twilkers1976/Omnisensor-dsp-board/README.md

# omnisensorv2
kicad 10.03 schematic and pcb project
#omni_cpu_board
