twilkers1976/Omnisensor-dsp-board/bom.csv

Qty | Reference | Value | Part Number | Manufacturer | Rating | Footprint | Datasheet | DNP
72 | C1,C2,C3,C4,C5,C6,C13,C14,C15,C16,C17,C18,C19,C20,C21,C22,C23,C24,C25,C26,C27,C28,C29,C30,C31,C32,C33,C34,C37,C40,C61,C63,C65,C66,C67,C68,C69,C70,C87,C88,C89,C91,C122,C123,C124,C141,C143,C144,C145,C146,C147,C148,C149,C150,C151,C152,C153,C154,C155,C160,C237,C238,C241,C242,C248,C250,C253,C259,C263,C268,C269,C270 | 0.1uf | 04025C104KAT2A | Kyocera AVX | 50V | Capacitor_SMD:C_0402_1005Metric | ~
11 | C7,C8,C9,C10,C11,C12,C113,C114,C115,C135,C158 | 10uf | EMK212BJ106KG-T | Taiyo Yuden | 16V | Capacitor_SMD:C_0805_2012Metric | https://mm.digikey.com/Volume0/opasdata/d220001/medias/docus/8412/587_mlcc01hqAUTOe.pdf
43 | C35,C36,C38,C39,C41,C42,C43,C44,C45,C46,C47,C48,C49,C50,C51,C52,C55,C56,C57,C58,C59,C60,C76,C77,C79,C80,C81,C82,C83,C84,C85,C86,C90,C92,C116,C239,C240,C244,C245,C249,C252,C254,C257 | 0.01uf | 04025C103KAT2A | Kyocera AVX | 50V | Capacitor_SMD:C_0402_1005Metric | ~
2 | C53,C140 | 1000pf | CHV1808N3K0102MXT | Samsung Electro-Mechanics | 3KV | Capacitor_SMD:C_1808_4520Metric | https://mm.digikey.com/Volume0/opasdata/d220001/medias/docus/658/CL10B473KO8NNNC_Spec.pdf
1 | C54 | 0.047uf | CL10B473KO8NNNC | Samsung Electro-Mechanics | 16V | Capacitor_SMD:C_0603_1608Metric | https://mm.digikey.com/Volume0/opasdata/d220001/medias/docus/658/CL10B473KO8NNNC_Spec.pdf
3 | C62,C71,C74 | 10uf | GRM188R61C106MAALD | Murata | 16V | Capacitor_SMD:C_0603_1608Metric | ~
6 | C64,C119,C121,C136,C137,C142 | 1.0uf | EMK105BJ105KV-F | Taiyo Yuden | 16V | Capacitor_SMD:C_0402_1005Metric | https://mm.digikey.com/Volume0/opasdata/d220001/medias/docus/272/mlcc02_e-1307760.pdf
1 | C72 | 22uf | C1608X5R0J226M080AC | Murata | 6.3V | Capacitor_SMD:C_0603_1608Metric | ~
1 | C73 | 4.7uf | JMK105BBJ475MV-F | Taiyo Yuden | 6.3V | Capacitor_SMD:C_0402_1005Metric | ~
1 | C75 | 220uf | GMC31X5R227M6R3NT | Cal-chip | 6.3V | Capacitor_SMD:C_1206_3216Metric | ~
1 | C78 | 100pf | KGM05AR71H101KH | Kyocera AVX | 50V | Capacitor_SMD:C_0402_1005Metric | ~
1 | C93 | 100pf | CHV0603N250101FCT | Cal Chip | 250V | Capacitor_SMD:C_0603_1608Metric | https://calchip.com/wp-content/uploads/2026/01/CHV-Series.pdf
1 | C94 | 0.047uf | C0805C473F4GACTU | Kemet | 16V | Capacitor_SMD:C_0805_2012Metric | https://mm.digikey.com/Volume0/opasdata/d220001/medias/docus/658/CL10B473KO8NNNC_Spec.pdf
1 | C95 | 0.01uf | KGM15AR71C103KT | Kyocera AVX | 16V | Capacitor_SMD:C_0603_1608Metric | https://mm.digikey.com/Volume0/opasdata/d220001/medias/docus/658/CL10B473KO8NNNC_Spec.pdf
1 | C96 | 10uf | PCV2A100MCL1GS | Nichicon | 100V | omnisensor:PNSC-FT-V-83x83-2_V | https://www.nichicon.co.jp/english/series_items/catalog_pdf/e-pcv.pdf
1 | C97 | 2.2uf | GRM32ER72A225KA35L | Murata | 100V | Capacitor_SMD:C_1210_3225Metric | https://datasheets.kyocera-avx.com/KGM_X7R.pdf
2 | C98,C107 | 10uf | C1206C106M4RACAUTO | KEMET | 16V | Capacitor_SMD:C_1206_3216Metric | https://datasheets.kyocera-avx.com/KGM_X7R.pdf,https://mm.digikey.com/Volume0/opasdata/d220001/medias/docus/8890/CL31B106MOHNNNE.pdf
1 | C99 | 0.1uf | KGM15BR71H104KT | Kyocera AVX | 50V | Capacitor_SMD:C_0603_1608Metric | https://calchip.com/wp-content/uploads/2026/01/CHV-Series.pdf
5 | C100,C105,R82,R96,R100 | DNP-OPT |  | Vishay Dale | 1/4 W,2KV | Capacitor_SMD:C_0402_1005Metric,Capacitor_SMD:C_1812_4532Metric,Resistor_SMD:R_0603_1608Metric,Resistor_SMD:R_0805_2012Metric,Resistor_SMD:R_1206_3216Metric | https://www.vishay.com/docs/20035/dcrcwe3.pdf | DNP
1 | C101 | 3.3nf | C0603C332J4GACTU | Kemet | 16V | Capacitor_SMD:C_0603_1608Metric | https://calchip.com/wp-content/uploads/2026/01/CHV-Series.pdf
1 | C102 | 47pf | CHV1206N1K0470FCT | Cal Chip | 1KV | Capacitor_SMD:C_1206_3216Metric | https://calchip.com/wp-content/uploads/2026/04/GMC-Series-1.pdf
1 | C103 | 220pf | CHV0603N250221GCT | Cal Chip | 250V | Capacitor_SMD:C_0603_1608Metric | https://calchip.com/wp-content/uploads/2026/01/CHV-Series.pdf
5 | C104,C235,C236,C251,C256 | 1uf | 06035C105KAT2A | Kyocera AVX | 50V | Capacitor_SMD:C_0603_1608Metric
1 | C106 | 4.7nf | 885012210005 | Wurth Elektronik | 25V | Capacitor_SMD:C_1812_4532Metric | https://www.we-online.com/components/products/datasheet/885012210005.pdf
1 | C108 | 470pf | GRM31A7U2J471JW31D | Murata | 600V | Capacitor_SMD:C_1206_3216Metric | https://calchip.com/wp-content/uploads/2026/04/GMC-Series-1.pdf
1 | C109 | 2.2nf | GRM188R72A222KA01D | Murata | 25V | Capacitor_SMD:C_0603_1608Metric | https://www.we-online.com/components/products/datasheet/885012210005.pdf
2 | C110,C112 | DNP-OPT | C1206C106M4RACAUTO | KEMET | 16V | Capacitor_SMD:C_1206_3216Metric | https://datasheets.kyocera-avx.com/KGM_X7R.pdf | DNP
1 | C111 | 22uf | 16SVP22M | Panasonic | 16V | omnisensor:CAP_16SVP22M | https://industrial.panasonic.com/ww/products/pt/os-con/models/16SVP22M
2 | C117,C118 | 4700pf | GCM155R71H472KA37D | Murata | 50V | Capacitor_SMD:C_0402_1005Metric | ~
1 | C120 | 3000pf | GMC04X7R302K50NT | Murata | 50V | Capacitor_SMD:C_0402_1005Metric | ~
11 | C125,C126,C127,C128,C129,C130,C131,C132,C133,C156,C157 | 47uf | JMK212BJ476MG-T | Taiyo Yuden | 6.3V | Capacitor_SMD:C_0805_2012Metric | ~
5 | C134,C260,C261,C262,C264 | 4.7uf | CL10A475MA8NQNC | Kyocera | 25V | Capacitor_SMD:C_0603_1608Metric | ~
1 | C138 | 4.7uf | C1210C475K3RACTU | Kemet | 25V | Capacitor_SMD:C_1210_3225Metric | https://mm.digikey.com/Volume0/opasdata/d220001/medias/docus/8412/587_mlcc01hqAUTOe.pdf
1 | C139 | 120uf | A700X127M010ATE010 | KEMET | 10V | omnisensor:CAP_X-7343-43_KEM | https://yageogroup.com/content/datasheet/asset/file/KEM_T2091_A700-A720
1 | C159 | 12nf | GCM155R71H122KA37D | Murata | 50V | Capacitor_SMD:C_0402_1005Metric | ~
3 | C233,C234,C255 | 4.7uf | CL21A475KBQNNNE | Murata | 50V | Capacitor_SMD:C_0805_2012Metric
1 | C294 | 1uf | CL21B105KOFVPNE | Samsung | 16V | Capacitor_SMD:C_0805_2012Metric | https://mm.digikey.com/Volume0/opasdata/d220001/medias/docus/658/CL10B473KO8NNNC_Spec.pdf
1 | D1 | DDZ9709S-7 | DDZ9709S-7 | Diodes Incorporated | 24V | omnisensor:DDZ9709S-7
3 | D2,D5,D7 | PTVS58VS1UR,115 | PTVS58VS1UR,115 | Nexperia |  | omnisensor:TVS_PTVS58VS1UR | https://assets.nexperia.com/documents/data-sheet/PTVSXS1UR_SER.pdf
1 | D3 | 1SS389,L3F | 1SS389,L3F | Comchip |  | Diode_SMD:D_SOD-523 | https://www.digikey.com/en/products/detail/comchip-technology/1SS389-G/6138895
1 | D4 | B2100-13-F | B2100-13-F | Diodes Inc |  | omnisensor:DIOM5336X250N | https://www.diodes.com/part/view/B2100
1 | D6 | BAV19WS | BAV19WS | Diotec |  | Diode_SMD:D_SOD-323F | https://diotec.com/request/datasheet/bav19ws.pdf
1 | D8 | BAT46WJ_115 | BAT46WJ,115 | Nexperia |  | omnisensor:SOD323_V | https://assets.nexperia.com/documents/data-sheet/BAT46WJ.pdf
1 | D9 | DNP-OPT | BAT46WJ_115 | Nexperia |  | omnisensor:SOD323_V | https://assets.nexperia.com/documents/data-sheet/BAT46WJ.pdf | DNP
1 | D10 | SI4204DY-T1-GE3 | SI4204DY-T1-GE3 | Vishay Siliconix |  | omnisensor:SOIC8_MS-012_VIS | https://www.vishay.com/docs/65154/si4204dy.pdf
1 | D11 | CDBA340-G | CDBA340-G | ComChip |  | omnisensor:CDBA-G | https://mm.digikey.com/Volume0/opasdata/d220001/medias/docus/916/CDBA320-G_%7E_CDBA3100-G.pdf
1 | D12 | MBR0540T1G | MBR0540T1G | onsemi |  | omnisensor:SOD-123 | https://www.onsemi.com/pdf/datasheet/mbr0540t1-d.pdf
4 | D13,D16,D21,D25 | Red | B1911USD-20D000114U1930 | Harvatek |  | omnisensor:LED_B1931NG_HVK | B1931NG--20D001114U1930
5 | D14,D17,D18,D19,D22 | Green | B1931NG--20D001114U1930 | Harvatek |  | omnisensor:LED_B1931NG_HVK | B1931NG--20D001114U1930
2 | D15,D20 | Yellow | KY EELP41.22 Q2T1-36-A8J8-020-R18 | OSRAM |  | omnisensor:LED_B1931NG_HVK | B1931NG--20D001114U1930
1 | D23 | RGB LED | UHD111A-FKA-C3K23E1L3VG5ZB3Z3 | Cree LED |  | omnisensor:SMD4_UHD111A-FKA_CRW | UHD111A-FKA-C3K23E1L3VG5ZB3Z3
1 | D24 | Blue | B19Y1NB--20C000113U1930 | Harvatek |  | omnisensor:LED_B1931NG_HVK | B1931NG--20D001114U1930
1 | E1 | AUX+ | MILLMAX 2501-2 |  |  | TestPoint:TestPoint_THTPad_D1.0mm_Drill0.5mm
1 | E2 | AUX- | MILLMAX 2501-2 |  |  | TestPoint:TestPoint_THTPad_D1.0mm_Drill0.5mm
1 | E4 | GND_SEC | MILLMAX 2501-2 |  |  | TestPoint:TestPoint_THTPad_D1.0mm_Drill0.5mm
1 | E5 | GND | MILLMAX 2501-2 |  |  | TestPoint:TestPoint_THTPad_D1.0mm_Drill0.5mm
5 | FB1,FB2,FB3,FB8,FB9 | MPZ2012S101AT000 | MPZ2012S101AT000 | TDK | 4A, 100 ohm,4A, 100ohm | Inductor_SMD:L_0805_2012Metric | https://product.tdk.com/system/files/dam/doc/product/emc/emc/beads/catalog/beads_commercial_power_mpz2012_en.pdf
4 | FB4,FB5,FB6,FB7 | 600 | 742863160 | Würth Elektronik |  | Inductor_SMD:L_0603_1608Metric_Pad1.05x0.95mm_HandSolder | https://www.digikey.com/en/products/detail/w%C3%BCrth-elektronik/742863160/2268591
1 | J1 | JXK0-0190NL | JXK0-0190NL | Pulse |  | omnisensor:JK0-0177NL_PUL | https://yageogroup.com/content/datasheet/asset/file/DATASHEET_J432
1 | J2 | BMODE | 2PH1-03-UA | Adam Tech |  | Connector_PinHeader_2.00mm:PinHeader_1x03_P2.00mm_Vertical | https://www.digikey.com/en/products/detail/adam-tech/2PH1-03-UA/9830409?s=N4IgTCBcDa4AoAkCMBaADAZhQVQIIgF0BfIA
1 | J3 | JTAG | 3220-10-0300-00 | CNC Tech |  | omnisensor:CNC_3220-10-0300-00 | ~
2 | J4,J20 | USB4105-GF-A | USB4105-GF-A | GCT |  | omnisensor:GCT_USB4105-GF-A | https://gct.co/files/specs/usb4105-spec.pdf
1 | J5 | 2PH1-02-UA | 2PH1-02-UA | Adam Tech |  | Connector_PinHeader_2.00mm:PinHeader_1x02_P2.00mm_Vertical | https://app.adam-tech.com/products/download/data_sheet/200457/2ph1-xx-ua-data-sheet.pdf
1 | J6 | DNP-PH1RB-09-UA | PH1RB-09-UA | Adam Tech |  | Connector_PinHeader_2.54mm:PinHeader_1x09_P2.54mm_Vertical | https://www.adafruit.com/product/4682 | DNP
1 | J7 | TSW-102-07-F-S | TSW-102-07-F-S | Samtec | 3A | Connector_PinHeader_2.54mm:PinHeader_1x02_P2.54mm_Vertical
1 | J8 | 2PH2R-10-UA | 2PH2R-10-UA | Adam Tech |  | Connector_PinHeader_2.00mm:PinHeader_2x05_P2.00mm_Vertical | https://app.adam-tech.com/products/download/data_sheet/199986/2ph2r-xx-ua-data-sheet.pdf
1 | J9 | SM04B-SRSS-TB | SM04B-SRSS-TB | JST |  | omnisensor:JST_SM04B-SRSS-TB(LF)(SN) | https://www.jst-mfg.com/product/pdf/eng/eSH.pdf
1 | J10 | EJ508A | EJ508A | MPD |  | omnisensor:MPD_EJ508A | https://www.memoryprotectiondevices.com/datasheets/EJ508A/EJ508A-datasheet.pdf
1 | J11 | DNP-PH1RB-05-UA | PH1RB-05-UA | Adam Tech |  | Connector_PinHeader_2.54mm:PinHeader_1x05_P2.54mm_Vertical | https://www.adafruit.com/product/6250 | DNP
2 | J12,J17 | TBP03R1-350-02BE | TBP03R1-350-02BE | Same Sky |  | omnisensor:CUI_TBP03R1-350-02BE | https://www.sameskydevices.com/product/resource/tbp03r1-350.pdf
1 | J14 | 2PH1R-05-UA | 2PH1R-05-UA | Adam Tech |  | Connector_PinHeader_2.00mm:PinHeader_1x05_P2.00mm_Vertical | https://www.adafruit.com/product/6250
1 | J16 | 0791091011 | 0791091011 | Molex |  | Connector_PinSocket_2.00mm:PinSocket_2x12_P2.00mm_Vertical_SMD | https://www.molex.com/content/dam/molex/molex-dot-com/products/automated/en-us/salesdrawingpdf/791/79109/791091011_sd.pdf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
1 | K1 | 1462042-3 | 1462042-3 | TE Connectivity |  | omnisensor:1462042-3 | https://www.te.com/commerce/DocumentDelivery/DDEController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
1 | L1 | 744272332 | 744272332 | Würth Elektronik |  | omnisensor:WE-SL5_BIFILAR | https://www.we-online.com/components/products/datasheet/744272332.pdf
1 | L2 | 10uh | DO1608C-103MLC | Coilcraft | 1.5A | omnisensor:IND_DO1608C_COC | https://www.coilcraft.com/getmedia/4cc14c66-6f6e-44d5-bdfa-285965aec659/do1608c.pdf
1 | L3 | 100uh | DO1608C-104MLC | Coilcraft | 500mA | omnisensor:IND_DO1608C_COC | https://www.coilcraft.com/getmedia/4cc14c66-6f6e-44d5-bdfa-285965aec659/do1608c.pdf
1 | L4 | 330nh | DO1813H-331MLD | Coilcraft | 7A | omnisensor:DO1813H | https://www.coilcraft.com/getmedia/eceb5548-303f-4cbf-872a-303f3b222949/do1813h.pdf
1 | L5 | 3.3uH | 74438335033HT | Würth Elektronik | 2.7A | omnisensor:WE-MAPI_3015 | https://www.we-online.com/components/products/datasheet/74438335033HT.pdf
1 | L6 | 1uH | 74438335010HT | Würth Elektronik | 4.5A | omnisensor:WE-MAPI_3015 | https://www.we-online.com/components/products/datasheet/74438335010HT.pdf
1 | L7 | 2.2uH | 74438335022HT | Würth Elektronik | 3.2A | omnisensor:WE-MAPI_3015 | https://www.we-online.com/components/products/datasheet/74438335022HT.pdf
1 | L8 | 33uH | 74438335330 | Würth Elektronik | 500mA | omnisensor:WE-MAPI_3015 | https://www.we-online.com/components/products/datasheet/74438335330.pdf
9 | Q1,Q2,Q3,Q4,Q5,Q6,Q7,Q8,Q9 | PSMN075-100MSE | PSMN075-100MSE | Nexperia |  | omnisensor:TRANS_PSMN075-100MSE | https://assets.nexperia.com/documents/data-sheet/PSMN075-100MSE.pdf
1 | Q10 | FJV992FMTF | FJV992FMTF | Onsemi |  | omnisensor:SOT91P240X120-3N | https://www.onsemi.com/pdf/datasheet/fjv992-d.pdf
1 | Q11 | XP10TN135N | XP10TN135N | YAGEO SEMI |  | omnisensor:SOT95P251X112-3N | https://www.mouser.com/datasheet/3/508/1/XP10TN135N.pdf
1 | Q12 | BSZ520N15NS3G | BSZ520N15NS3GATMA1 | Infineon |  | omnisensor:SON65P330X330X110-9N | https://www.infineon.com/assets/row/public/documents/24/49/infineon-bsz520n15ns3-ds-en.pdf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
1 | Q13 | MMBT3906 | MMBT3906 | Diotec Semiconductor |  | Package_TO_SOT_SMD:SOT-23 | https://www.onsemi.com/pdf/datasheet/pzt3906-d.pdf
1 | Q14 | FDMC86160 | FDMC86160 | Onsemi |  | omnisensor:TRANS_FDMC86102 | https://www.onsemi.com/pdf/datasheet/fdmc86160-d.pdf
1 | Q15 | MMBT3904 | MMBT3904 | Diotec Semiconductor |  | Package_TO_SOT_SMD:SOT-23 | https://www.onsemi.com/pdf/datasheet/pzt3904-d.pdf
1 | Q16 | PUMH13 | PUMH13 | Nexperia |  | omnisensor:SOP65P210X110-6N | https://assets.nexperia.com/documents/data-sheet/PUMH13.pdf
4 | R1,R2,R3,R4 | 75 | RN73H1JTTD75R0F100 | KOA |  | Resistor_SMD:R_0603_1608Metric | ~
7 | R5,R45,R59,R81,R85,R101,R103 | 0 | RMCF0402ZT0R00 | Stackpole |  | Resistor_SMD:R_0402_1005Metric | https://www.vishay.com/docs/20035/dcrcwe3.pdf,~
10 | R6,R7,R8,R9,R10,R11,R12,R13,R14,R16 | 3.3K | RMCF0402FT3K3 | Stackpole |  | Resistor_SMD:R_0402_1005Metric | ~
25 | R15,R17,R18,R19,R20,R21,R22,R31,R33,R35,R39,R40,R41,R62,R121,R122,R123,R131,R132,R226,R227,R228,R229,R230,R231 | 33 | RMCF0402FT33R0 | Stackpole |  | Resistor_SMD:R_0402_1005Metric | ~
7 | R23,R24,R25,R66,R67,R68,R257 | 1.0K | RMCF0402FT1K00 | Stackpole | 1/16 W | Resistor_SMD:R_0402_1005Metric | ~
45 | R26,R27,R28,R29,R34,R36,R37,R38,R48,R49,R50,R51,R52,R83,R86,R108,R111,R113,R117,R120,R124,R125,R126,R127,R128,R129,R130,R137,R138,R140,R232,R235,R236,R238,R240,R289,R290,R291,R292,R293,R294,R295,R296,R297,R298 | 10K | RMCF0402FT10K0 | Stackpole |  | Resistor_SMD:R_0402_1005Metric | ~
3 | R30,R32,R133 | DNP-33 | RMCF0402FT33R0 | Stackpole |  | Resistor_SMD:R_0402_1005Metric | ~ | DNP
1 | R42 | 3.01k | RMCF0402FT3K01 | Stackpole |  | Resistor_SMD:R_0402_1005Metric
4 | R43,R44,R46,R47 | 2K | RMCF0402FT2K00 | Stackpole |  | Resistor_SMD:R_0402_1005Metric | ~
2 | R53,R63 | DNP-10K | RMCF0402FT10K | Stackpole |  | Resistor_SMD:R_0402_1005Metric | ~ | DNP
7 | R54,R55,R56,R57,R58,R135,R136 | 100 | RMCF0402FT100R | Stackpole |  | Resistor_SMD:R_0402_1005Metric | ~
1 | R60 | DNP-0 | RMCF0603FT0R | Stackpole |  | Resistor_SMD:R_0603_1608Metric | ~ | DNP
1 | R61 | 2K | RMCF0402FT2K0 | Stackpole |  | Resistor_SMD:R_0402_1005Metric | ~
1 | R64 | 34 | RMCF0402FT34R0 | Stackpole |  | Resistor_SMD:R_0402_1005Metric | ~
1 | R65 | 240 | RMCF0402FT240R | Stackpole |  | Resistor_SMD:R_0402_1005Metric | ~
1 | R69 | 200 | RMCF0402FT200R | Stackpole |  | Resistor_SMD:R_0402_1005Metric | ~
1 | R70 | 174K | RN73H1JTTD1743F100 | KOA |  | Resistor_SMD:R_0603_1608Metric | https://www.koaspeer.com/pdfs/RN73H.pdf
1 | R71 | 53.2K | RN73H1JTTD5232F100 | KOA |  | Resistor_SMD:R_0603_1608Metric | https://www.koaspeer.com/pdfs/RN73H.pdf
1 | R72 | 8.2 | CRCW08058R20FKEA | Vishay Dale | 1/4 Watt | Resistor_SMD:R_0805_2012Metric | https://www.vishay.com/docs/20035/dcrcwe3.pdf
1 | R73 | 3.3K | RN73H1JTTD3301F100 | KOA | 1/10 Watt | Resistor_SMD:R_0603_1608Metric | https://www.vishay.com/docs/20035/dcrcwe3.pdf
2 | R74,R119 | 2K | RN73H1JTTD2001F100 | KOA | 1/10 W | Resistor_SMD:R_0603_1608Metric | https://www.vishay.com/docs/20035/dcrcwe3.pdf
1 | R75 | 6.49K | RN73H1JTTD6491F100 | KOA | 1/10 W | Resistor_SMD:R_0603_1608Metric | https://www.koaspeer.com/pdfs/RN73H.pdf
1 | R76 | DNP-OPT | RN73H1JTTD1001F100 | KOA | 1/10 W | Resistor_SMD:R_0603_1608Metric | https://www.vishay.com/docs/20035/dcrcwe3.pdf
1 | R77 | 35.7 | CRCW080535R7FKEA | Vishay Dale | 1/4 W | Resistor_SMD:R_0805_2012Metric | https://www.vishay.com/docs/20035/dcrcwe3.pdf
1 | R78 | 5.23K | RN73H1JTTD5231F100 | KOA | 1/10 W | Resistor_SMD:R_0603_1608Metric | https://www.koaspeer.com/pdfs/RN73H.pdf
1 | R79 | 20 | CRCW080520R0FKEA | Vishay Dale | 1/4 Watt | Resistor_SMD:R_0805_2012Metric | https://www.vishay.com/docs/20035/dcrcwe3.pdf
1 | R80 | 107K | RN73H1JTTD1073F100 | KOA | 1/4 W | Resistor_SMD:R_0603_1608Metric | https://www.seielect.com/catalog/SEI-RNCP.pdf
1 | R84 | 26.1K | RN73H1JTTD2612F100 | KOA |  | Resistor_SMD:R_0603_1608Metric | https://www.koaspeer.com/pdfs/RN73H.pdf
1 | R87 | 150 | RK73H2BTTD1500F | KOA | 1/4 W | Resistor_SMD:R_1206_3216Metric | https://www.seielect.com/catalog/SEI-RNCP.pdf
1 | R88 | 40m | PE0603FRF070R04L | Yageo | 1/10 W | Resistor_SMD:R_0603_1608Metric | https://www.vishay.com/docs/20035/dcrcwe3.pdf
1 | R89 | 100 | RN73H1JTTD1000F100 | KOA | 1/10 W | Resistor_SMD:R_0603_1608Metric | https://www.vishay.com/docs/20035/dcrcwe3.pdf
2 | R90,R91 | 27 | CRCW120627R0FKEAC | Vishay Dale | 1/4 W | Resistor_SMD:R_1206_3216Metric | https://www.seielect.com/catalog/SEI-RNCP.pdf
1 | R92 | 47K | RN73H1JTTD4702F100 | KOA | 1/10 W | Resistor_SMD:R_0603_1608Metric | ~
1 | R93 | 4.7K | RN73H1JTTD4701F100 | KOA | 1/10 W | Resistor_SMD:R_0603_1608Metric | ~
1 | R94 | 15 | RN73H1JTTD15R0F100 | KOA | 1/10 W | Resistor_SMD:R_0603_1608Metric | https://www.vishay.com/docs/20035/dcrcwe3.pdf
1 | R95 | 10K | RN73H1JTTD1002F100 | KOA | 1/10W | Resistor_SMD:R_0603_1608Metric
1 | R97 | 3.3K | RMCF0402FT3K30 | KOA | 1/10 W | Resistor_SMD:R_0402_1005Metric | https://www.vishay.com/docs/20035/dcrcwe3.pdf
2 | R98,R107 | 32.4K | RMCF0402FT32K4 | Stackpole |  | Resistor_SMD:R_0402_1005Metric | ~
1 | R99 | 4.3K | RMCF0402FT4K30 | Stackpole |  | Resistor_SMD:R_0402_1005Metric | ~
5 | R102,R104,R114,R246,R247 | 5.1K | RMCF0402FT5K10 | Stackpole |  | Resistor_SMD:R_0402_1005Metric | ~
2 | R105,R106 | 22K | RMCF0402FT22K0 | Stackpole |  | Resistor_SMD:R_0402_1005Metric | ~
1 | R109 | 3.74K | RMCF0402FT3K74 | Stackpole |  | Resistor_SMD:R_0402_1005Metric | ~
1 | R110 | 31.6K | RMCF0402FT31K6 | Stackpole |  | Resistor_SMD:R_0402_1005Metric | ~
1 | R112 | 8.66K | RMCF0402FT8K66 | Stackpole |  | Resistor_SMD:R_0402_1005Metric | ~
2 | R115,R250 | 1M | RMCF0402FT1M00 | Stackpole |  | Resistor_SMD:R_0402_1005Metric | ~
2 | R116,R252 | PTC | 0603L050YR | Littlefuse |  | Resistor_SMD:R_0603_1608Metric | ~
2 | R118,R303 | 0 | RMCF0805ZT0R00 | Stackpole |  | Resistor_SMD:R_0805_2012Metric | ~
2 | R134,R142 | 0 | RMCF1210ZT0R00 | Stackpole |  | Resistor_SMD:R_1210_3225Metric | ~
1 | R139 | 52.3K | RMCF0402FT52K3 | Stackpole |  | Resistor_SMD:R_0402_1005Metric | ~
1 | R141 | 35.8K | RMCF0402FT35K7 | Stackpole |  | Resistor_SMD:R_0402_1005Metric | ~
2 | R224,R225 | 1.5k | RMCF0402FT1K50 | Stackpole |  | Resistor_SMD:R_0402_1005Metric
3 | R237,R239,R241 | DNP-10K | RMCF0402FT10K0 | Stackpole |  | Resistor_SMD:R_0402_1005Metric |  | DNP
2 | R242,R243 | 680 | RMCF0402FT680R | Stackpole |  | Resistor_SMD:R_0402_1005Metric
1 | R244 | 124.0k | RMCF0402FT124K | Stackpole |  | Resistor_SMD:R_0402_1005Metric
1 | R245 | 100k | RMCF0402FT100K | Stackpole |  | Resistor_SMD:R_0402_1005Metric
1 | R254 | 22.1K | RMCF0402FT22K1 | Stackpole |  | Resistor_SMD:R_0402_1005Metric | ~
1 | R255 | 47.5K | RMCF0402FT47K5 | Stackpole |  | Resistor_SMD:R_0402_1005Metric | ~
6 | RN1,RN2,RN3,RN4,RN5,RN6 | 100 ohm | EXB-28V101JX | Panasonic |  | omnisensor:RESCAXS50P200X100X45-8N | ~
3 | RV1,RV2,RV3 | SDV1608E140C300NPT | SDV1608E140C300NPT | Shenzhen Sunlord |  | Resistor_SMD:R_0603_1608Metric | https://media.digikey.com/pdf/Data%20Sheets/Shenzhen%20Sunlord/SDV_Part_Numbering.pdf
3 | S1,S2,S3 | R-667843 | R-667843 | Mitsumi |  | omnisensor:R-667843_MIT | https://mm.digikey.com/Volume0/opasdata/d220001/medias/docus/2604/SOV-168HNT_7843_1.9N_ENG_%2319.pdf
1 | T1 | 750310742 | 750310742 | Würth Elektronik |  | omnisensor:WE-POE__EP13_PADL1.55W1.27 | https://www.we-online.com/components/products/datasheet/750310742.pdf
1 | T2 | PE-68386NL | PE-68386NL | Pulse Electronics Corporation |  | omnisensor:PE-68386NL_PUL | PE-68386NL
2 | TH1,TH2 | Thermistor_PTC | V5.5MLA0603NH | Littlefuse |  | Resistor_SMD:R_0603_1608Metric_Pad0.98x0.95mm_HandSolder | ~
4 | TP1,TP2,TP3,TP5 | TestPoint |  |  |  | TestPoint:TestPoint_Pad_D1.0mm
1 | TP4 | TP_12V |  |  |  | TestPoint:TestPoint_Pad_D1.0mm
1 | U1 | LT4321IUF_PBF | LT4321IUF#PBF | Analog Devices |  | omnisensor:LT4321IUF_PBF
1 | U2 | ADSP-SC573KBCZ-3 | ADSP-SC573KBCZ-3 | Analog Devices |  | omnisensor:BC-400-2_ADI | ADSP-SC573KBCZ-3
1 | U3 | SI5351B-B-GM | SI5351B-B-GM | Silicon Labs |  | omnisensor:QFN50P400X400X90-21N | https://www.skyworksinc.com/-/media/Skyworks/SL/documents/public/data-sheets/Si5351-B.pdf
1 | U4 | ADM6315 | ADM6315-29D2ARTZR7 | Analog Devices |  | omnisensor:RA_4_ADI | https://www.analog.com/media/en/technical-documentation/data-sheets/ADM6315.pdf
1 | U5 | MIC5166YML-TR | MIC5166YML-TR | Microchip |  | omnisensor:MLF-10_ML_MCH | https://ww1.microchip.com/downloads/aemDocuments/documents/OTH/ProductDocuments/DataSheets/MIC5166-3A-High-Speed-Low-VIN-DDR-Terminator-DS20006085B.pdf
1 | U6 | IS43TR16128DL-125KBL | IS43TR16128DL-125KBL | ISSI |  | omnisensor:BGA80P96C6X16_800X1400X110
1 | U7 | LT4276BIUFDTRPBF | LT4276BIUFD#TRPBF | Analog Devices |  | omnisensor:QFN-28_UFD | https://www.analog.com/media/en/technical-documentation/data-sheets/4276fa.pdf
2 | U8,U34 | ESDA5V3SC6 | ESDA5V3SC6 | ST Microelectronics |  | omnisensor:SOT23-6L | https://www.digikey.com/en/products/detail/stmicroelectronics/ESDA5V3SC6/1037980
1 | U9 | MOC207M | MOC207M | FAIRCHILD SEMICONDUCTOR |  | omnisensor:SOIC8_751DZ_ONS_OSI | https://www.onsemi.com/pdf/datasheet/moc217m-d.pdf
1 | U10 | ADP5054ACPZ-R7 | ADP5054ACPZ-R7 | Analog Devices |  | omnisensor:CP_48_13_ADI | https://www.analog.com/media/en/technical-documentation/data-sheets/ADP5054.pdf
2 | U11,U36 | SP3003-02JTG | SP3003-02JTG | Littelfuse Inc. |  | omnisensor:SOT65P220X110-5N | https://www.littelfuse.com/assetdocs/littelfuse-tvs-diode-array-sp3003-datasheet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
1 | U12 | MIC2025-2YMM-TR | MIC2025-2YMM-TR | Microchip |  | omnisensor:MSOP-8_MM_MCH | https://ww1.microchip.com/downloads/aemDocuments/documents/OTH/ProductDocuments/DataSheets/MIC2025-2075-Single-Channel-Power-Distribution-Switch-DS20006030A.pdf
1 | U13 | SN74LVC2G241DCUR | SN74LVC2G241DCUR | Nexperia |  | omnisensor:DCU8 | https://www.ti.com/lit/gpn/sn74lvc2g241
1 | U15 | MAX31875R0TZS_T | MAX31875R0TZS+T | Maxim Integrated |  | omnisensor:BGA4N40P2X2_83X83X37N | https://www.analog.com/media/en/technical-documentation/data-sheets/max31875.pdf
1 | U16 | MX52LM04A11XSI | MX52LM04A11XSI | Macronix |  | omnisensor:BGA153N50P14X14_1300X1150X100N | https://www.mxic.com.tw/Lists/Datasheet/Attachments/9244/MX52LM04A11_Consumer,%203V,%204GB,%20v1.3.pdf
1 | U17 | W25Q128JVPIM | W25Q128JVPIM | Winbond |  | Package_SON:WSON-8-1EP_6x5mm_P1.27mm_EP3.4x4mm | https://www.winbond.com/resource-files/w25q128jv_dtr%20revc%2003272018%20plus.pdf
1 | U32 | ADIN1300CCPZ | ADIN1300CCPZ | Analog Devices |  | omnisensor:QFN50P600X600X80-41N | https://www.analog.com/media/en/technical-documentation/data-sheets/ADIN1300.pdf
1 | U33 | ADP123AUJZ-R7 | ADP123AUJZ-R7 | Analog Devices |  | omnisensor:UJ-5_ADI | https://www.analog.com/media/en/technical-documentation/data-sheets/ADP122_123.pdf
1 | U38 | CP2102N-A02-GQFN24R | CP2102N-A02-GQFN24R | Silicon Labs |  | omnisensor:QFN24_SIL-M | https://www.silabs.com/documents/public/data-sheets/cp2102n-datasheet.pdf
1 | Y1 | 25 Mhz | ABM8-25.000MHZ-10-B1U-T | Abracon |  | omnisensor:CRYSTAL_4SMD_3.2MM_2.5MM | ~
2 | Y2,Y3 | 25 Mhz | ECS-2520S33-250-FN-TR | ECS |  | omnisensor:OSC_4SMD_2.5MM_2.0MM | https://www.mouser.com/datasheet/3/294/1/ECS_2520S.pdf
