twilkers1976/Omnisensor-dsp-board/3d/MIC5166YML-TR.STEP

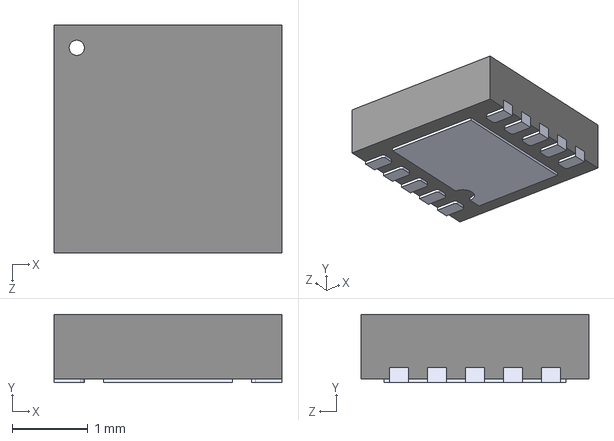
[picture p1: CAD file, 2026-10-08]
3d/MIC5166YML-TR.STEP
3.00 x 0.9 x 3.00 mm
