twilkers1976/Omnisensor-dsp-board/3d/SMB_DIO.step

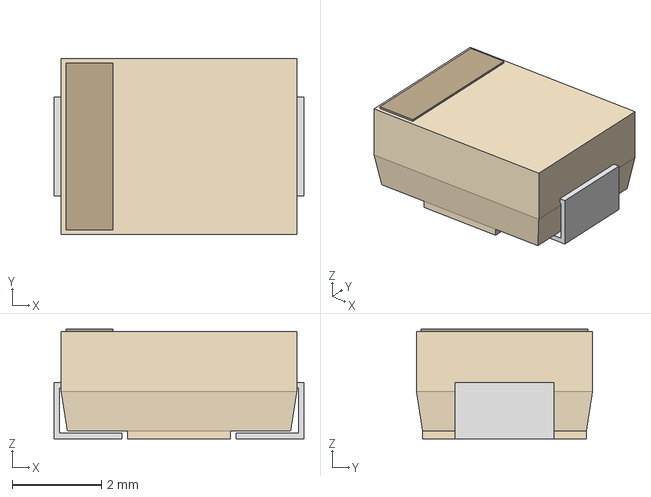
[picture p2: CAD file, 2026-10-08]
3d/SMB_DIO.step
5.59 x 3.94 x 2.45 mm
