twilkers1976/Omnisensor-dsp-board/3d/BC-400-2_ADI.step

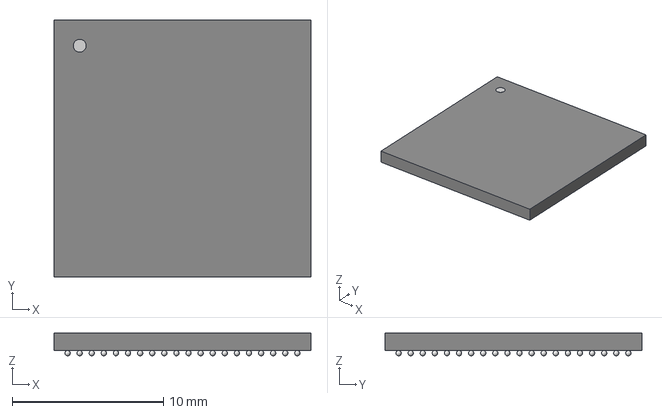
[picture p3: CAD file, 2026-10-08]
3d/BC-400-2_ADI.step
17.0 x 17.0 x 1.50 mm
