twilkers1976/Omnisensor-dsp-board/3d/2PH2R-10-UA.STEP

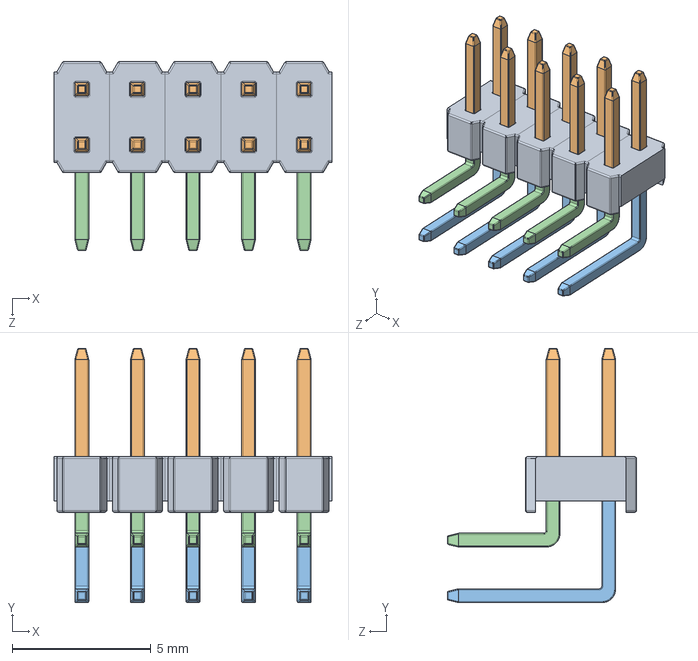
[picture p4: CAD file, 2026-10-08]
3d/2PH2R-10-UA.STEP
10.0 x 9.15 x 6.80 mm
