twilkers1976/Omnisensor-dsp-board/3d/EMMC08GML3601B00--3DModel-STEP-510211.STEP

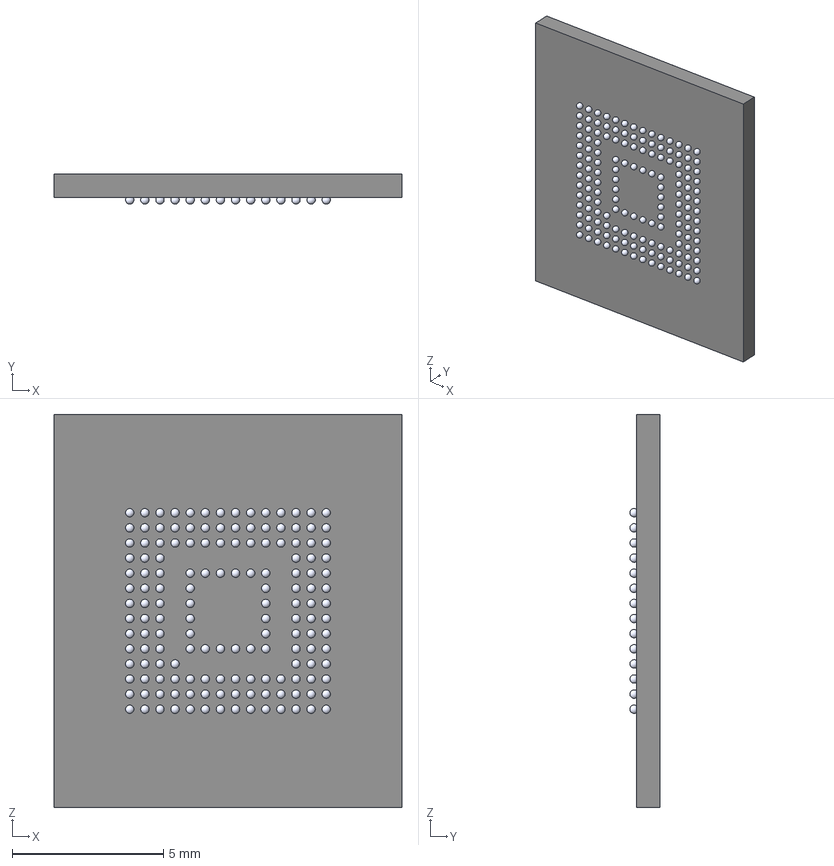
[picture p5: CAD file, 2026-10-08]
3d/EMMC08GML3601B00--3DModel-STEP-510211.STEP
11.5 x 1.00 x 13.0 mm
Body_Solid1
Body002_Solid1
BALL_0001
BALL_0002
BALL_0003
BALL_0004
BALL_0005
BALL_0006
BALL_0007
BALL_0008
BALL_0009
BALL_0010
BALL_0011
BALL_0012
BALL_0013
BALL_0014
BALL_0015
BALL_0016
BALL_0017
BALL_0018
BALL_0019
BALL_0020
BALL_0021
BALL_0022
BALL_0023
BALL_0024
BALL_0025
BALL_0026
BALL_0027
BALL_0028
BALL_0029
BALL_0030
BALL_0031
BALL_0032
BALL_0033
BALL_0034
BALL_0035
BALL_0036
BALL_0037
BALL_0038
BALL_0039
BALL_0040
BALL_0041
BALL_0042
BALL_0043
BALL_0044
BALL_0045
BALL_0046
BALL_0047
BALL_0048
BALL_0049
BALL_0050
BALL_0051
BALL_0052
BALL_0053
BALL_0054
BALL_0055
BALL_0056
BALL_0057
BALL_0058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
