twilkers1976/Omnisensor-dsp-board/3d/ADIN1300CCPZ.step

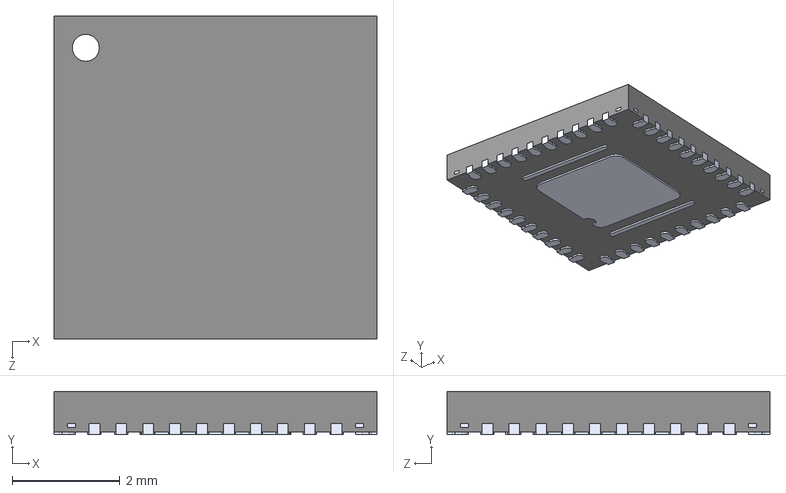
[picture p6: CAD file, 2026-10-08]
3d/ADIN1300CCPZ.step
6.00 x 0.8 x 6.00 mm
