twilkers1976/Omnisensor-dsp-board/3d/SOT23-6_MO-178AB_LTF.step

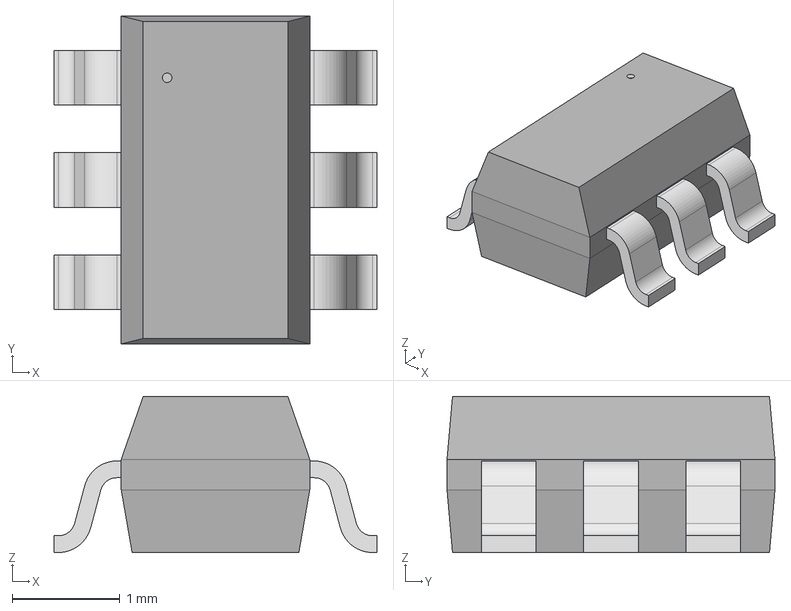
[picture p7: CAD file, 2026-10-08]
3d/SOT23-6_MO-178AB_LTF.step
3.00 x 3.05 x 1.45 mm
