twilkers1976/Omnisensor-dsp-board/3d/QFN24_SIL.step

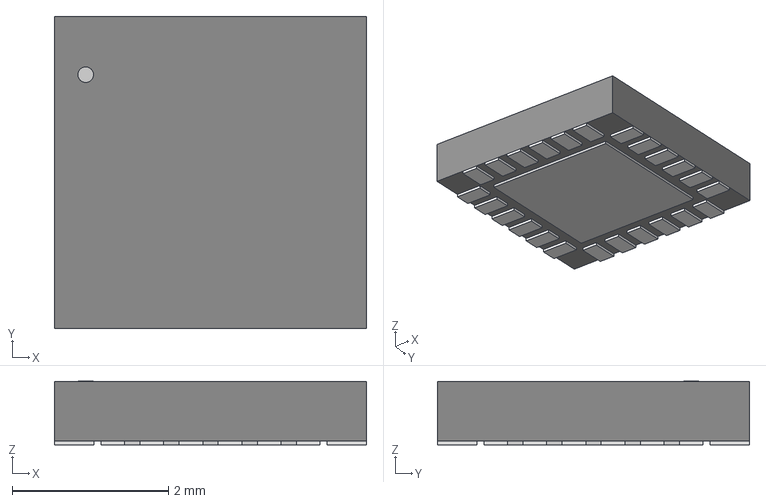
[picture p8: CAD file, 2026-10-08]
3d/QFN24_SIL.step
3.99 x 3.99 x 0.815 mm
