twilkers1976/Omnisensor-dsp-board/3d/MSOP-8_MM_MCH.step

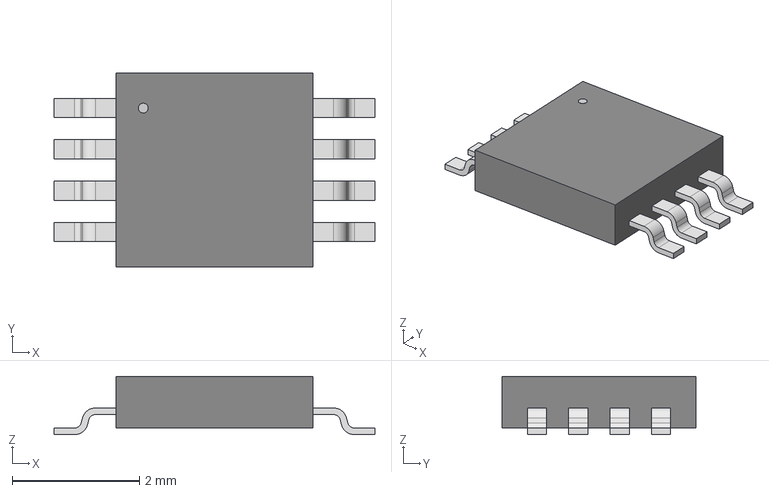
[picture p9: CAD file, 2026-10-08]
3d/MSOP-8_MM_MCH.step
5.05 x 3.05 x 0.917 mm
