twilkers1976/Omnisensor-dsp-board/3d/DO1813H.STEP

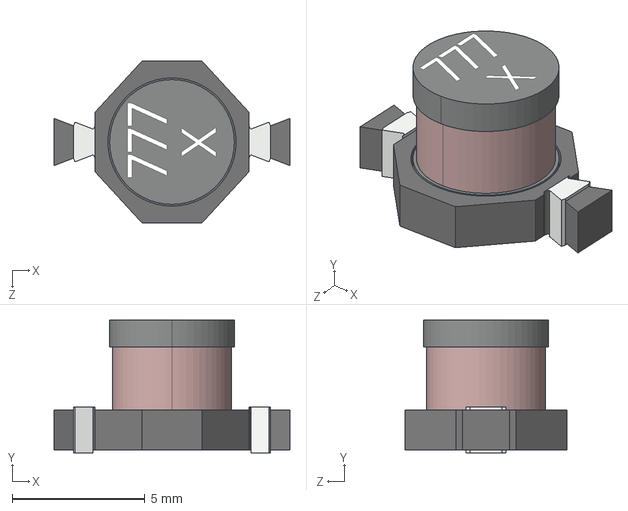
[picture p10: CAD file, 2026-10-08]
3d/DO1813H.STEP
8.89 x 5.00 x 6.10 mm
