twilkers1976/Omnisensor-dsp-board/3d/MOC207M.STEP

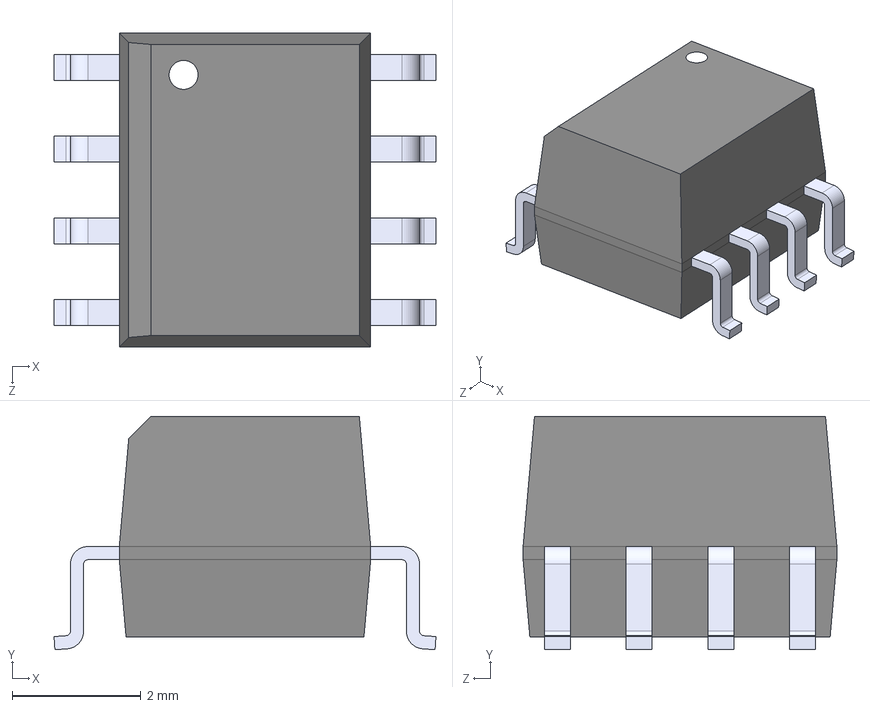
[picture p11: CAD file, 2026-10-08]
3d/MOC207M.STEP
5.94 x 3.63 x 4.88 mm
