twilkers1976/Omnisensor-dsp-board/3d/SC-90_SOD323F_NEX.step

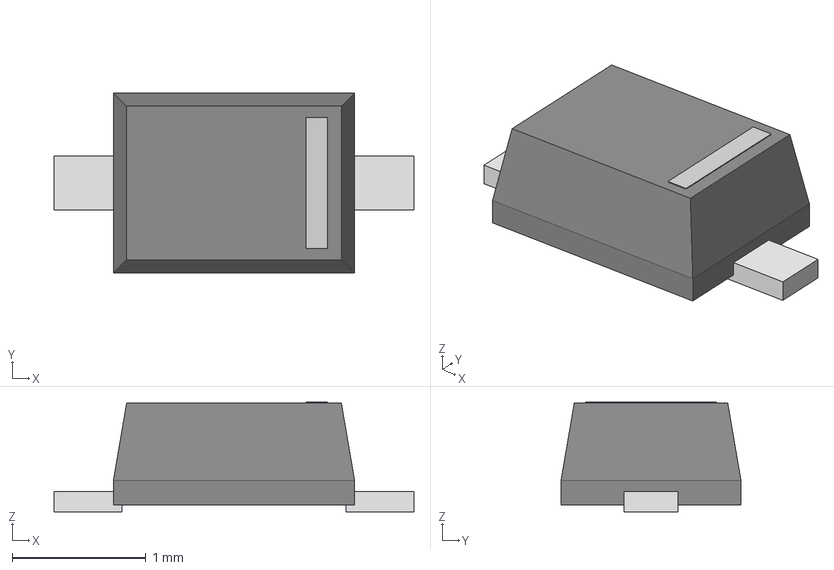
[picture p12: CAD file, 2026-10-08]
3d/SC-90_SOD323F_NEX.step
2.69 x 1.35 x 0.819 mm
