twilkers1976/Omnisensor-dsp-board/3d/SOT-223_3P7X6P7_ONS.step

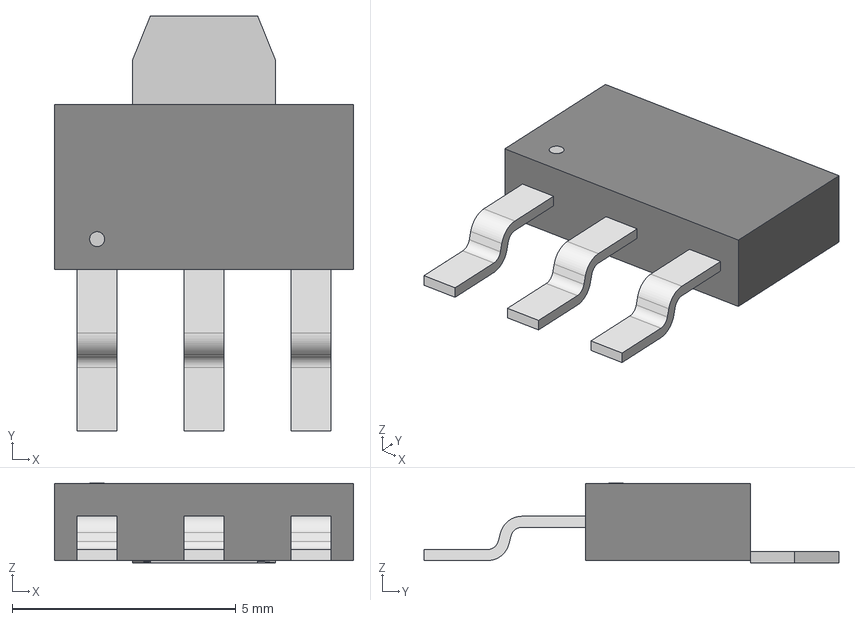
[picture p13: CAD file, 2026-10-08]
3d/SOT-223_3P7X6P7_ONS.step
6.68 x 9.27 x 1.78 mm
