twilkers1976/Omnisensor-dsp-board/3d/PE-68386NL.step

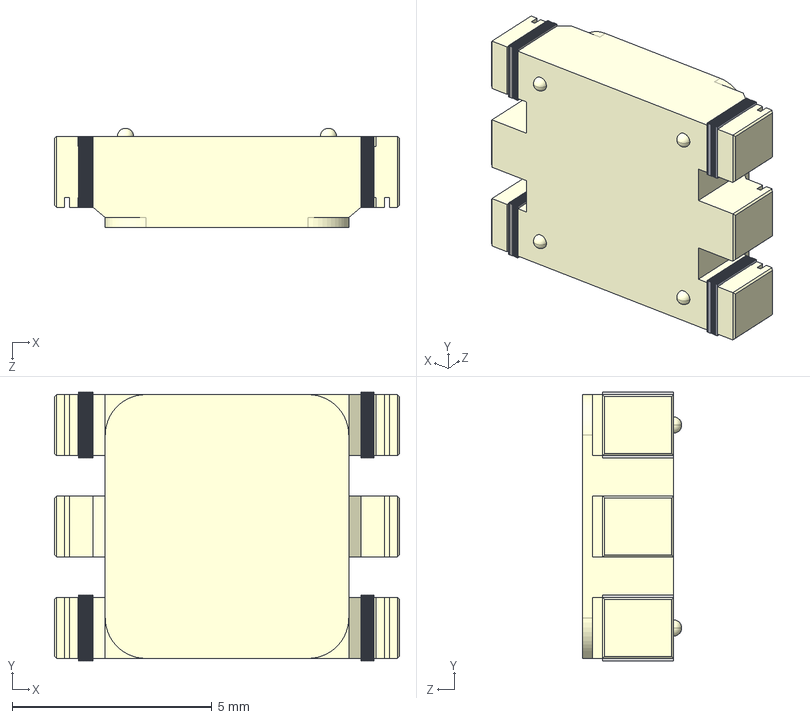
[picture p14: CAD file, 2026-10-08]
3d/PE-68386NL.step
8.64 x 6.73 x 2.49 mm
