twilkers1976/Omnisensor-dsp-board/3d/UJ-5_ADI.step

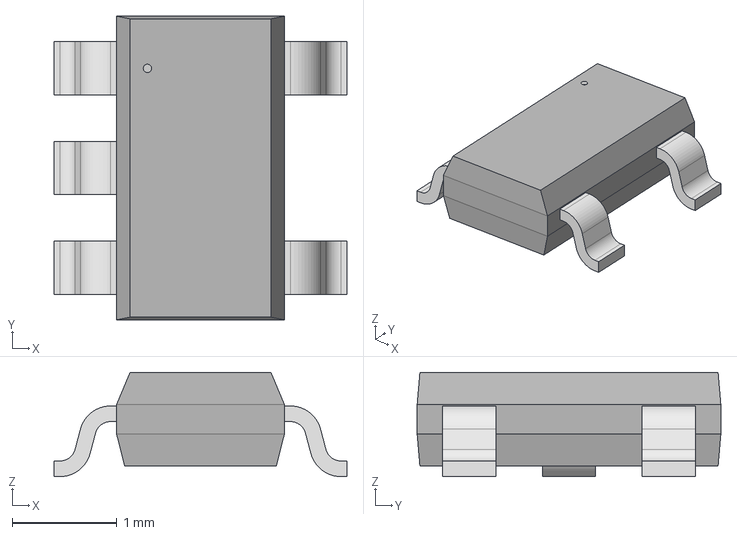
[picture p15: CAD file, 2026-10-08]
3d/UJ-5_ADI.step
2.79 x 2.90 x 0.993 mm
