twilkers1976/Omnisensor-dsp-board/3d/PE-68386NL_PUL.step

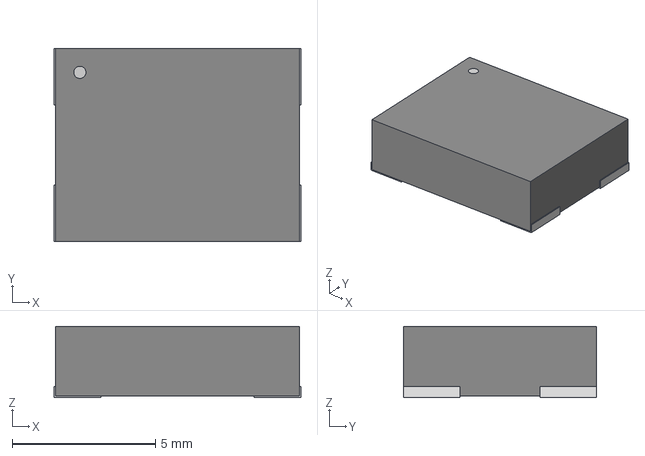
[picture p16: CAD file, 2026-10-08]
3d/PE-68386NL_PUL.step
8.64 x 6.73 x 2.49 mm
