twilkers1976/Omnisensor-dsp-board/3d/SP3003-02JTG.step

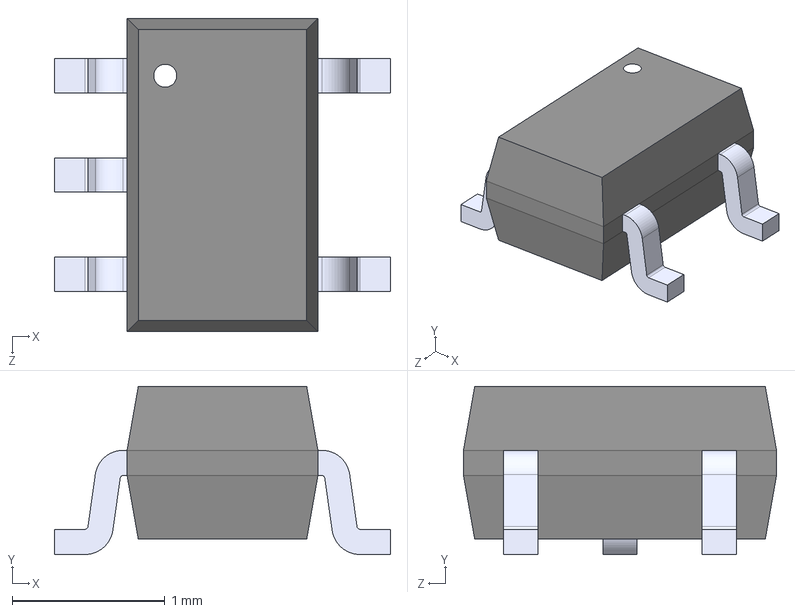
[picture p17: CAD file, 2026-10-08]
3d/SP3003-02JTG.step
2.20 x 1.10 x 2.05 mm
