twilkers1976/Omnisensor-dsp-board/3d/SOIC8_751DZ_ONS_OSI.step

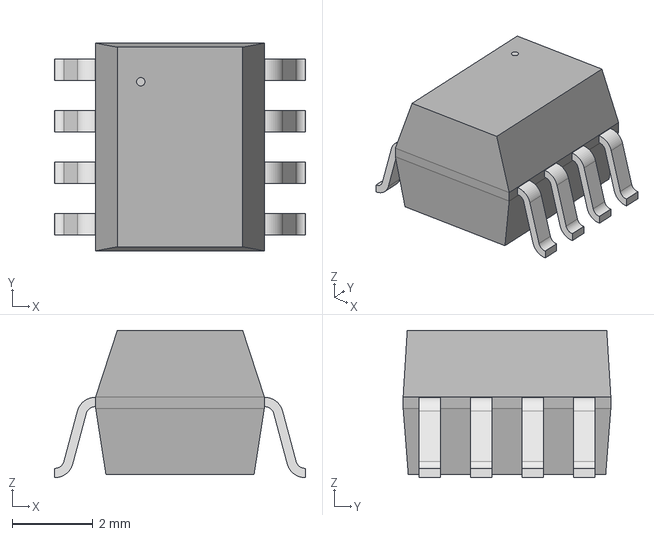
[picture p18: CAD file, 2026-10-08]
3d/SOIC8_751DZ_ONS_OSI.step
6.20 x 5.13 x 3.63 mm
