twilkers1976/Omnisensor-dsp-board/3d/TAJB_AVX.step

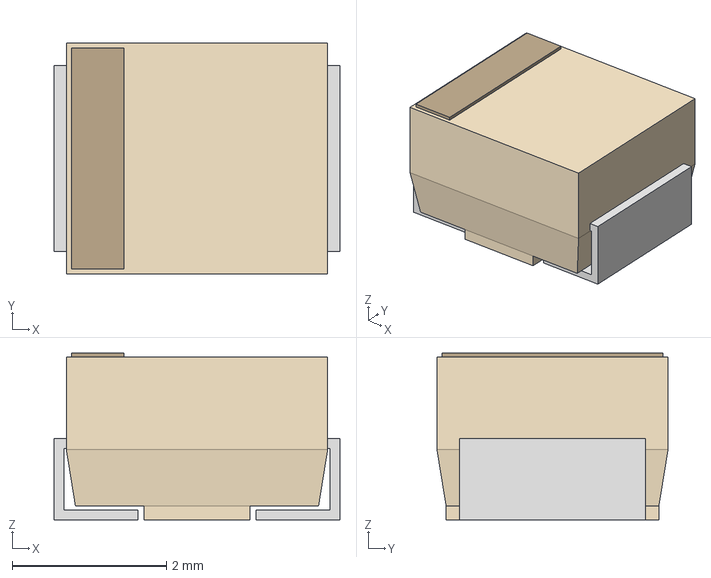
[picture p19: CAD file, 2026-10-08]
3d/TAJB_AVX.step
3.71 x 3.00 x 2.16 mm
