twilkers1976/Omnisensor-dsp-board/3d/LED_B1931NG_HVK.step

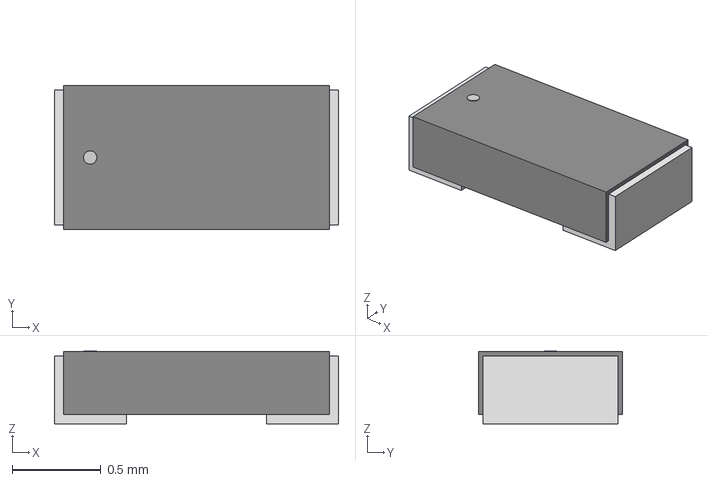
[picture p20: CAD file, 2026-10-08]
3d/LED_B1931NG_HVK.step
1.60 x 0.812 x 0.409 mm
