twilkers1976/Omnisensor-dsp-board/3d/FDMC86102.step

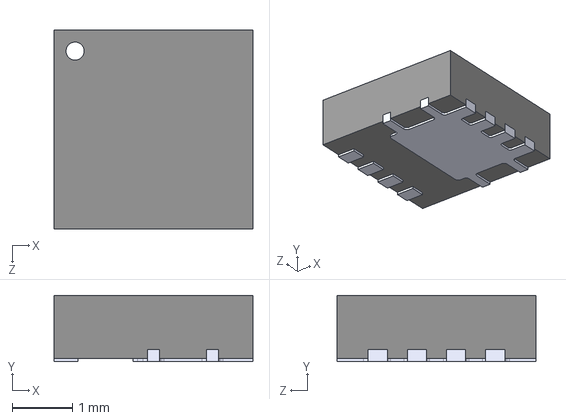
[picture p21: CAD file, 2026-10-08]
3d/FDMC86102.step
3.30 x 1.10 x 3.30 mm
