twilkers1976/Omnisensor-dsp-board/3d/SOT-23-3_1P4X3P040_ONS.step

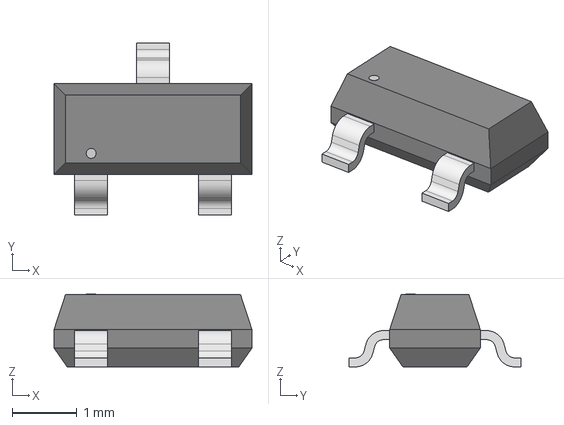
[picture p22: CAD file, 2026-10-08]
3d/SOT-23-3_1P4X3P040_ONS.step
3.05 x 2.64 x 1.12 mm
