twilkers1976/Omnisensor-dsp-board/3d/CAP_PC_8X12_NCH.step

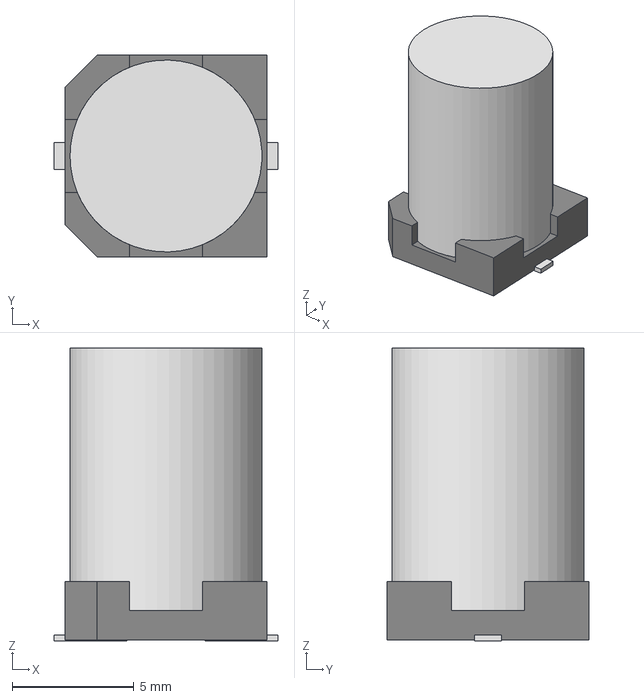
[picture p23: CAD file, 2026-10-08]
3d/CAP_PC_8X12_NCH.step
9.19 x 8.31 x 12.0 mm
