twilkers1976/Omnisensor-dsp-board/3d/DO1608C.STEP

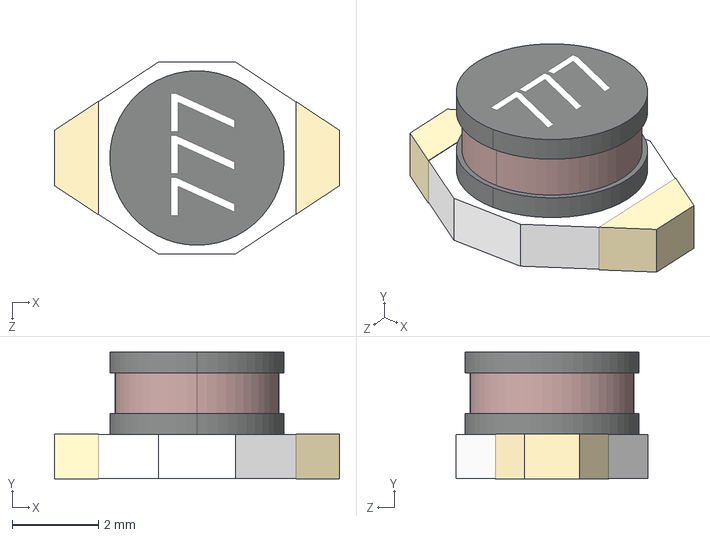
[picture p24: CAD file, 2026-10-08]
3d/DO1608C.STEP
6.60 x 2.93 x 4.45 mm
