twilkers1976/Omnisensor-dsp-board/3d/CDBA-G.step

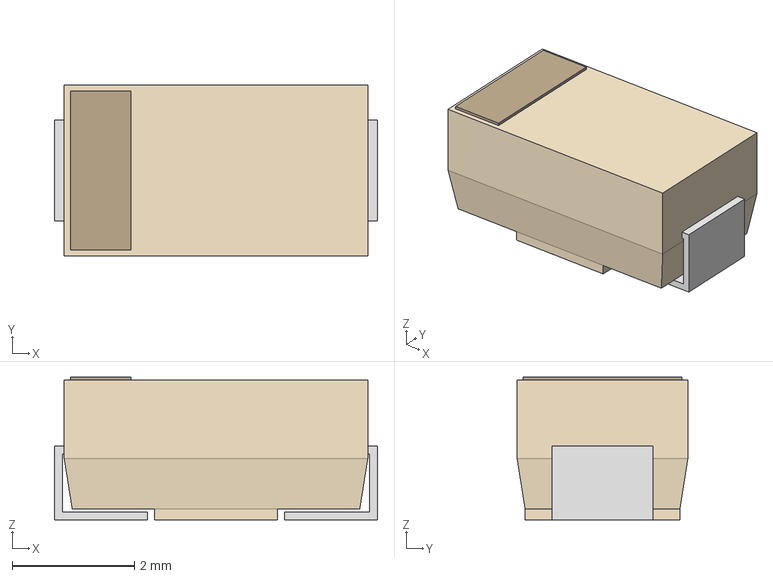
[picture p25: CAD file, 2026-10-08]
3d/CDBA-G.step
5.28 x 2.79 x 2.34 mm
