twilkers1976/Omnisensor-dsp-board/3d/SMD4_UHD111A-FKA_CRW.step

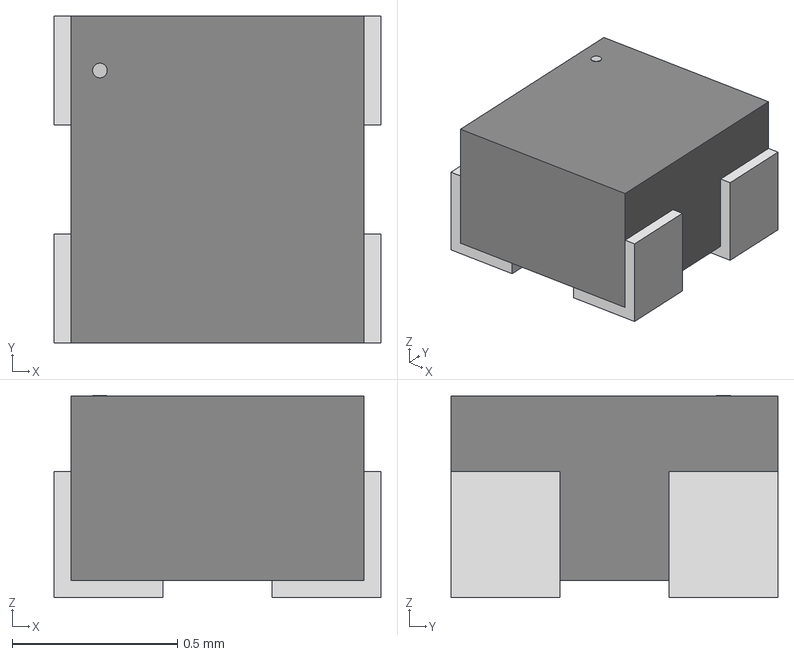
[picture p26: CAD file, 2026-10-08]
3d/SMD4_UHD111A-FKA_CRW.step
0.99 x 0.99 x 0.612 mm
