twilkers1976/Omnisensor-dsp-board/3d/PSMN075-100MSE.step

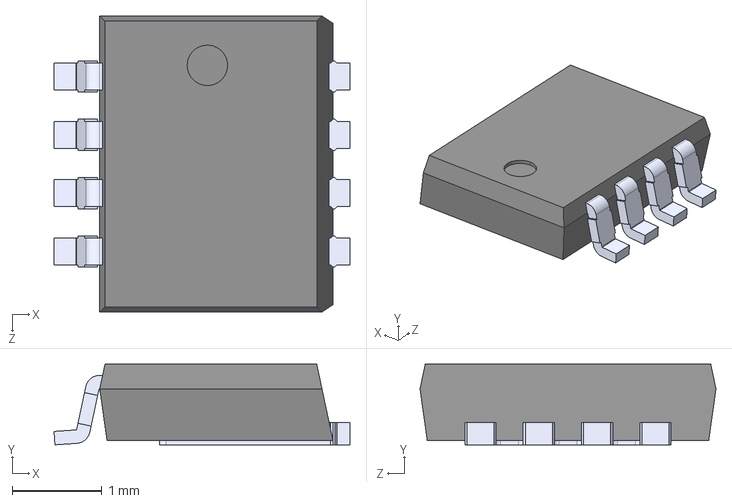
[picture p27: CAD file, 2026-10-08]
3d/PSMN075-100MSE.step
3.30 x 0.9 x 3.30 mm
