twilkers1976/Omnisensor-dsp-board/3d/ECS-2520S_ECS.step

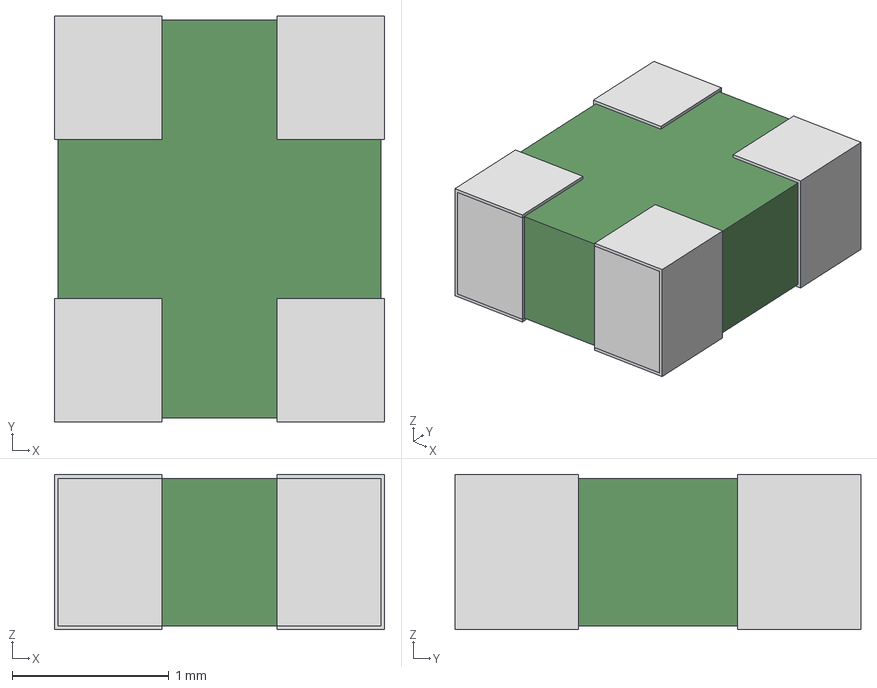
[picture p28: CAD file, 2026-10-08]
3d/ECS-2520S_ECS.step
2.11 x 2.59 x 0.991 mm
