twilkers1976/Omnisensor-dsp-board/3d/JK0-0177NL_3D.STEP

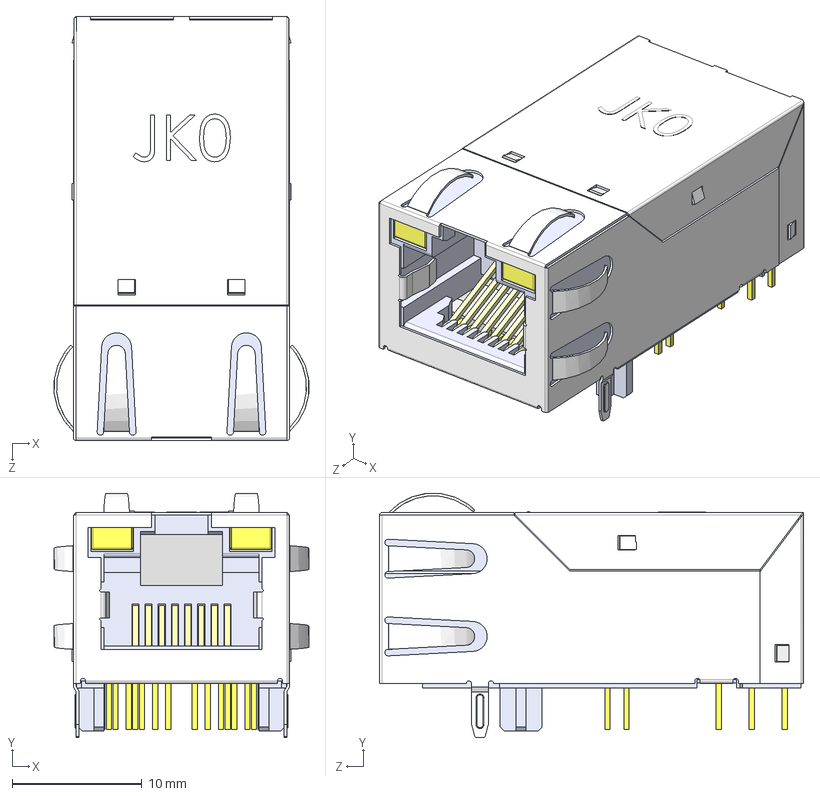
[picture p29: CAD file, 2026-10-08]
3d/JK0-0177NL_3D.STEP
19.6 x 18.8 x 32.7 mm
