twilkers1976/Omnisensor-dsp-board/3d/CAP_X-7343-43_KEM.step

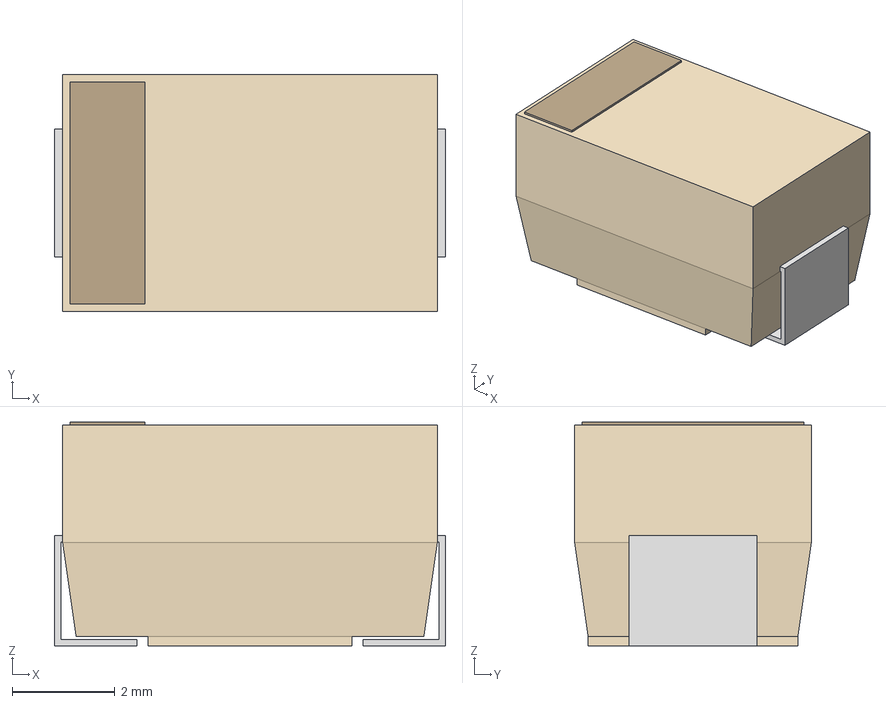
[picture p30: CAD file, 2026-10-08]
3d/CAP_X-7343-43_KEM.step
7.59 x 4.60 x 4.34 mm
