twilkers1976/Omnisensor-dsp-board/3d/VSEB0530H%203D%20Model.stp

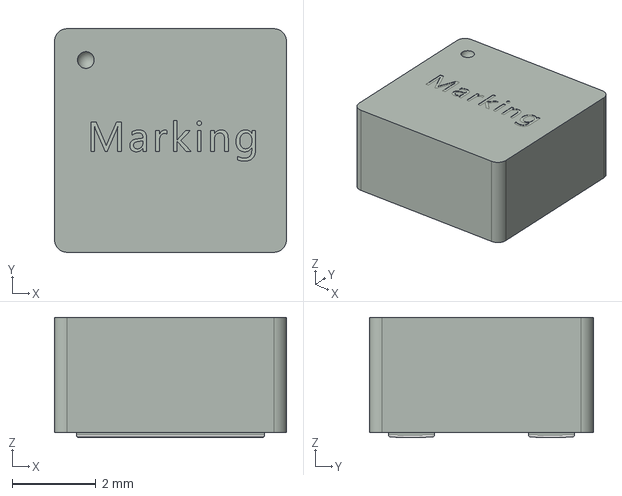
[picture p31: CAD file, 2026-10-08]
3d/VSEB0530H%203D%20Model.stp
5.55 x 5.35 x 2.88 mm
