twilkers1976/Omnisensor-dsp-board/3d/AG9912-MTB.step

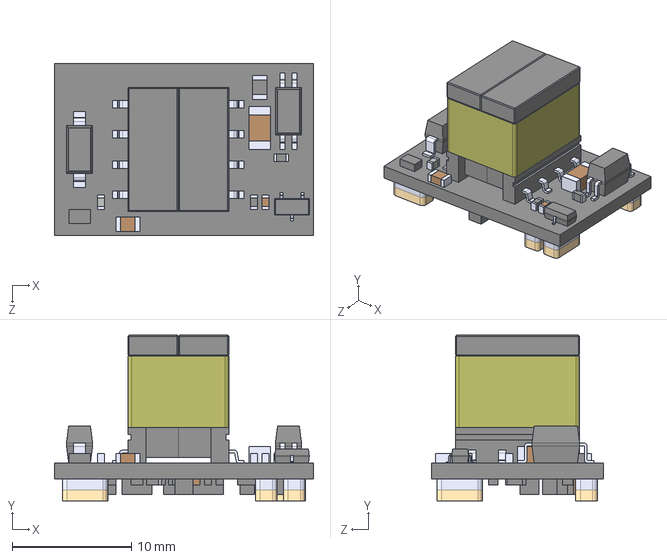
[picture p32: CAD file, 2026-10-08]
3d/AG9912-MTB.step
21.7 x 13.9 x 14.4 mm
