twilkers1976/Omnisensor-dsp-board/3d/R-667843.stp

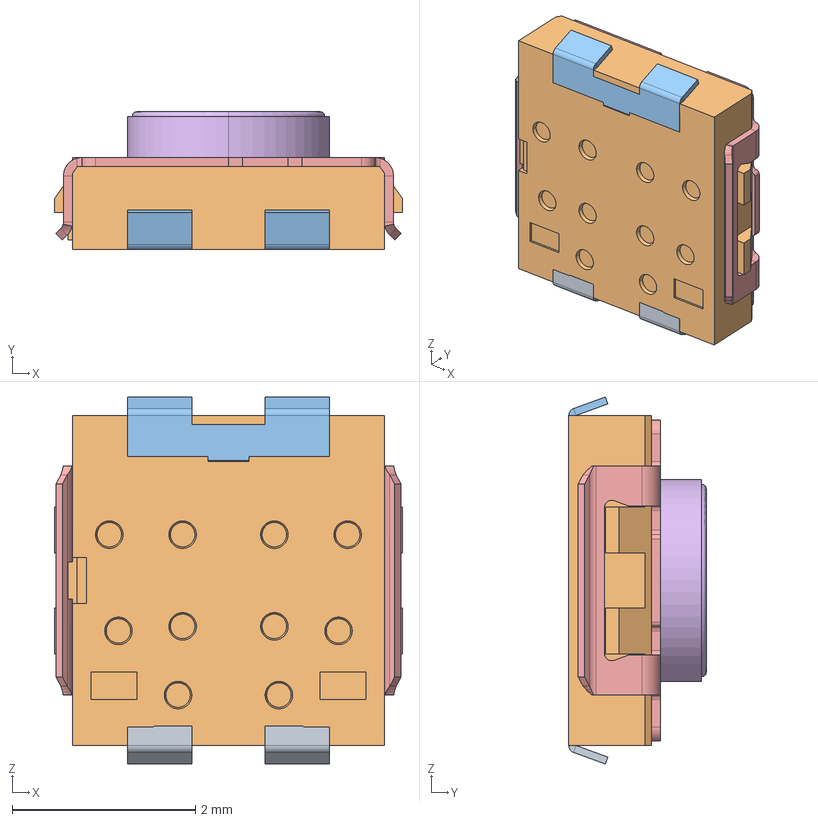
[picture p33: CAD file, 2026-10-08]
3d/R-667843.stp
3.80 x 1.50 x 4.00 mm
SOV_BASE_1_4
MANIFOLD_SOLID_BREP_9356
MANIFOLD_SOLID_BREP_9785
MANIFOLD_SOLID_BREP_10214
SOF_SPRING_1_1
SOV_COVER_1_2
BOTTOM-2_4
