twilkers1976/Omnisensor-dsp-board/3d/RA_4_ADI.step

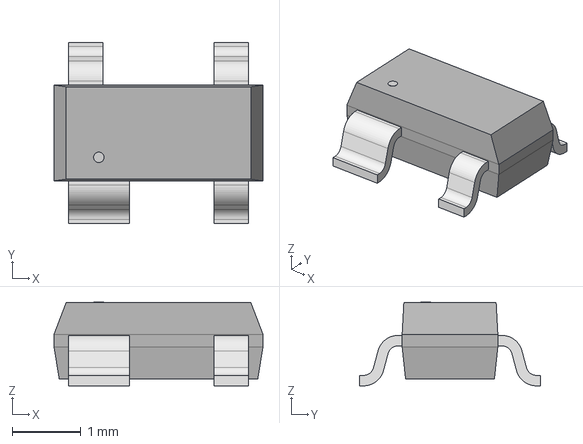
[picture p34: CAD file, 2026-10-08]
3d/RA_4_ADI.step
3.05 x 2.64 x 1.22 mm
