twilkers1976/Omnisensor-dsp-board/3d/SOIC8_MS-012_VIS.step

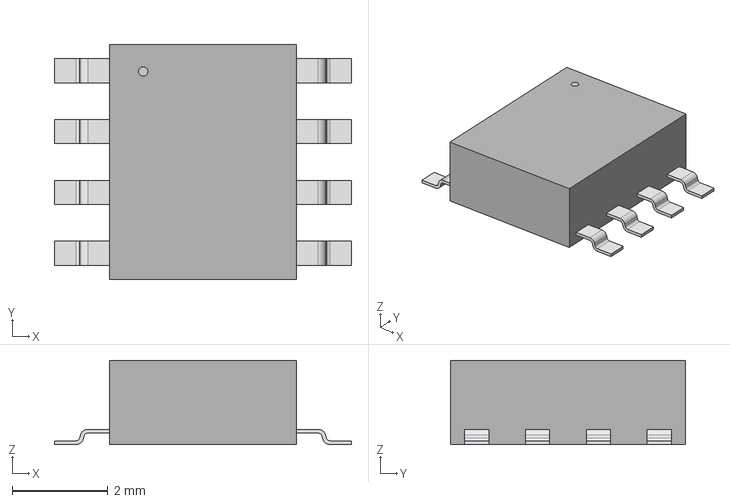
[picture p35: CAD file, 2026-10-08]
3d/SOIC8_MS-012_VIS.step
6.20 x 4.90 x 1.75 mm
