twilkers1976/Omnisensor-dsp-board/(list of files, cad)

Other CAD files:
3d/WE-LHMI_4020.step
3d/BSZ520N15NS3G.step
3d/0787883014.stp
3d/1462042-3.STEP
3d/1462042-6.step
3d/1881448.step
