twilkers1976/Omnisensor-dsp-board/cpu_board.pdf

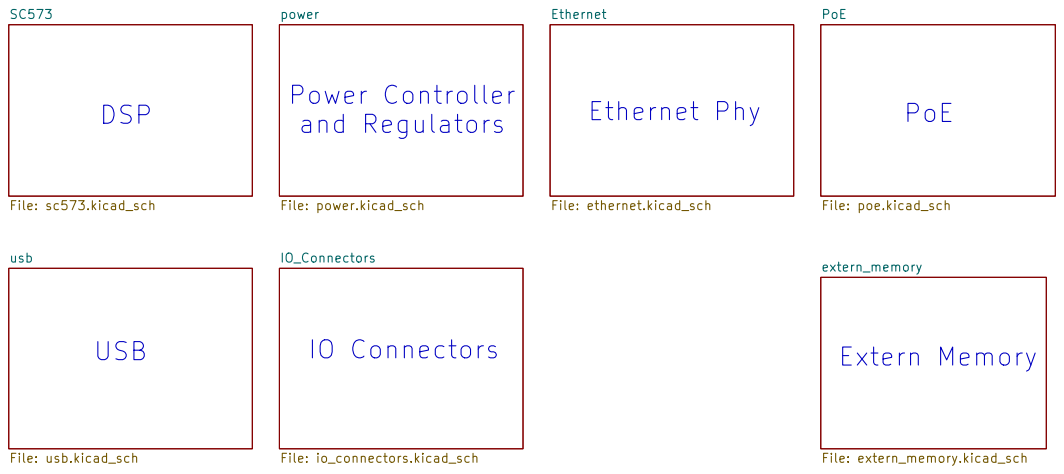
[picture p36: page 1]

Ethernet Phy Power Controller

Extern Memory IO Connectors

Size: A4 | Rev:
KiCad E.D.A. 10.0.6 | Id: 1/15

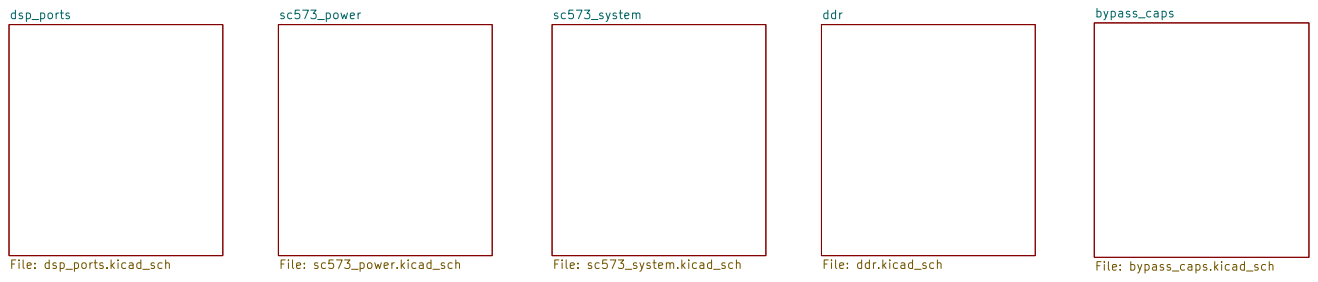
[picture p37: page 2]

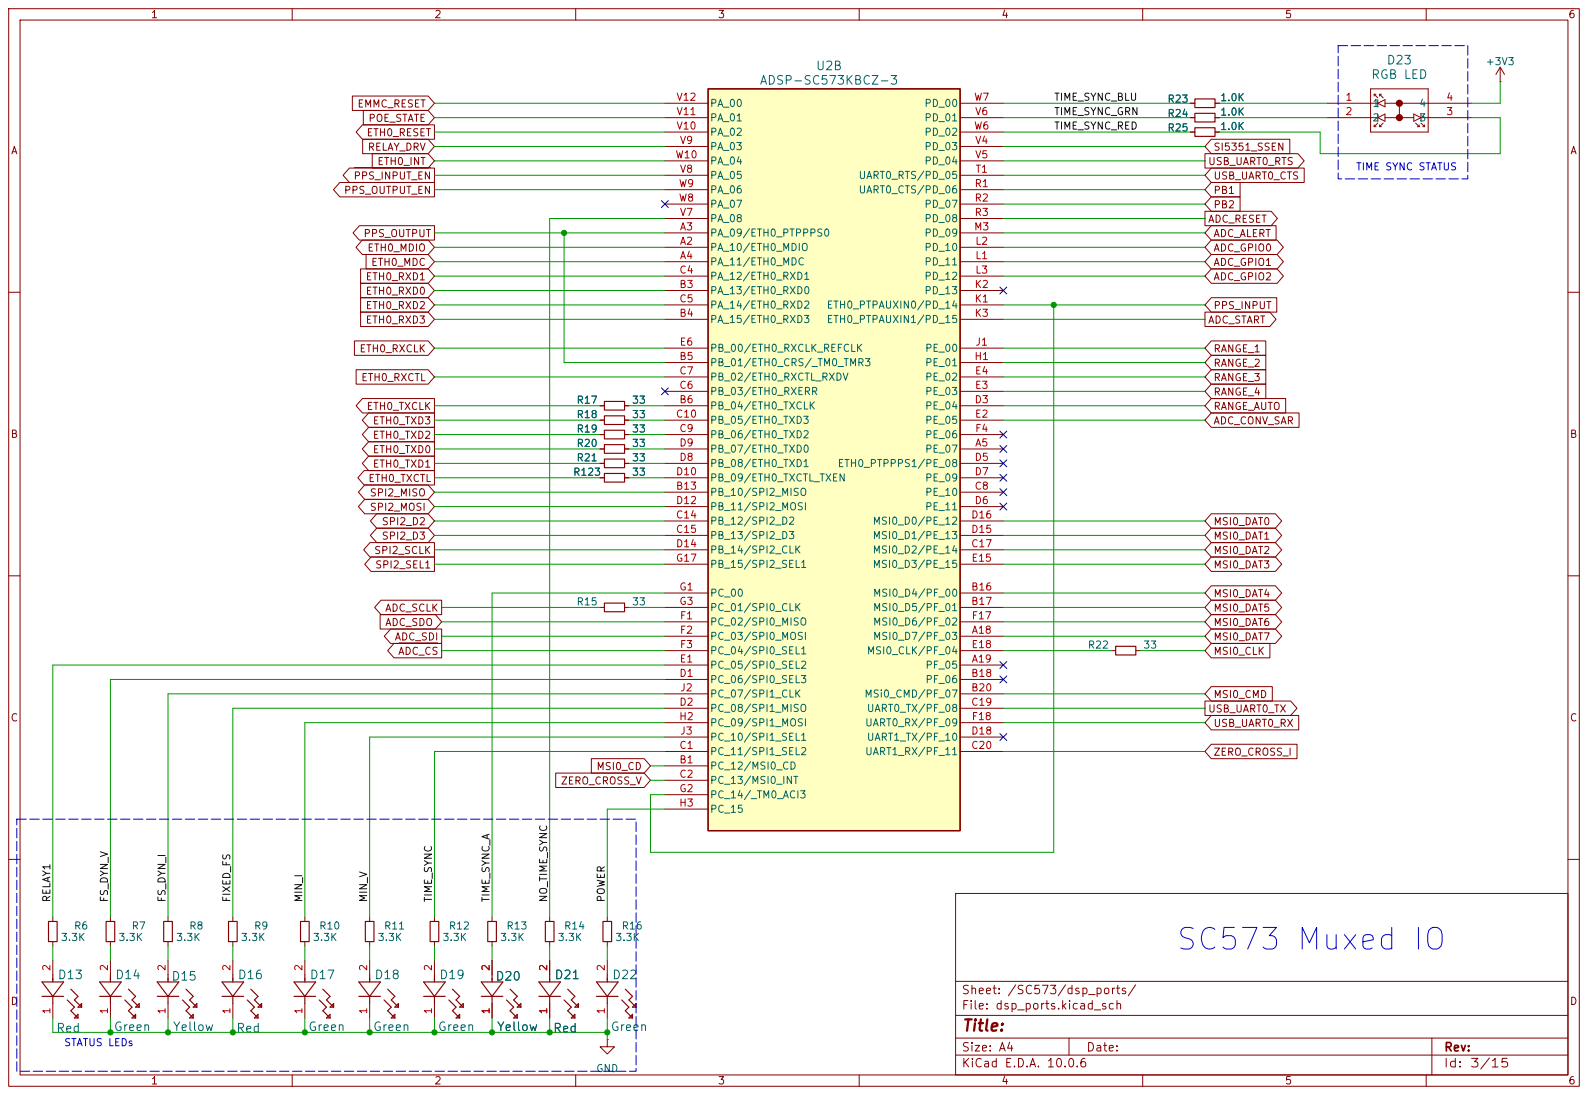
[picture p38: page 3]

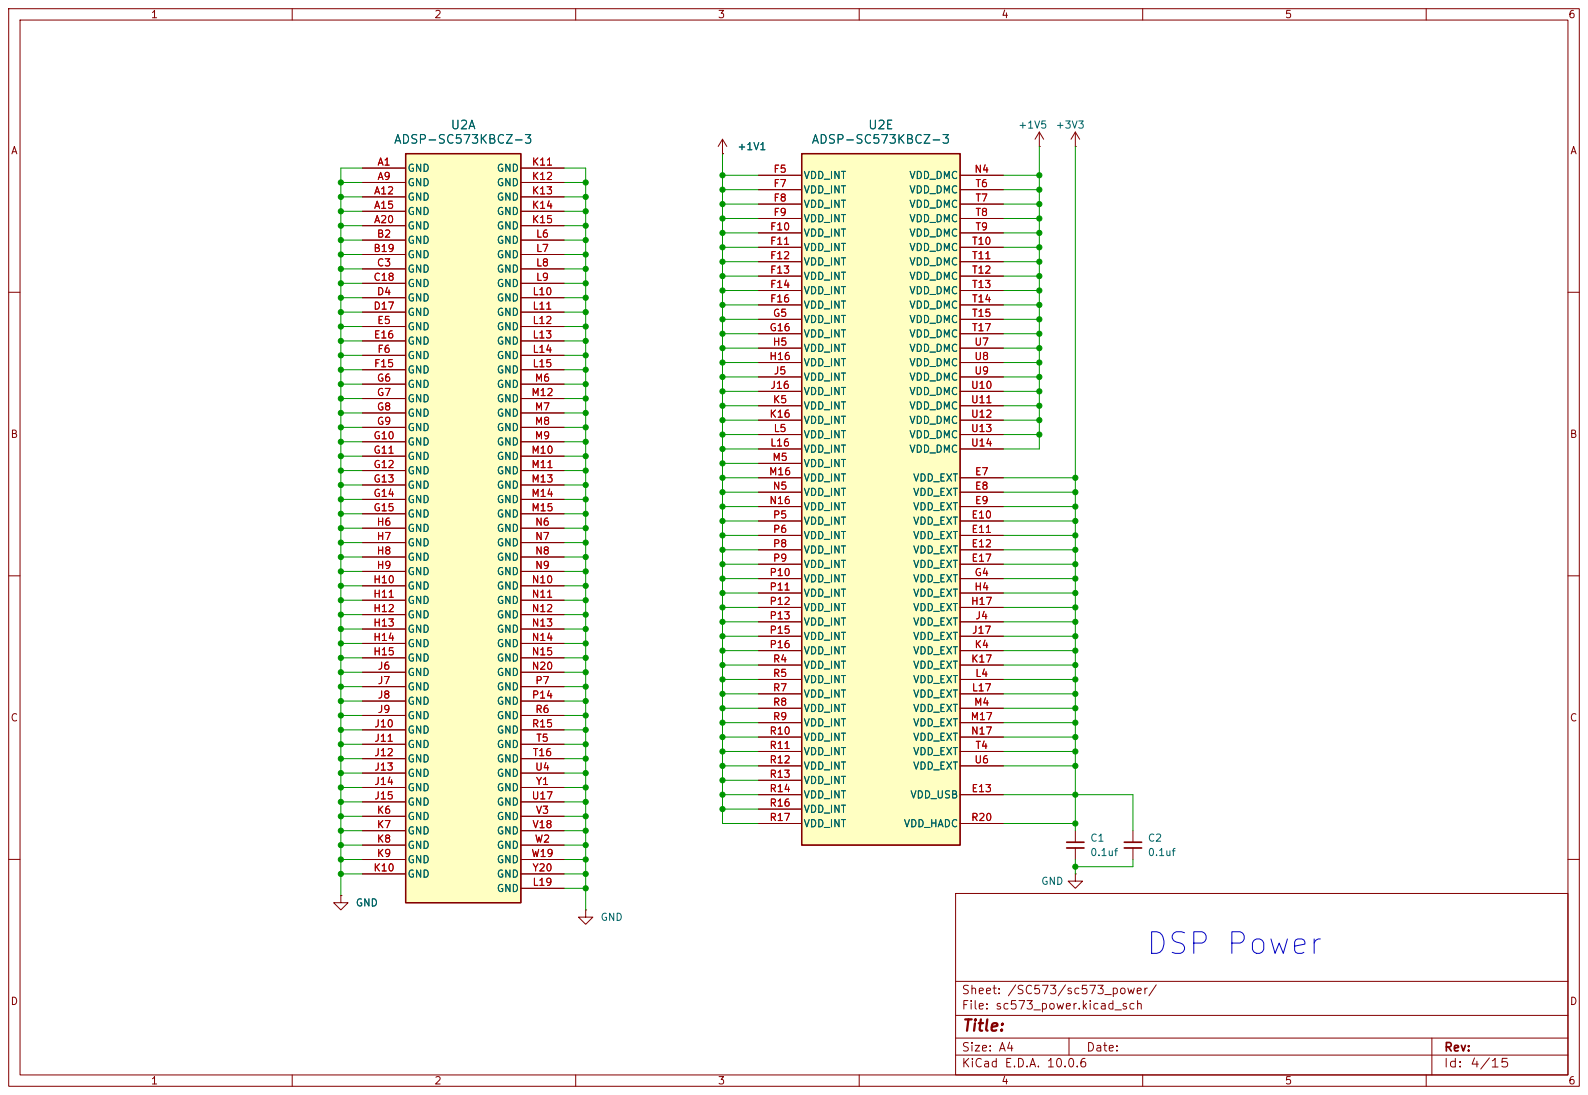
[picture p39: page 4]

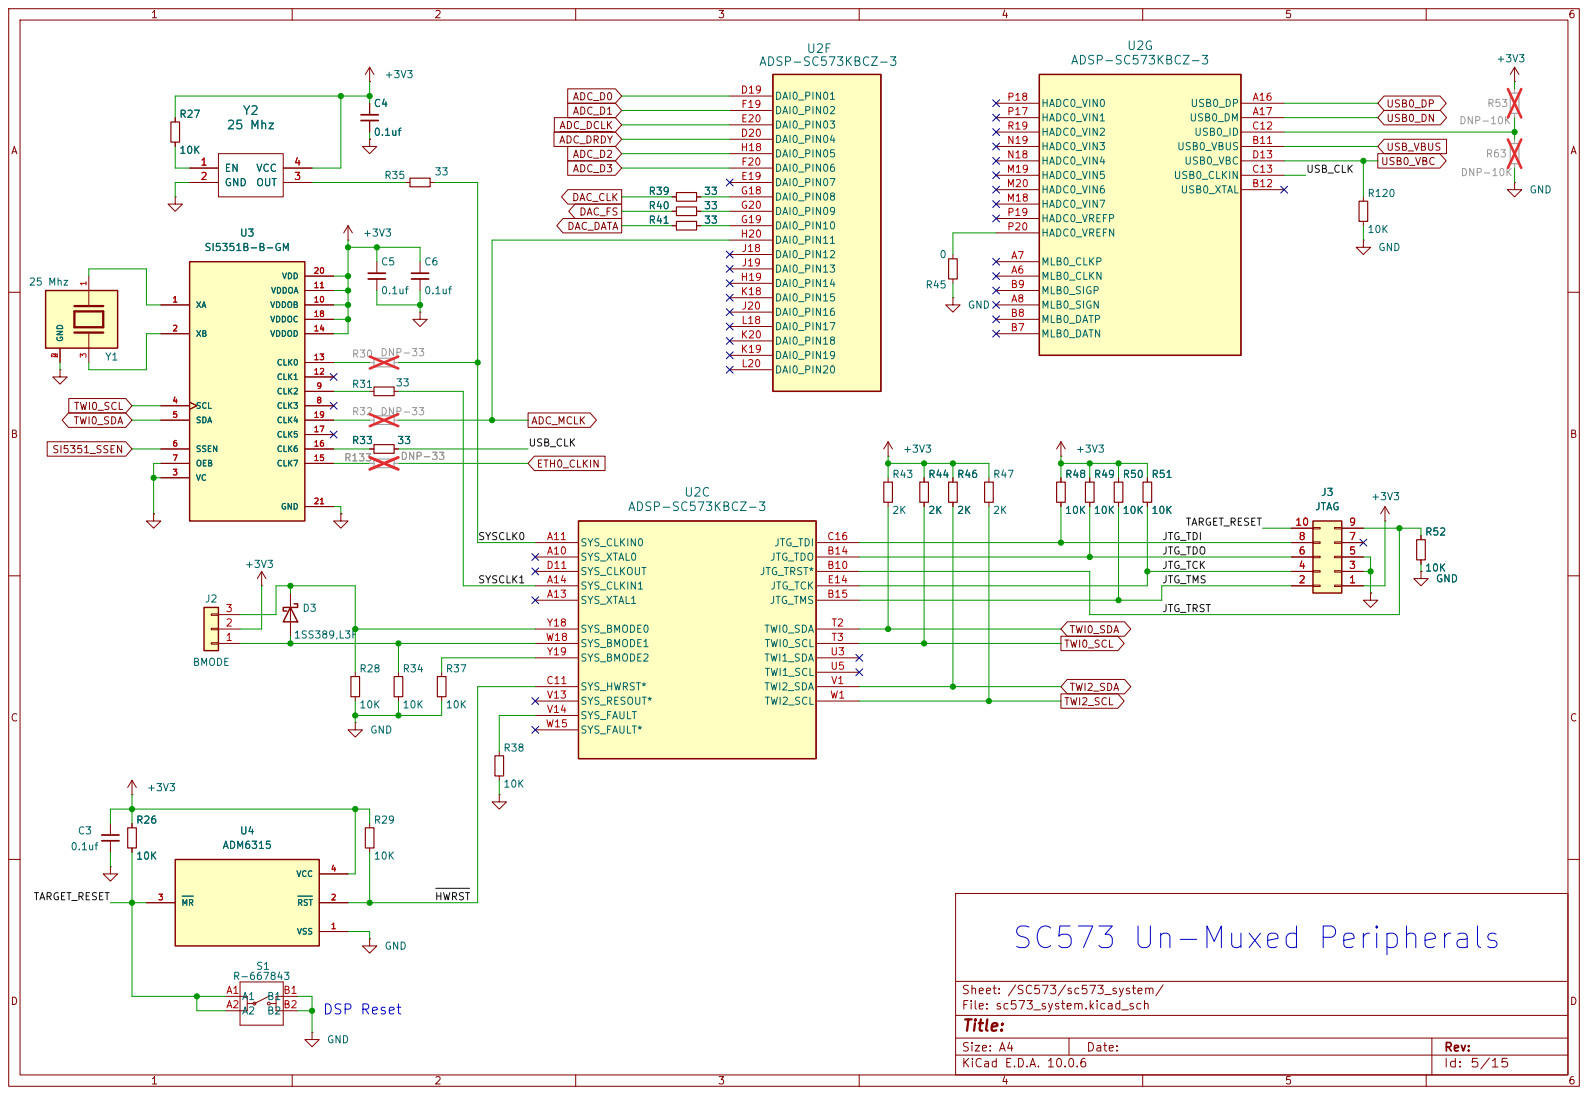
[picture p40: page 5]

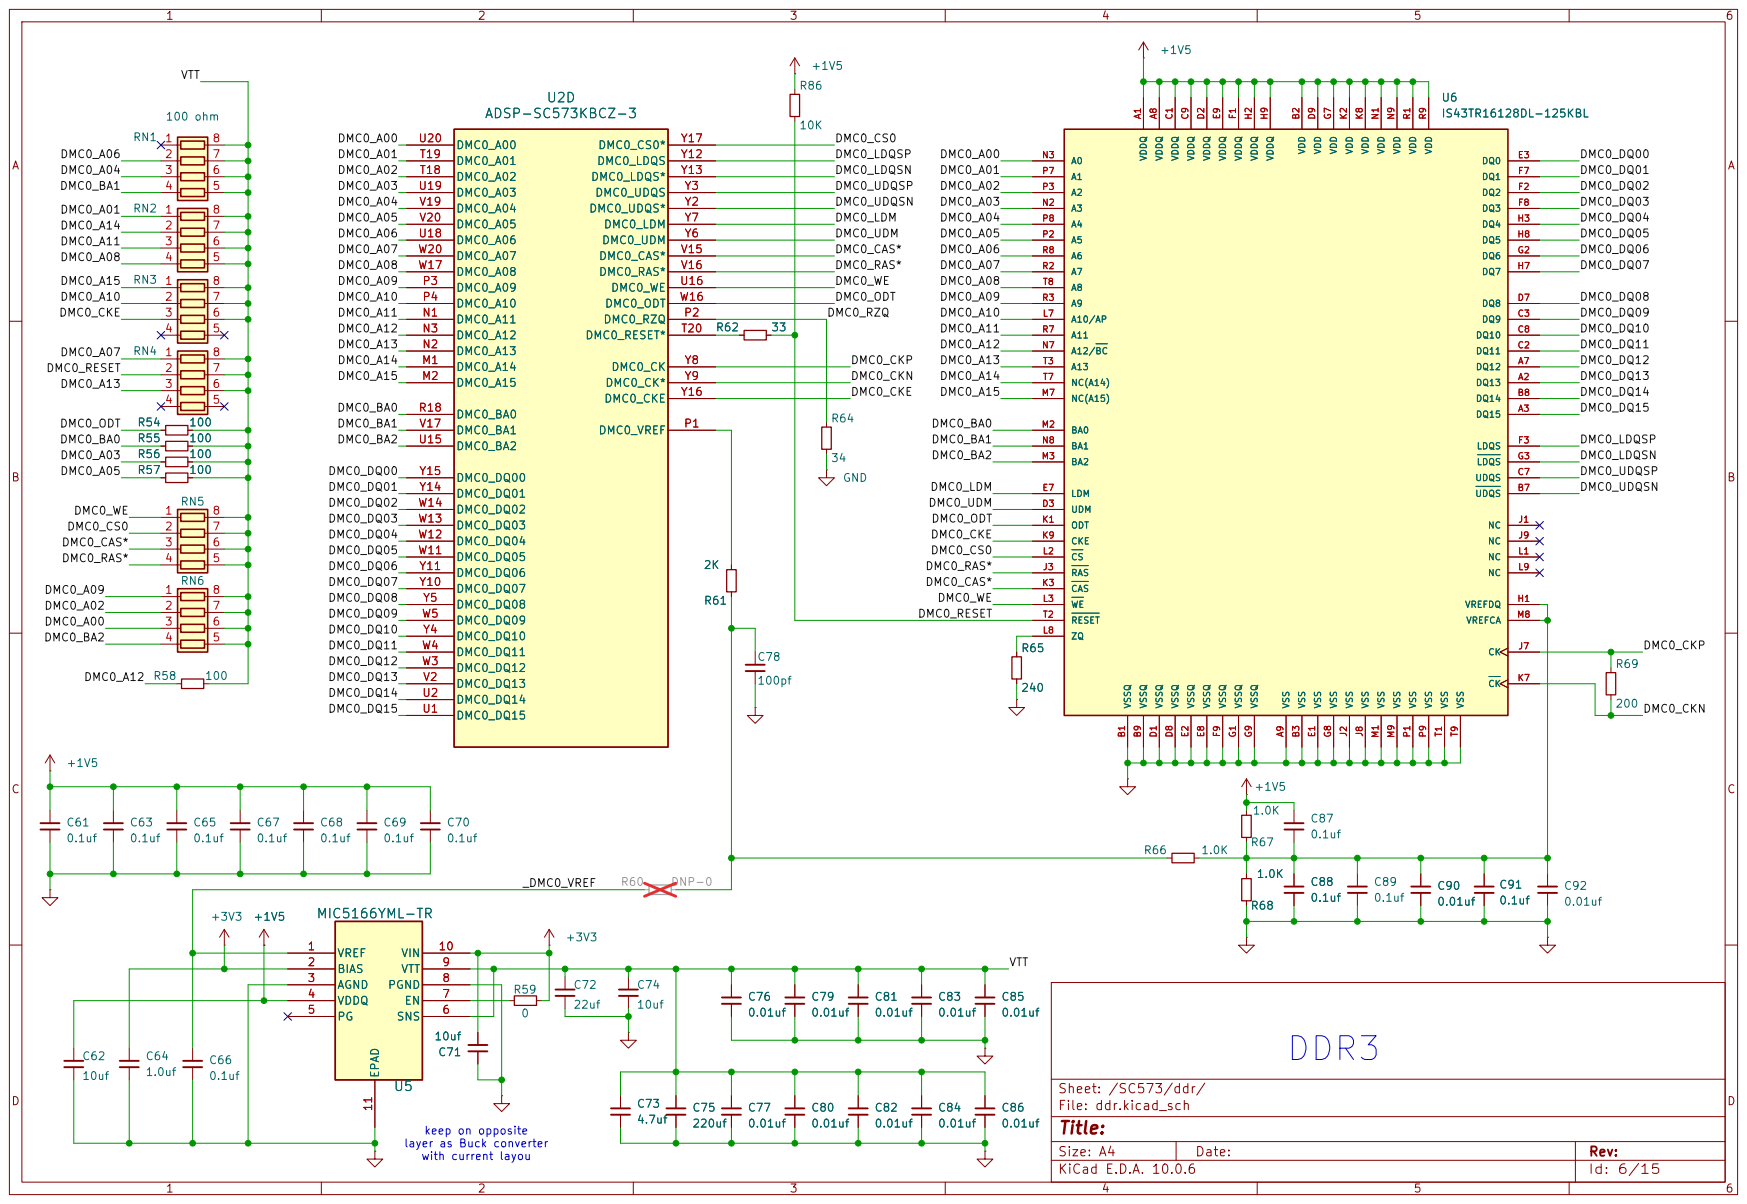
[picture p41: page 6]

keep on opposite
layer as Buck converter with current layou

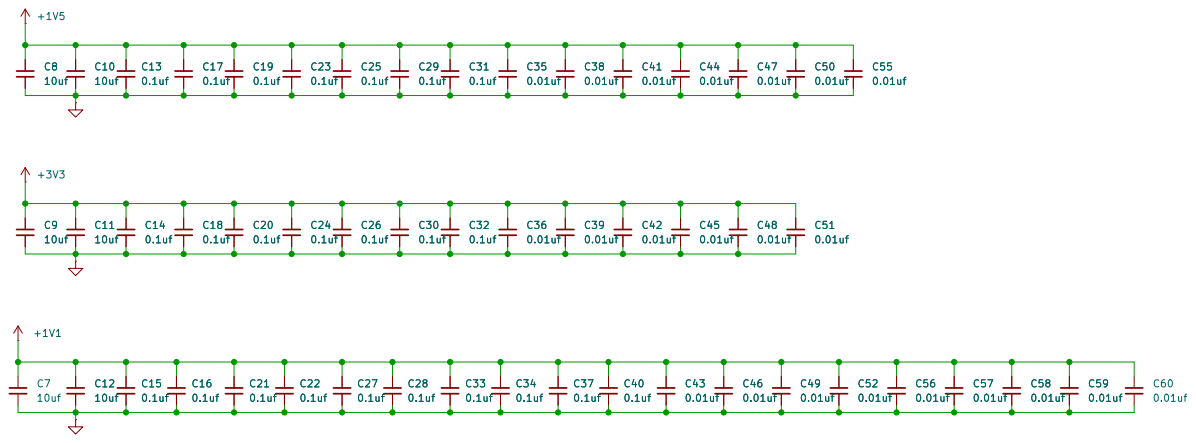
[picture p42: page 7]

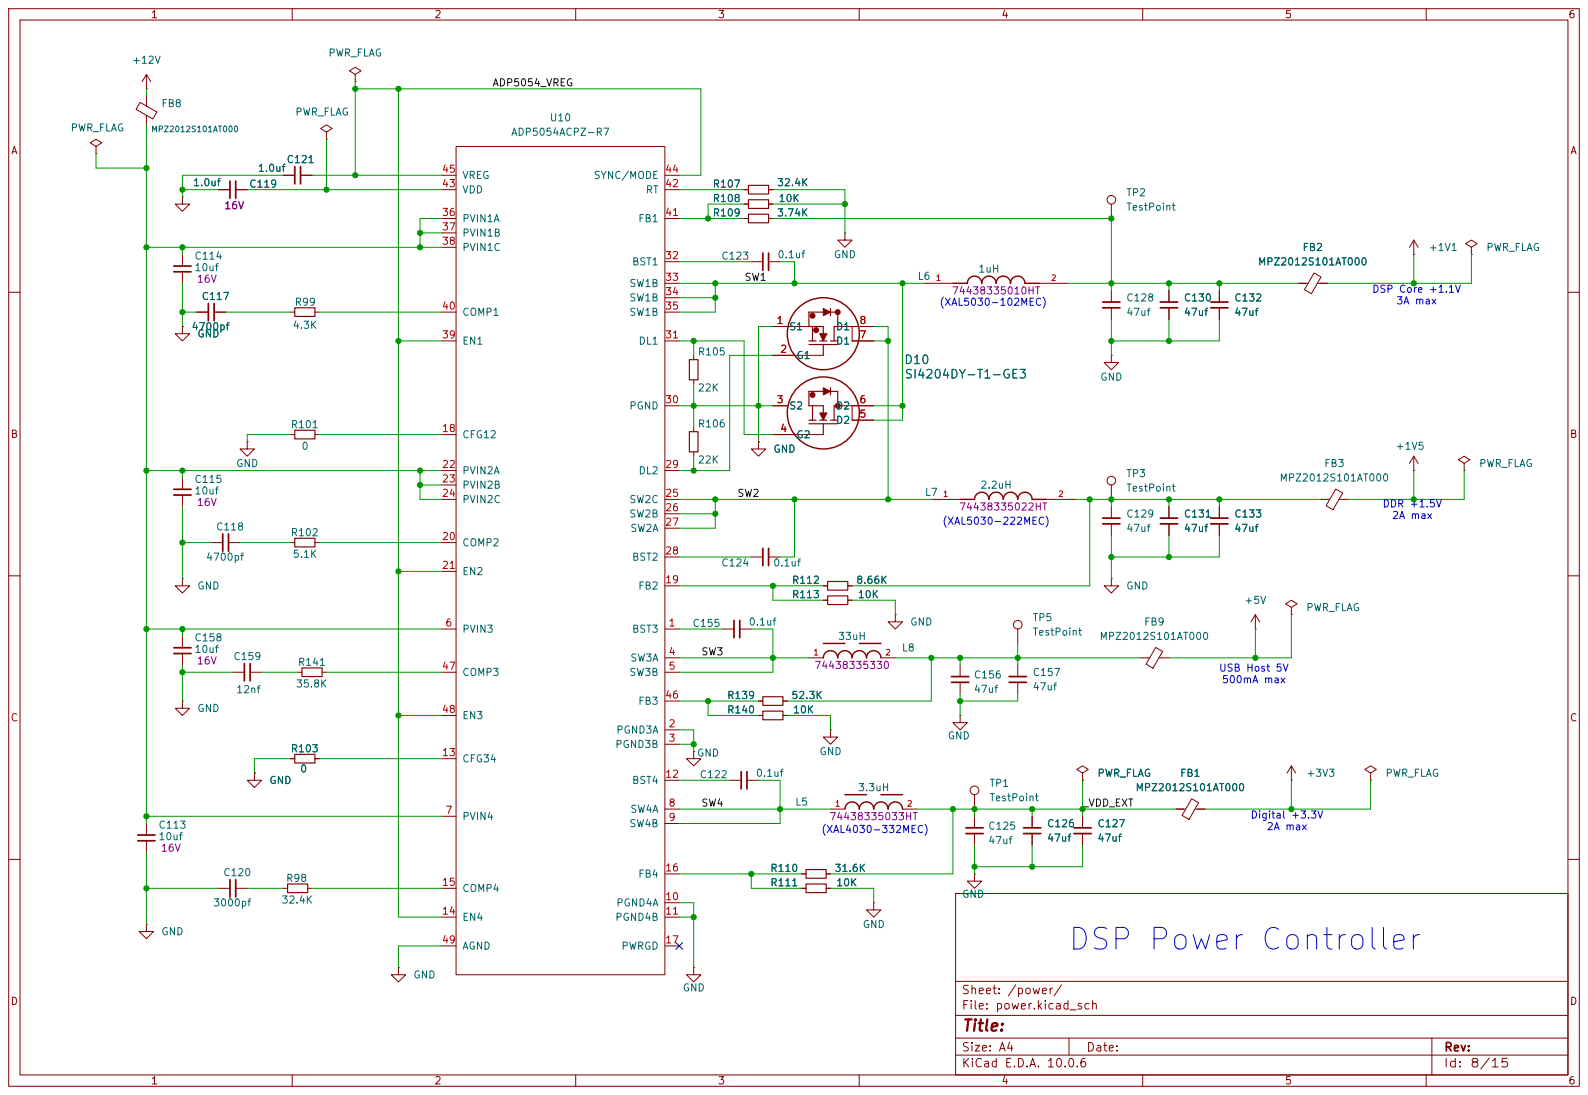
[picture p43: page 8]

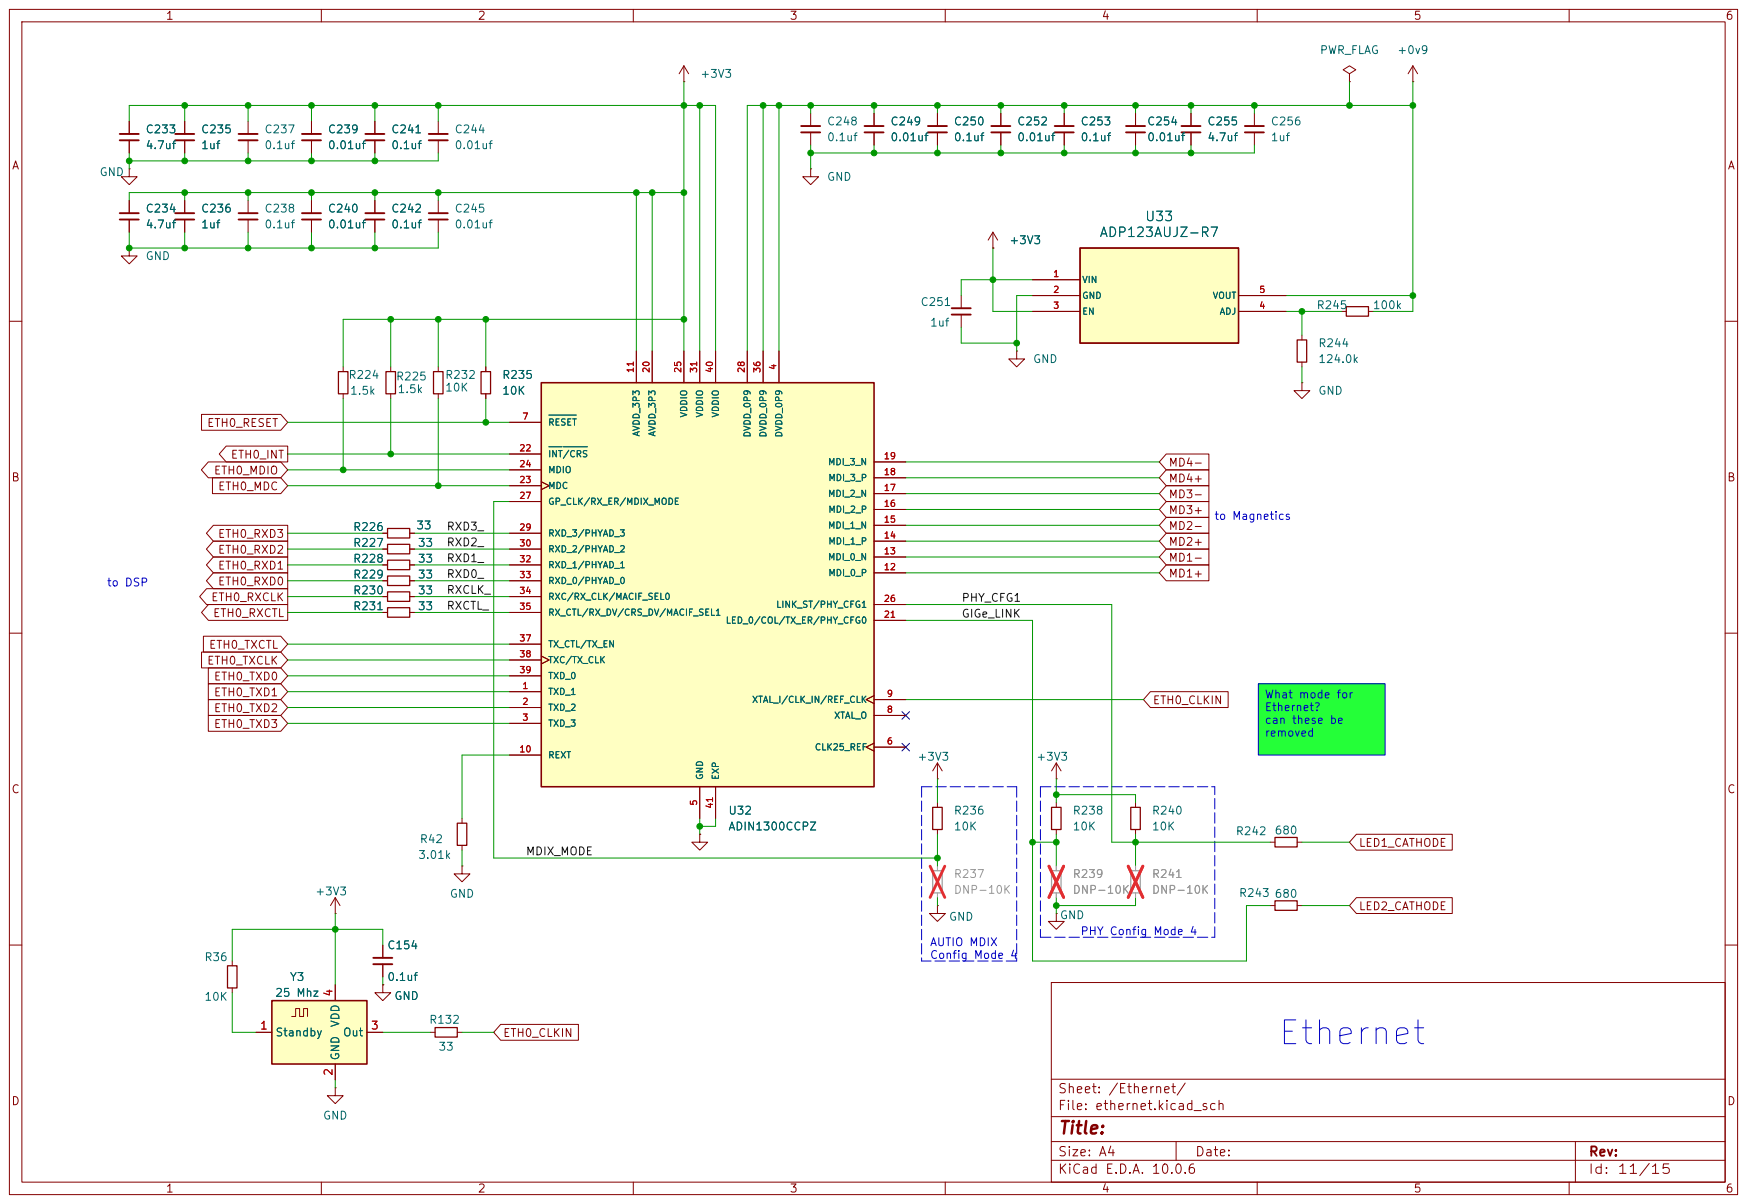
[picture p44: page 9]

ADP123AUJZ-R7
to Magnetics PHY Config Mode 4 R241 DNP-10K

AUTIO MDIX Config Mode 4

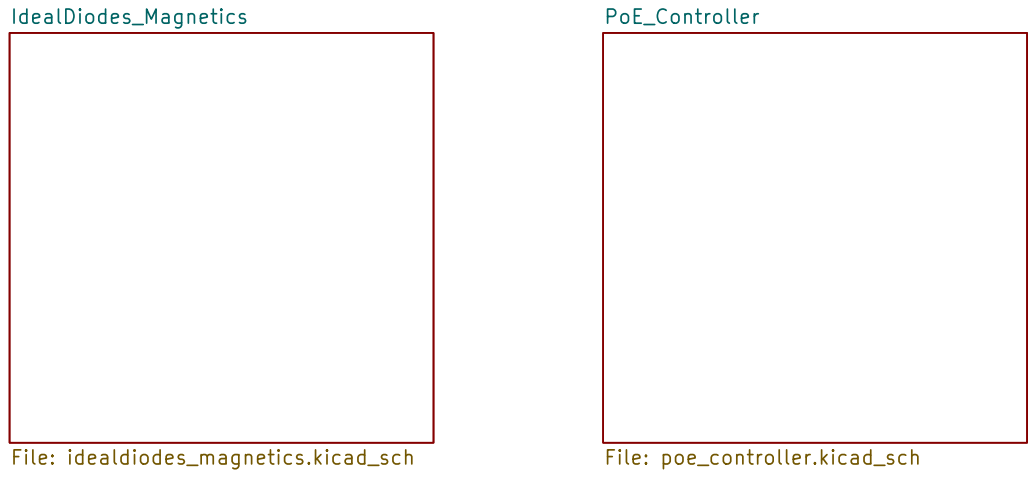
[picture p45: page 10]

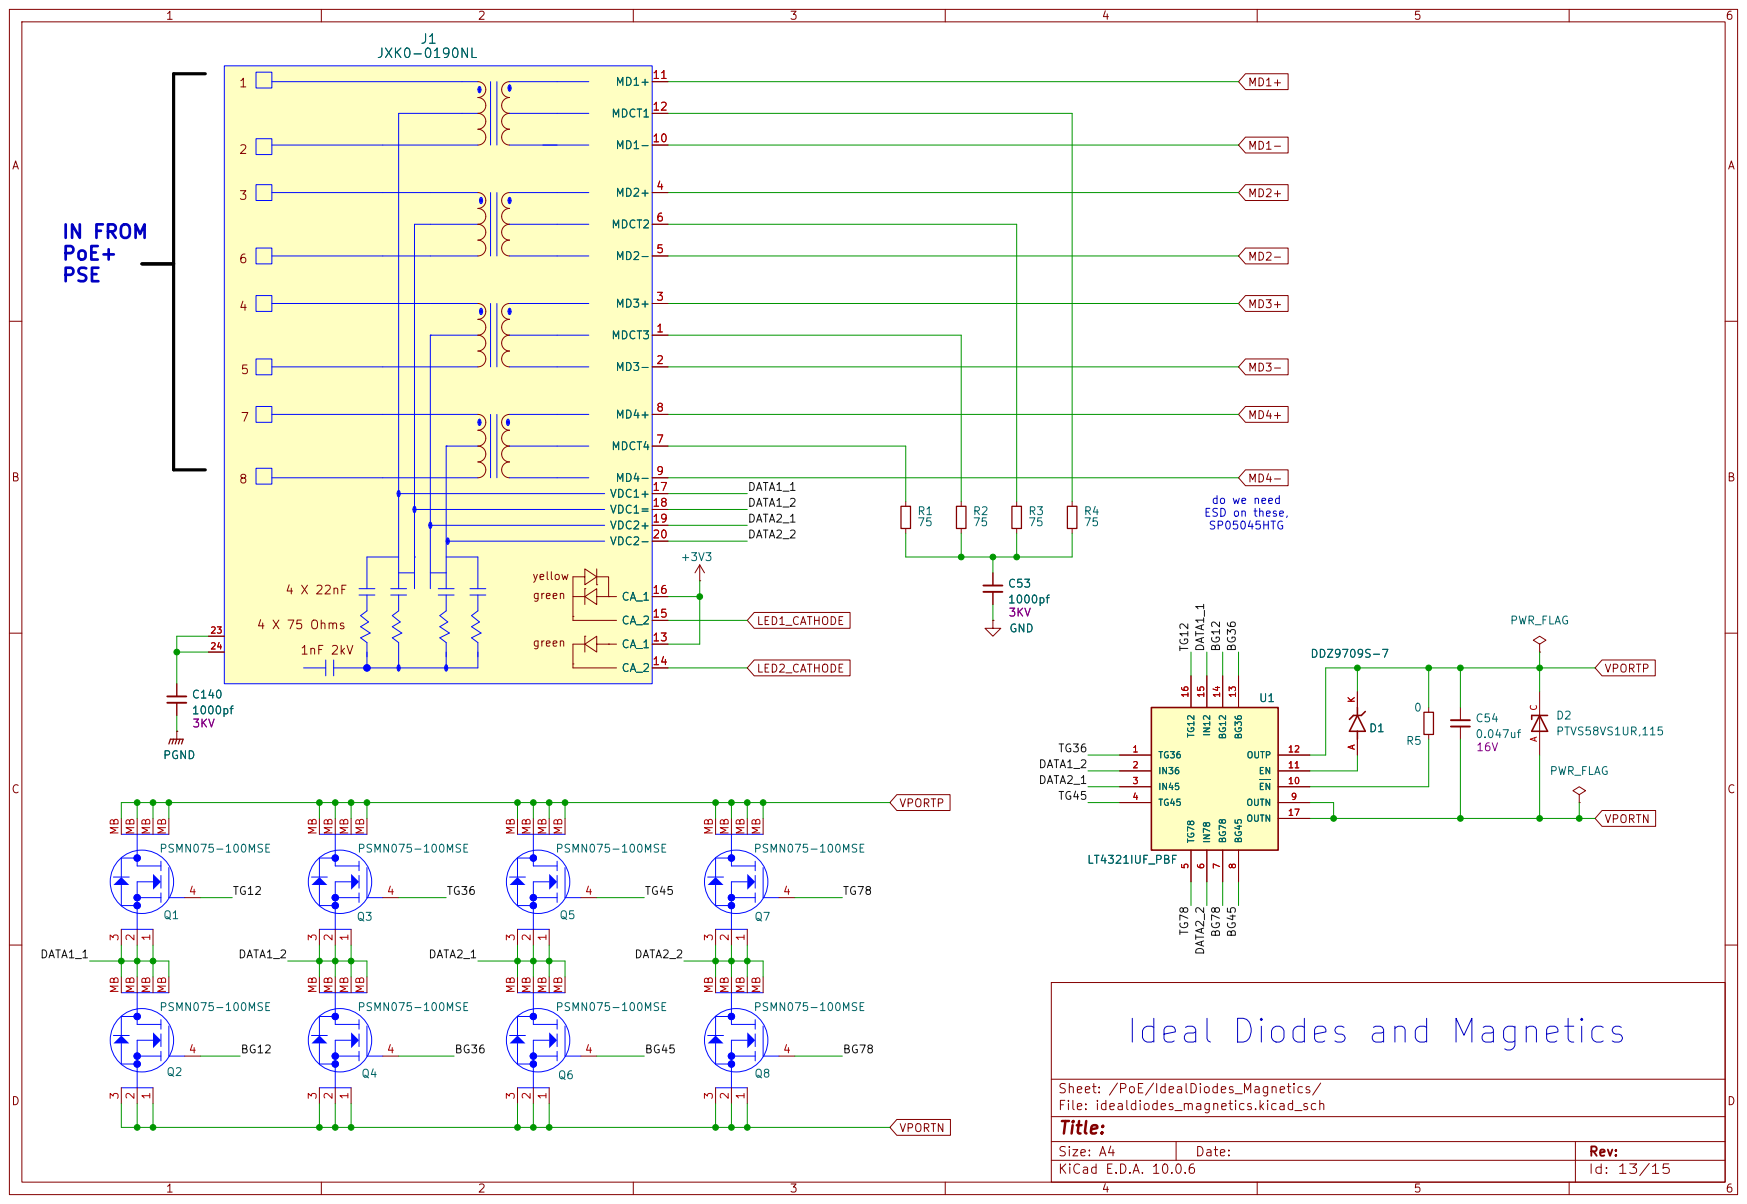
[picture p46: page 11]

Ideal Diodes and Magnetics

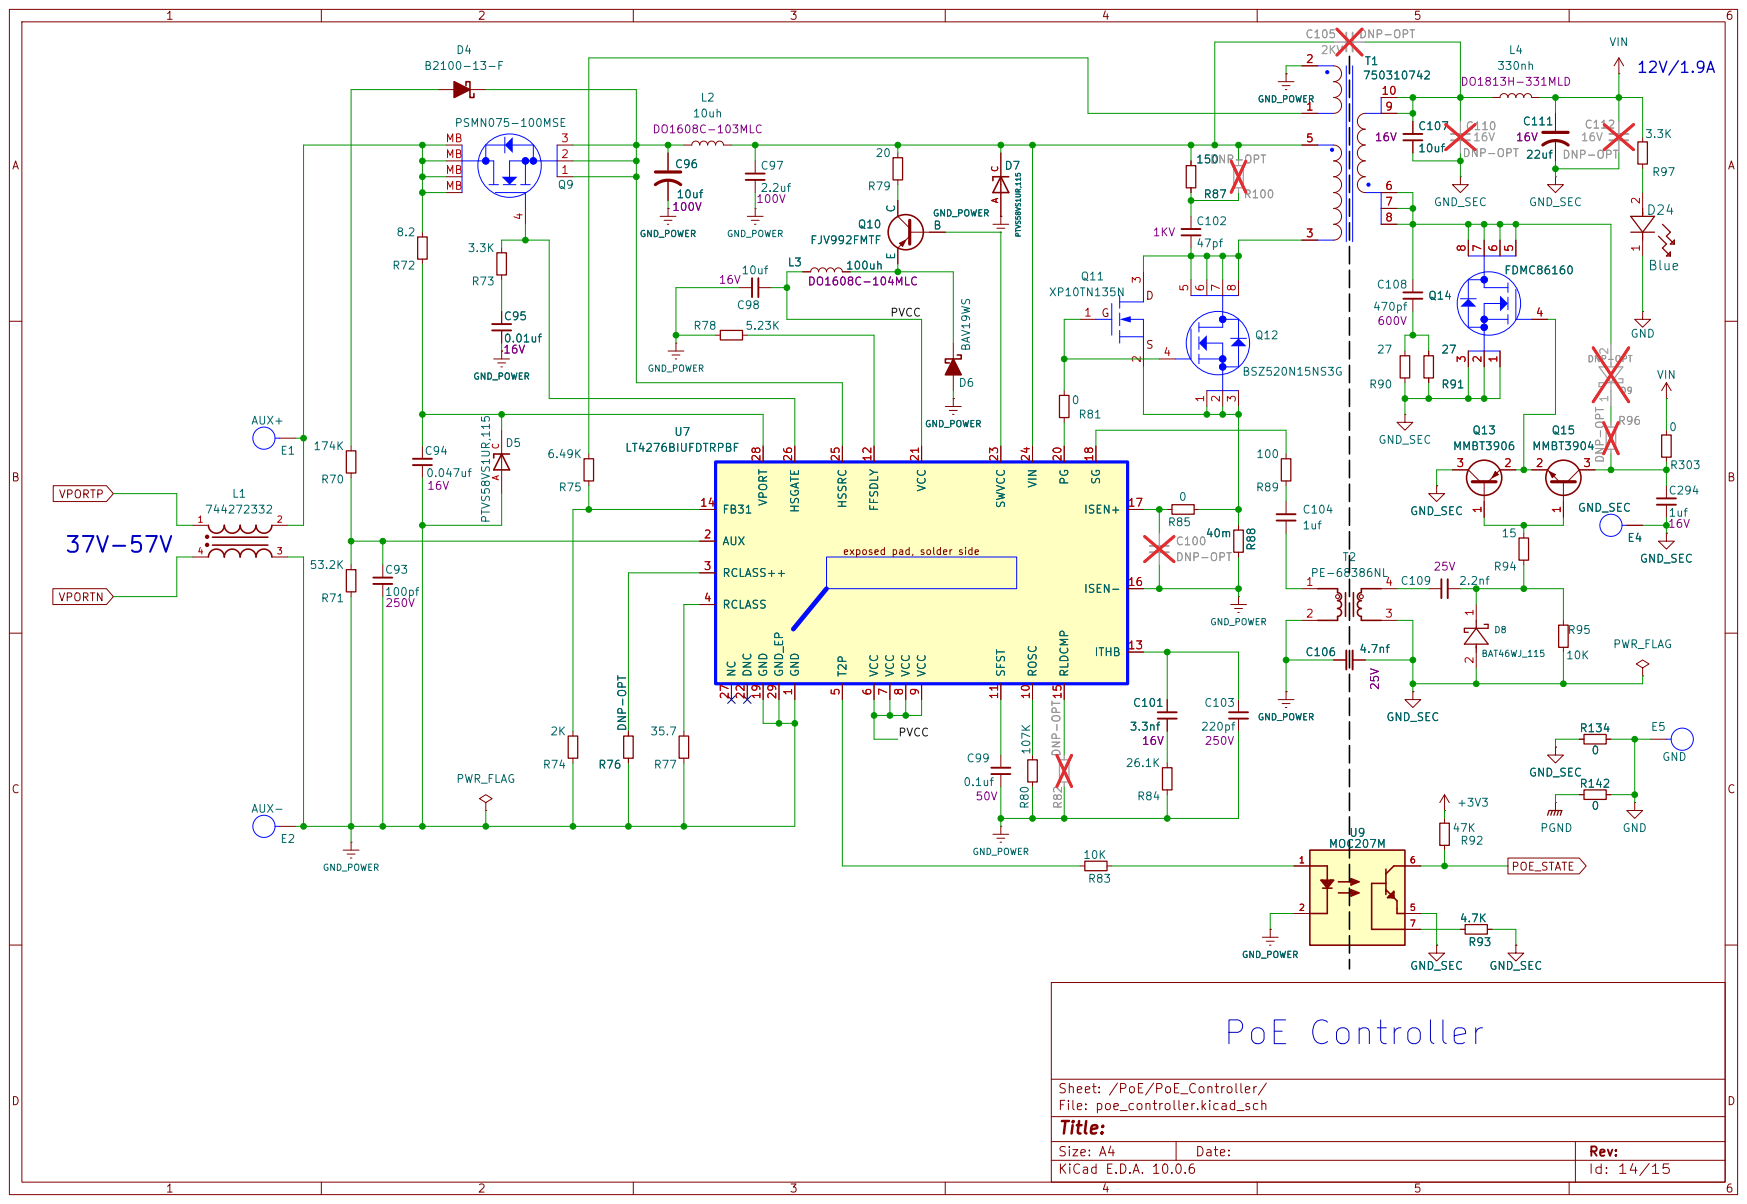
[picture p47: page 12]

exposed pad, solder side GND

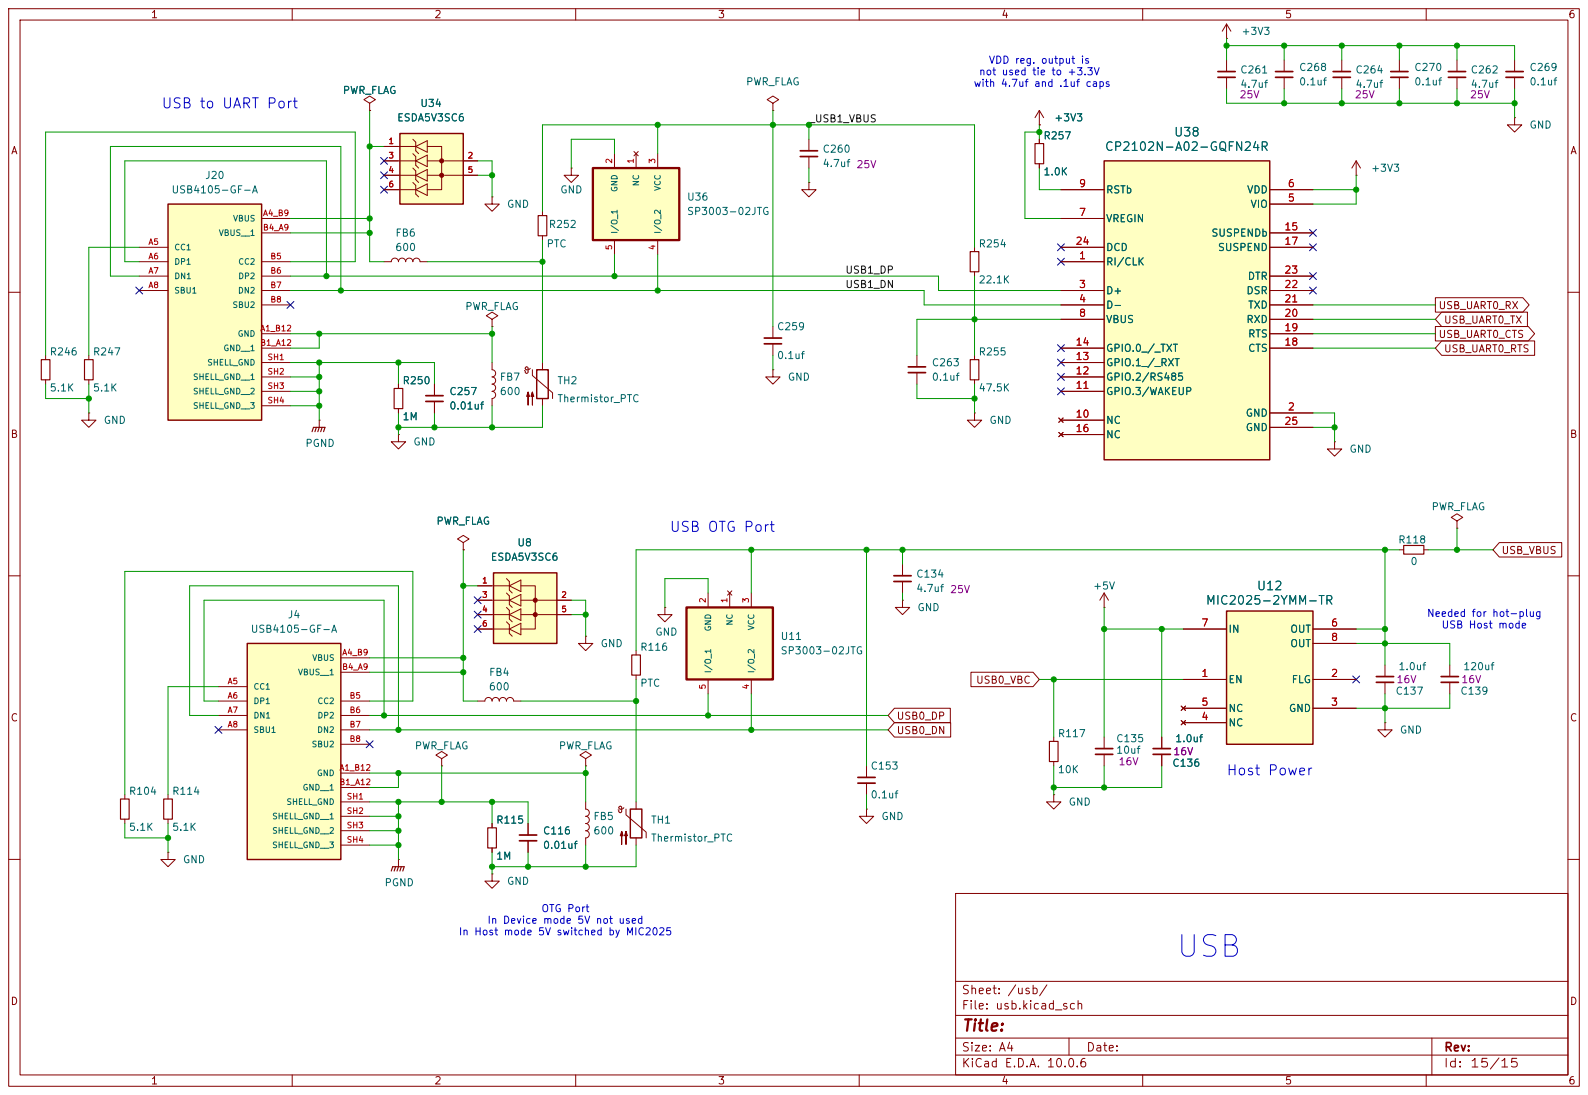
[picture p48: page 13]

In Device mode 5V not used
In Host mode 5V switched by MIC2025

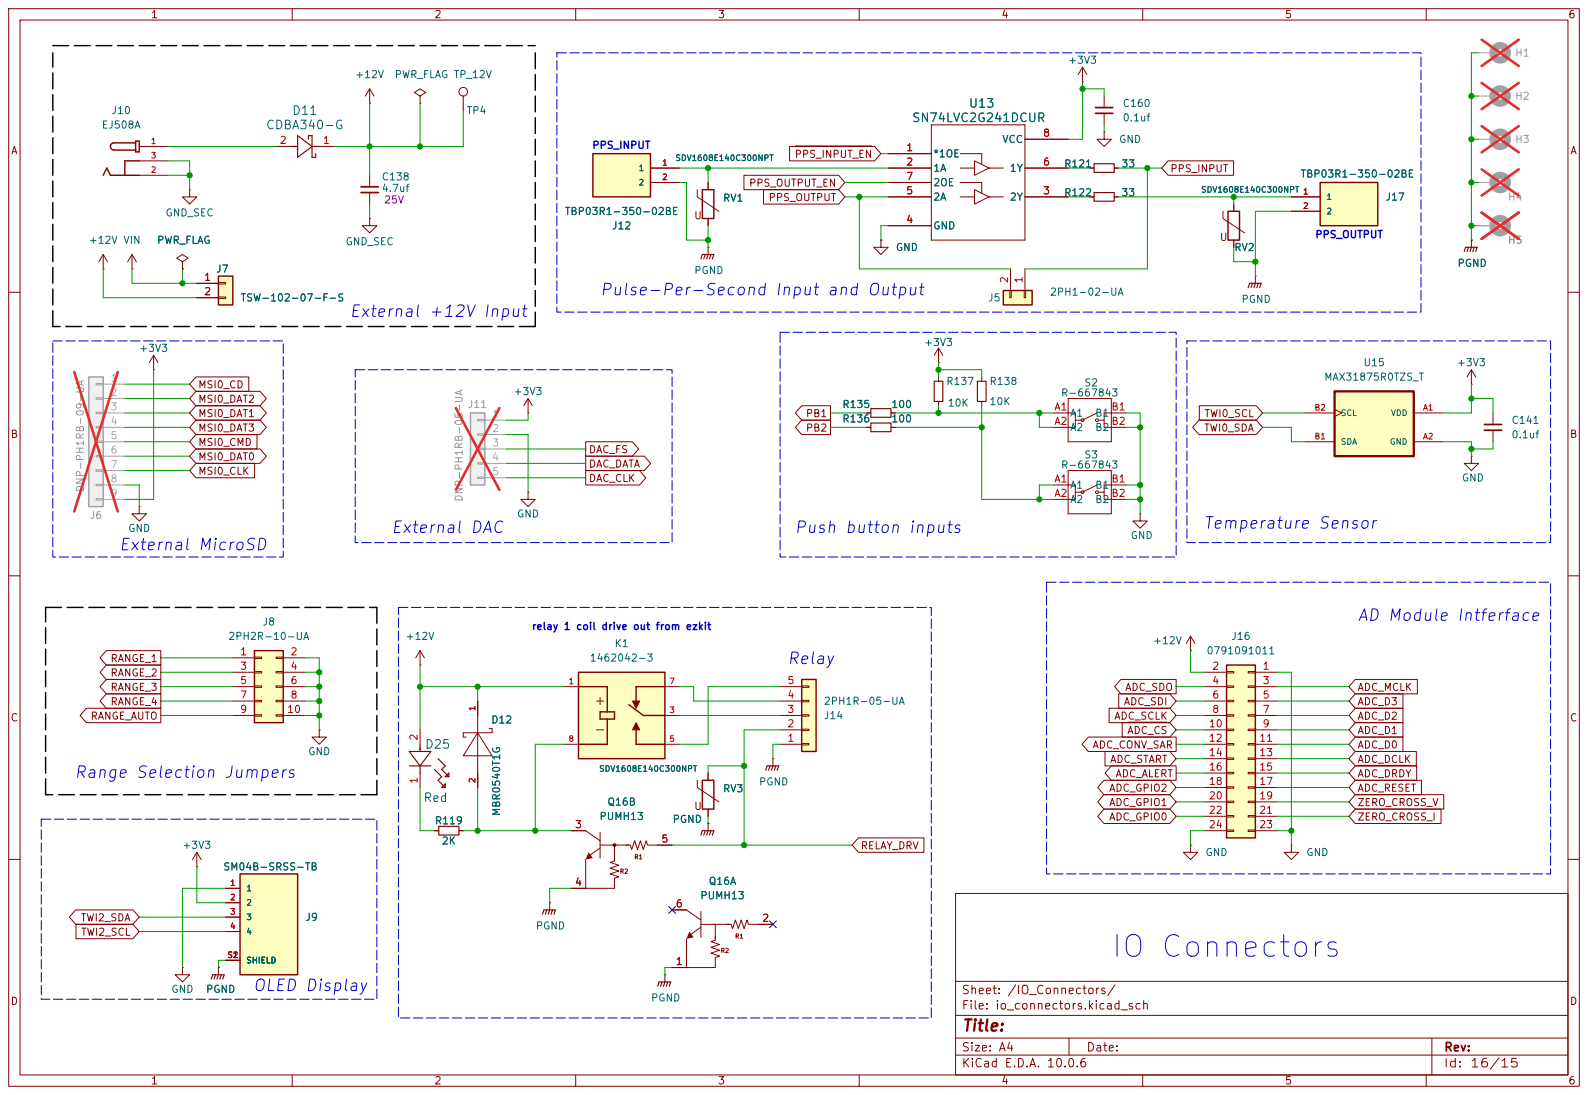
[picture p49: page 14]

Pulse-Per-Second Input and Output

relay 1 coil drive out from ezkit External +12V Input

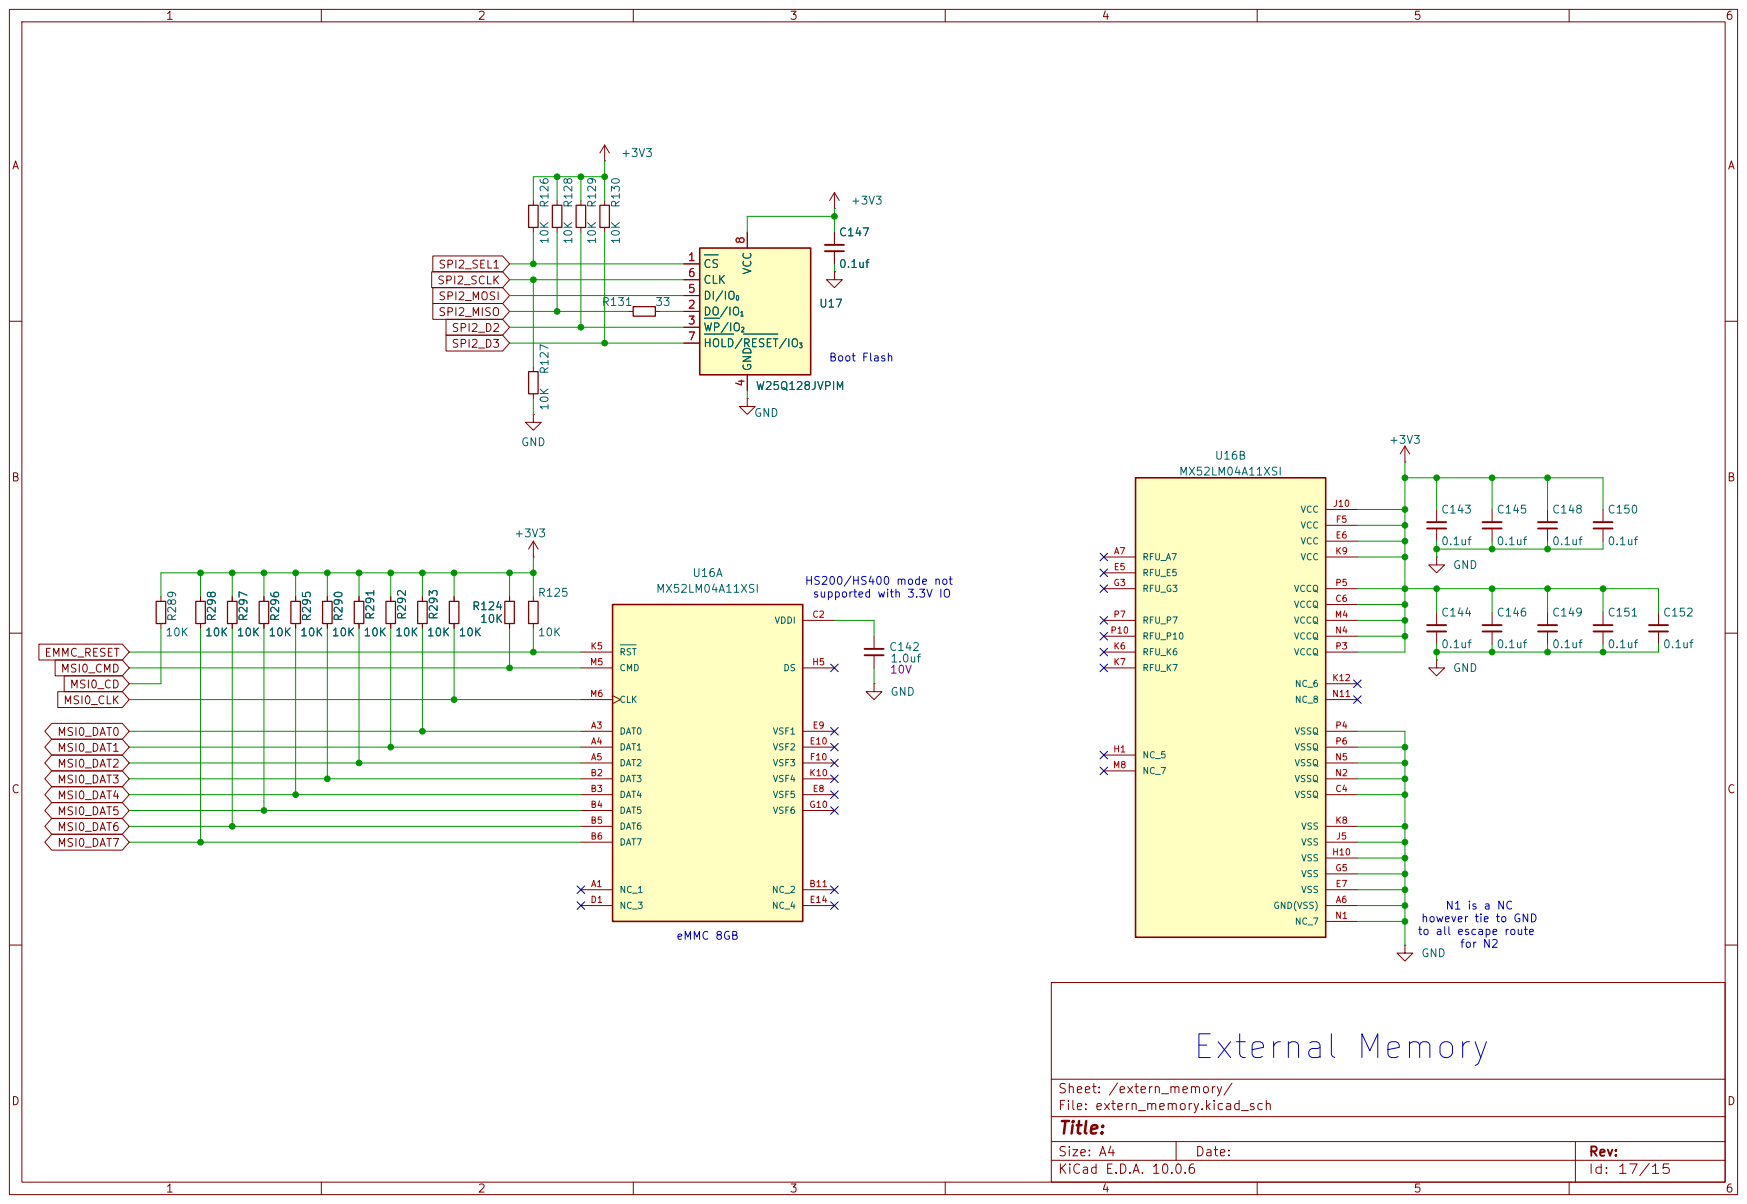
[picture p50: page 15]

4 DI/IO0 5 CLK 6 HOLD/RESET/IO3 7 VCC

however tie to GND
to all escape route
