twilkers1976/Omnisensor-dsp-board/gerbers/cpu_board.pdf

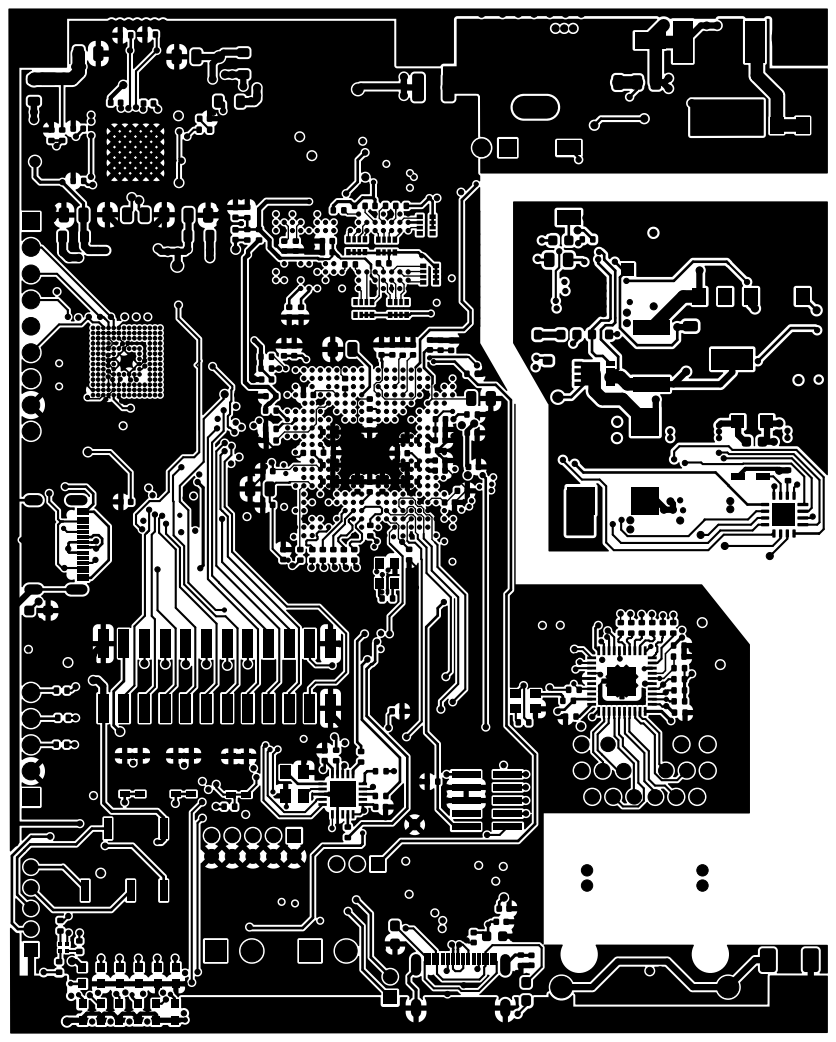
[picture p51: page 1]

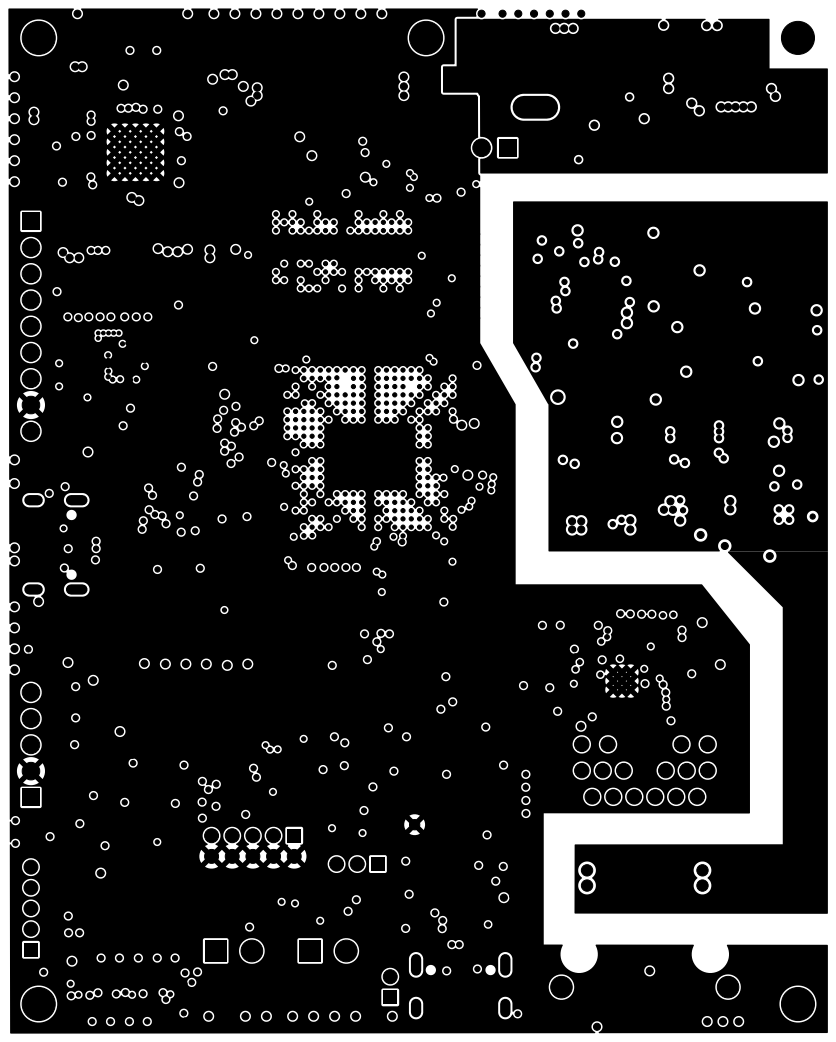
[picture p52: page 2]

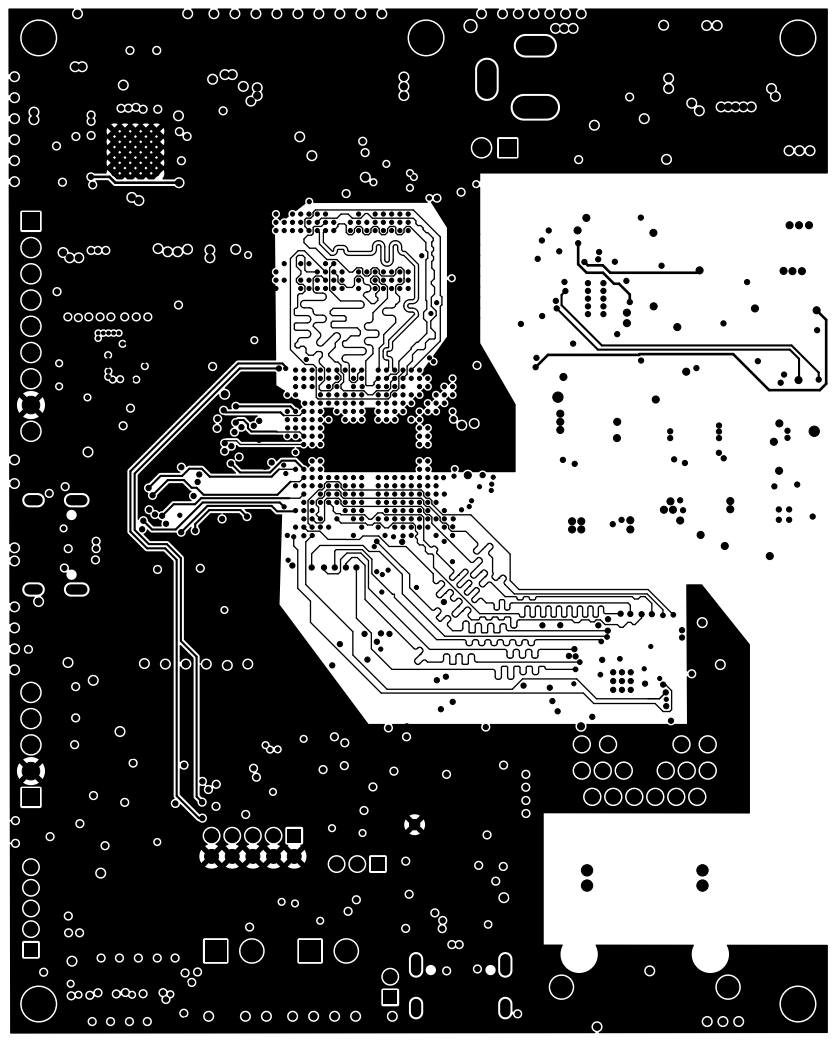
[picture p53: page 3]

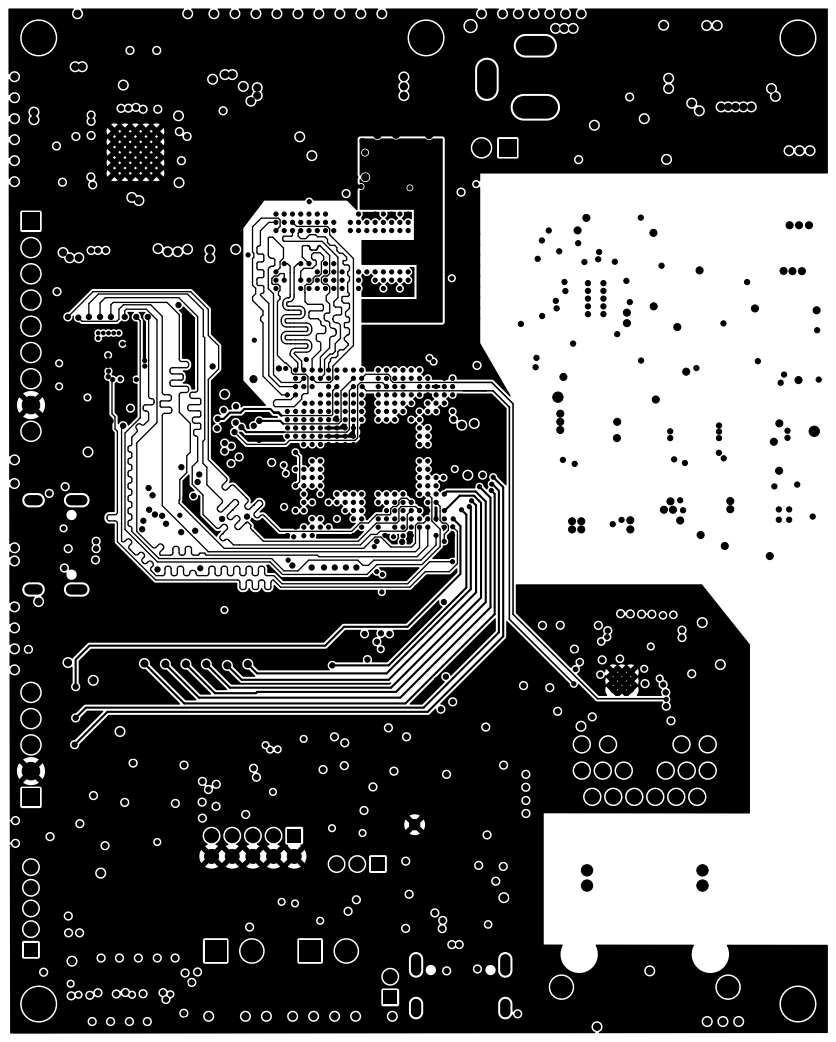
[picture p54: page 4]

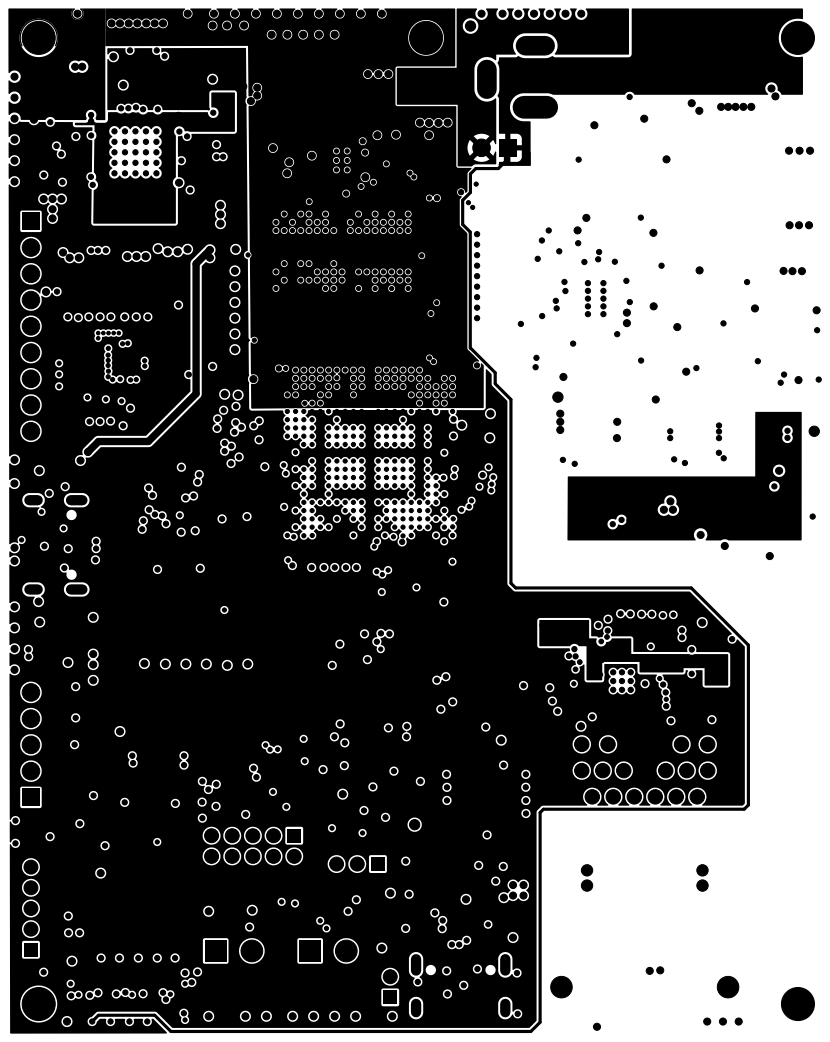
[picture p55: page 5]

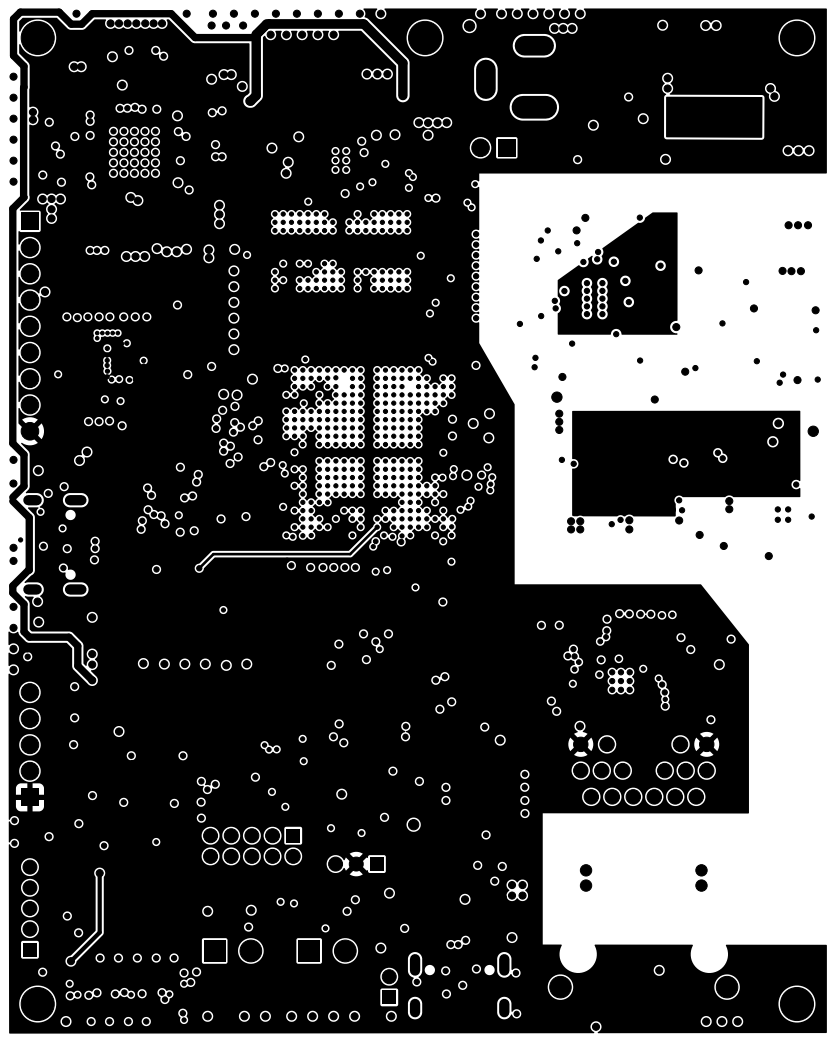
[picture p56: page 6]

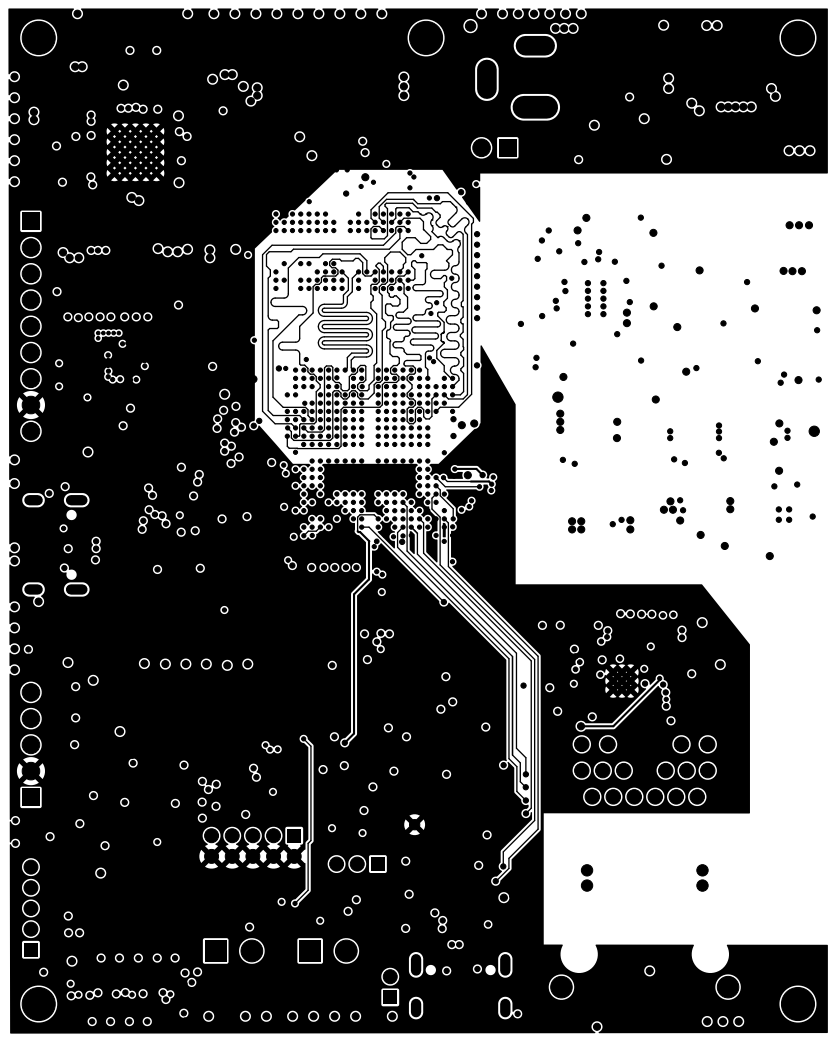
[picture p57: page 7]

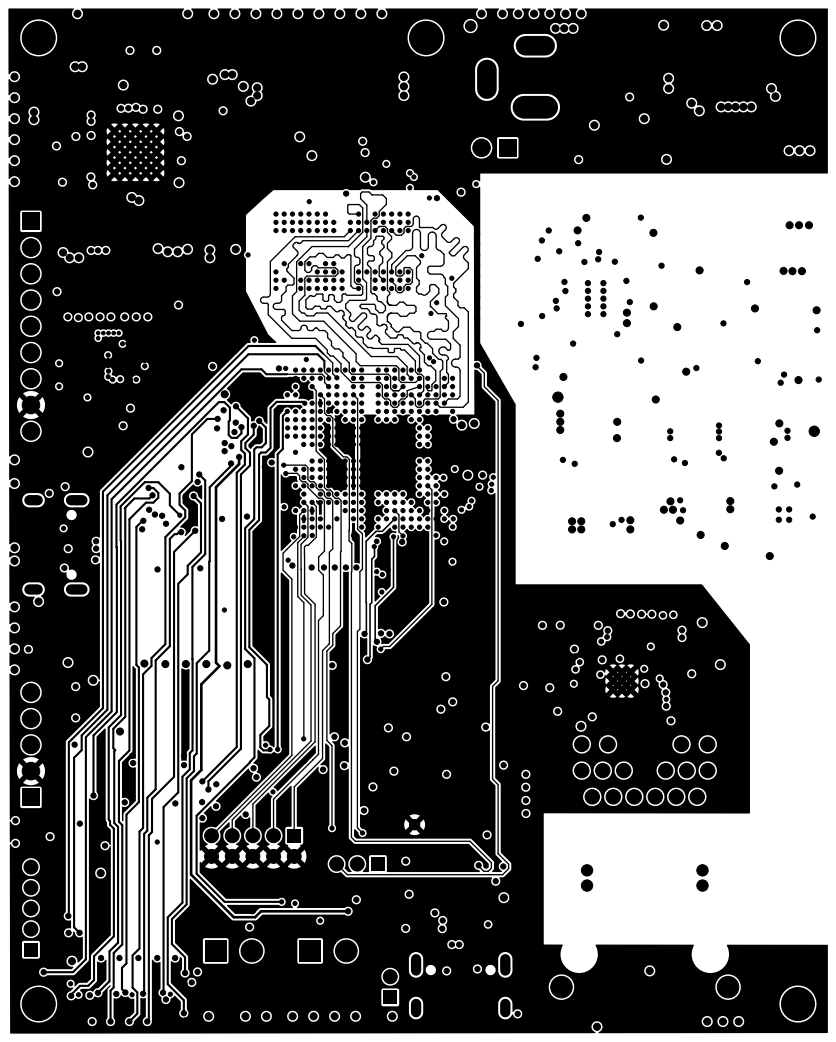
[picture p58: page 8]

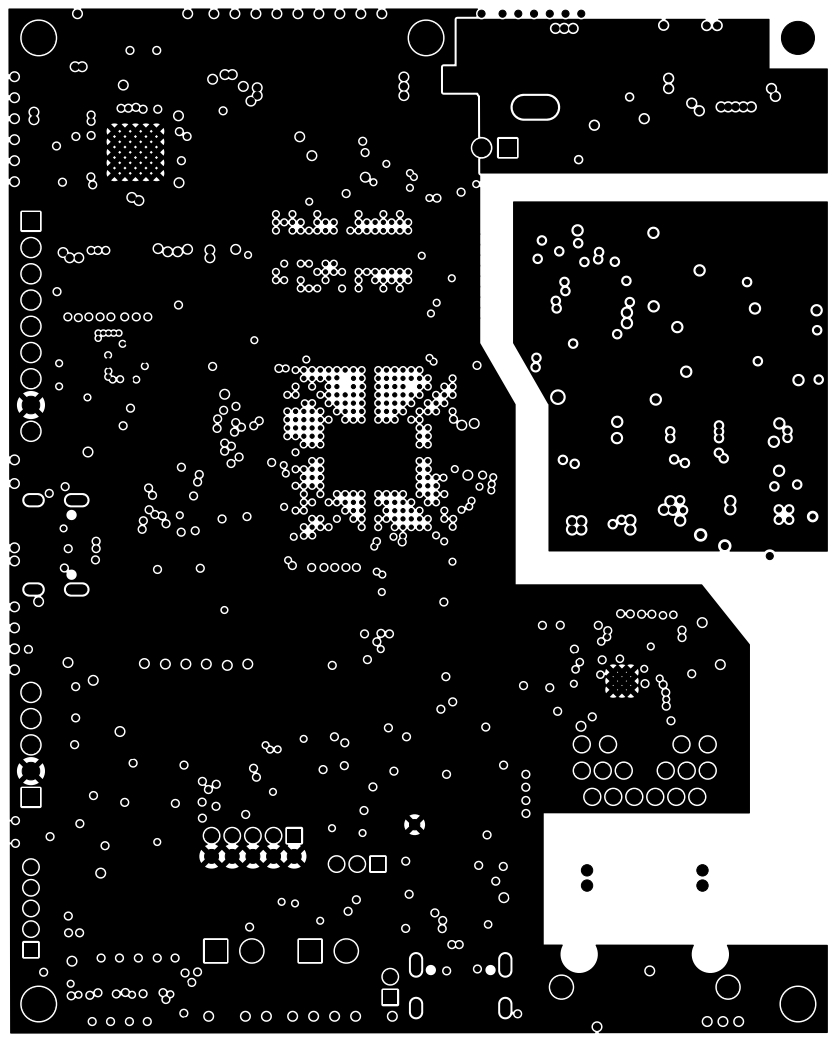
[picture p59: page 9]

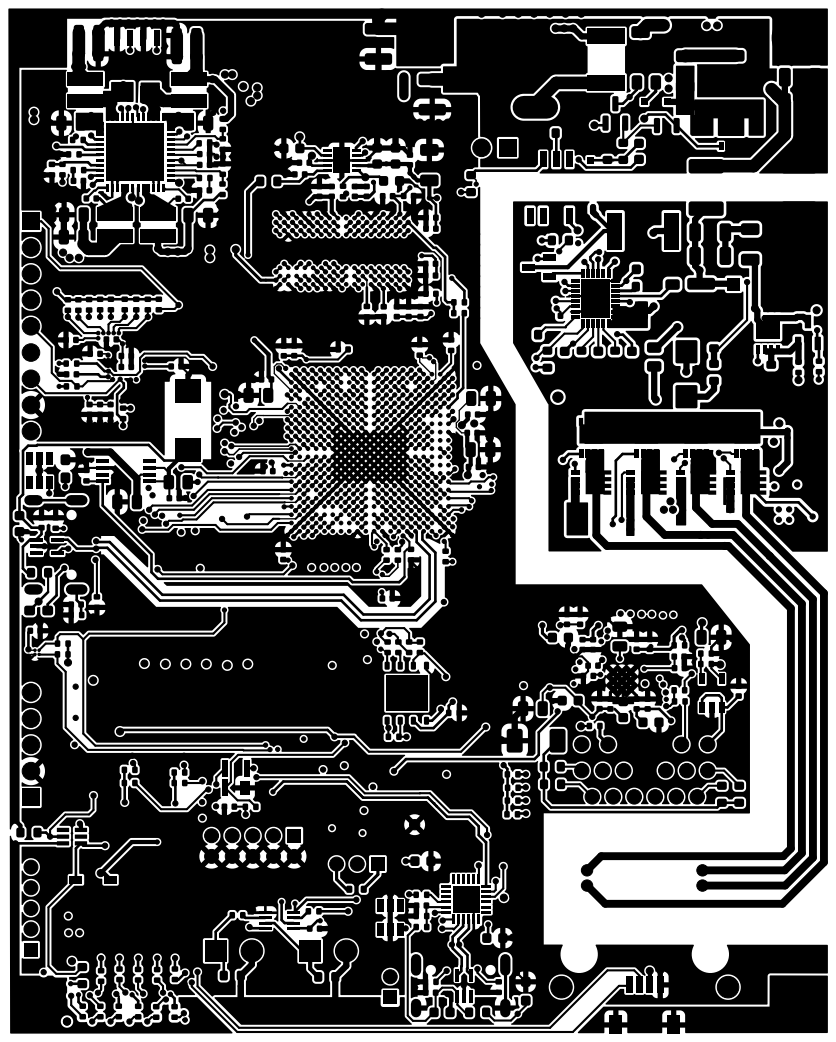
[picture p60: page 10]

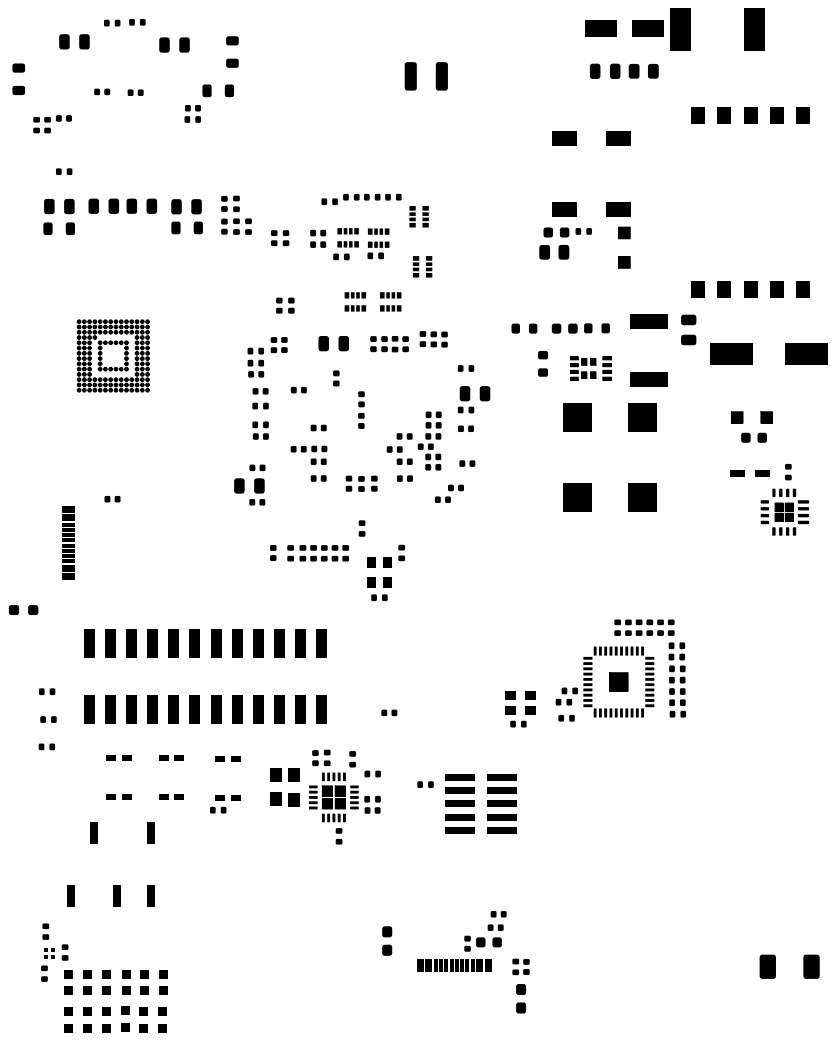
[picture p61: page 11]

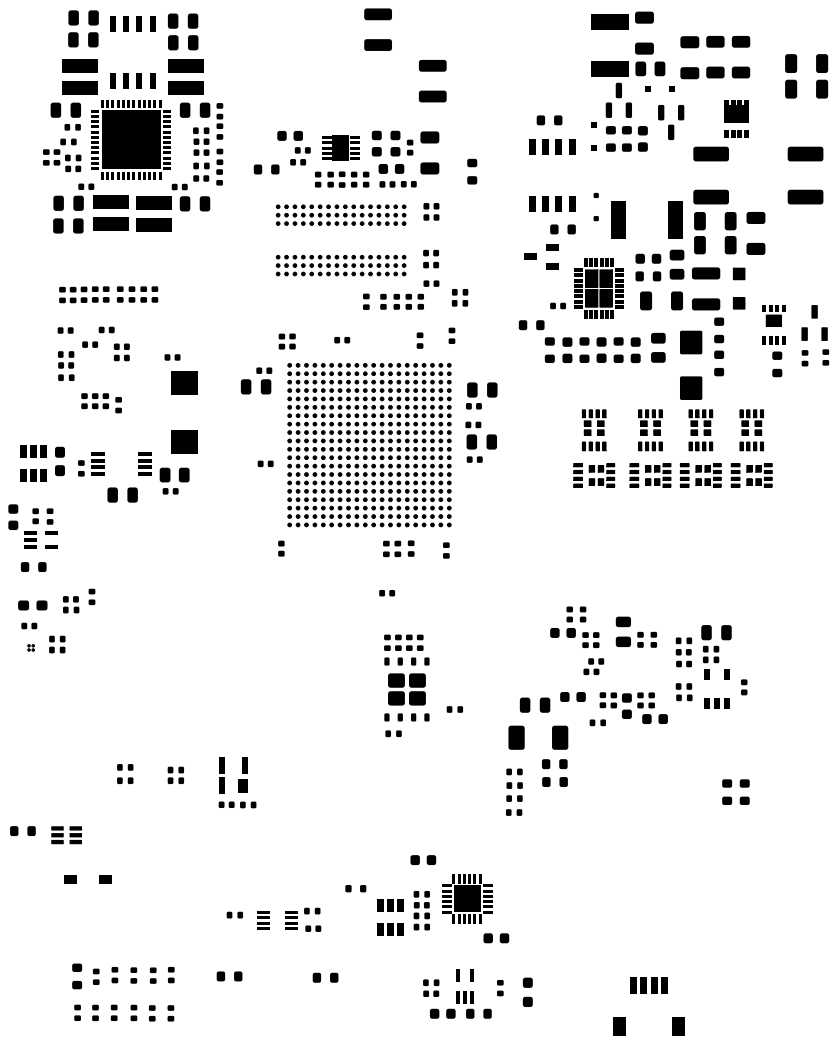
[picture p62: page 12]

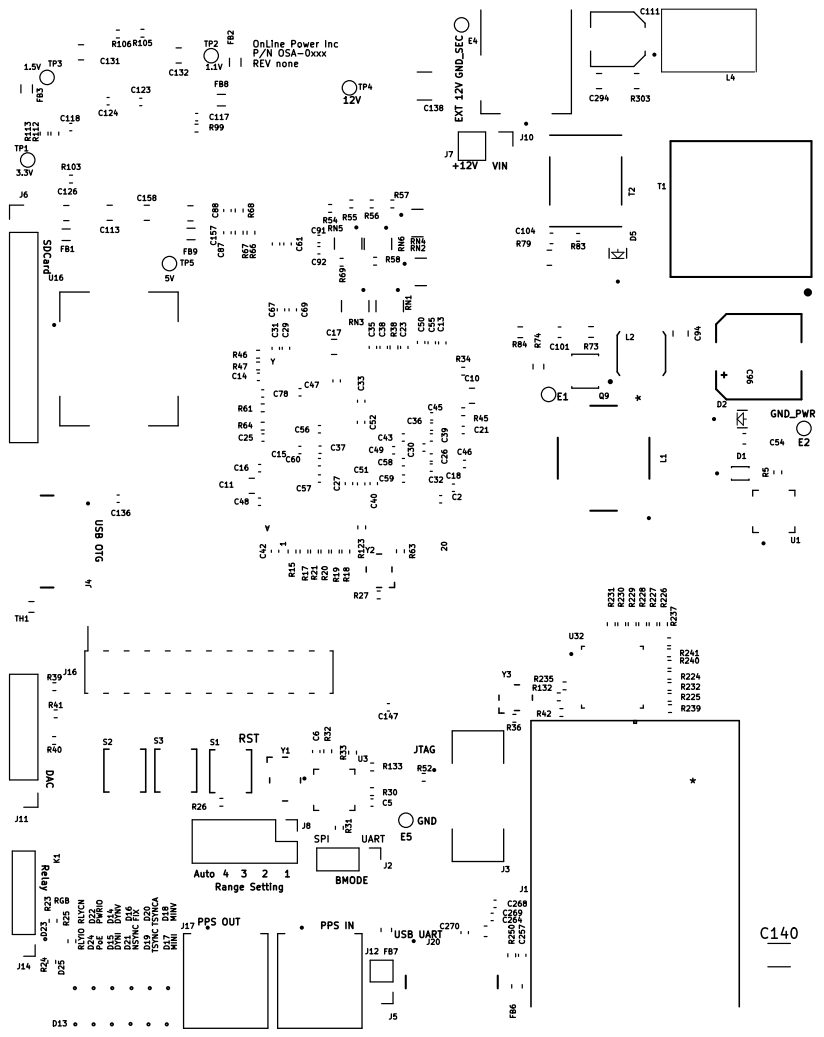
[picture p63: page 13]

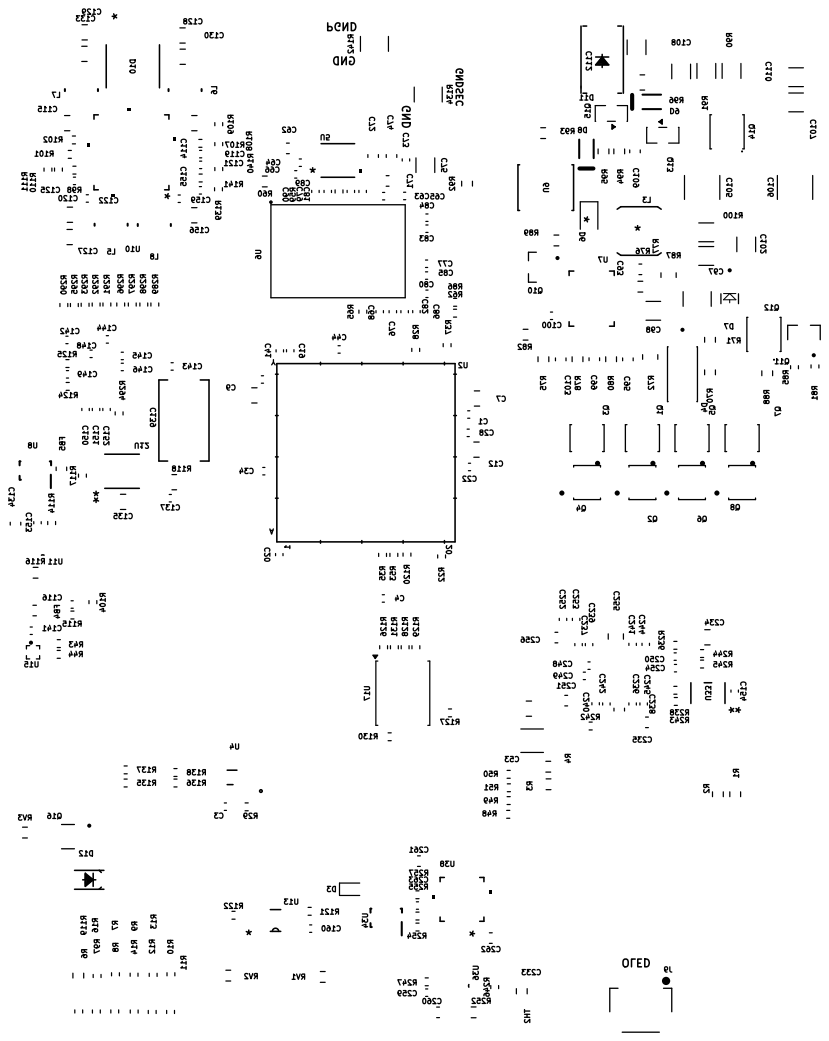
[picture p64: page 14]

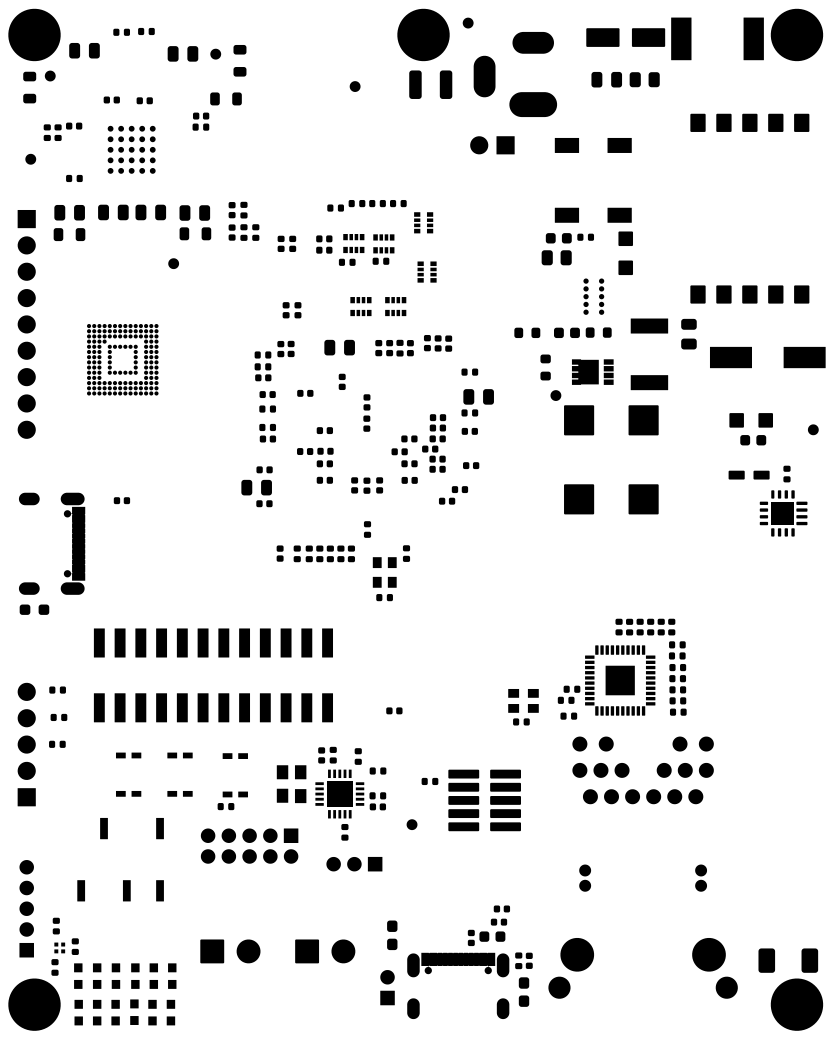
[picture p65: page 15]

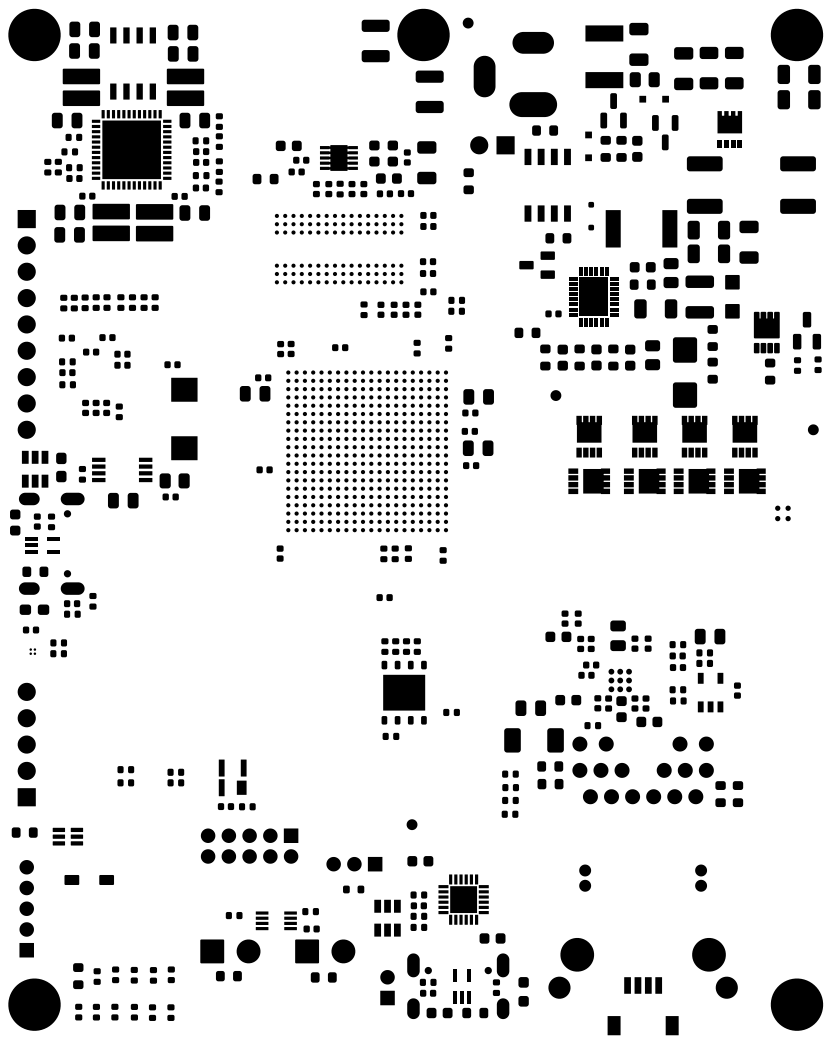
[picture p66: page 16]

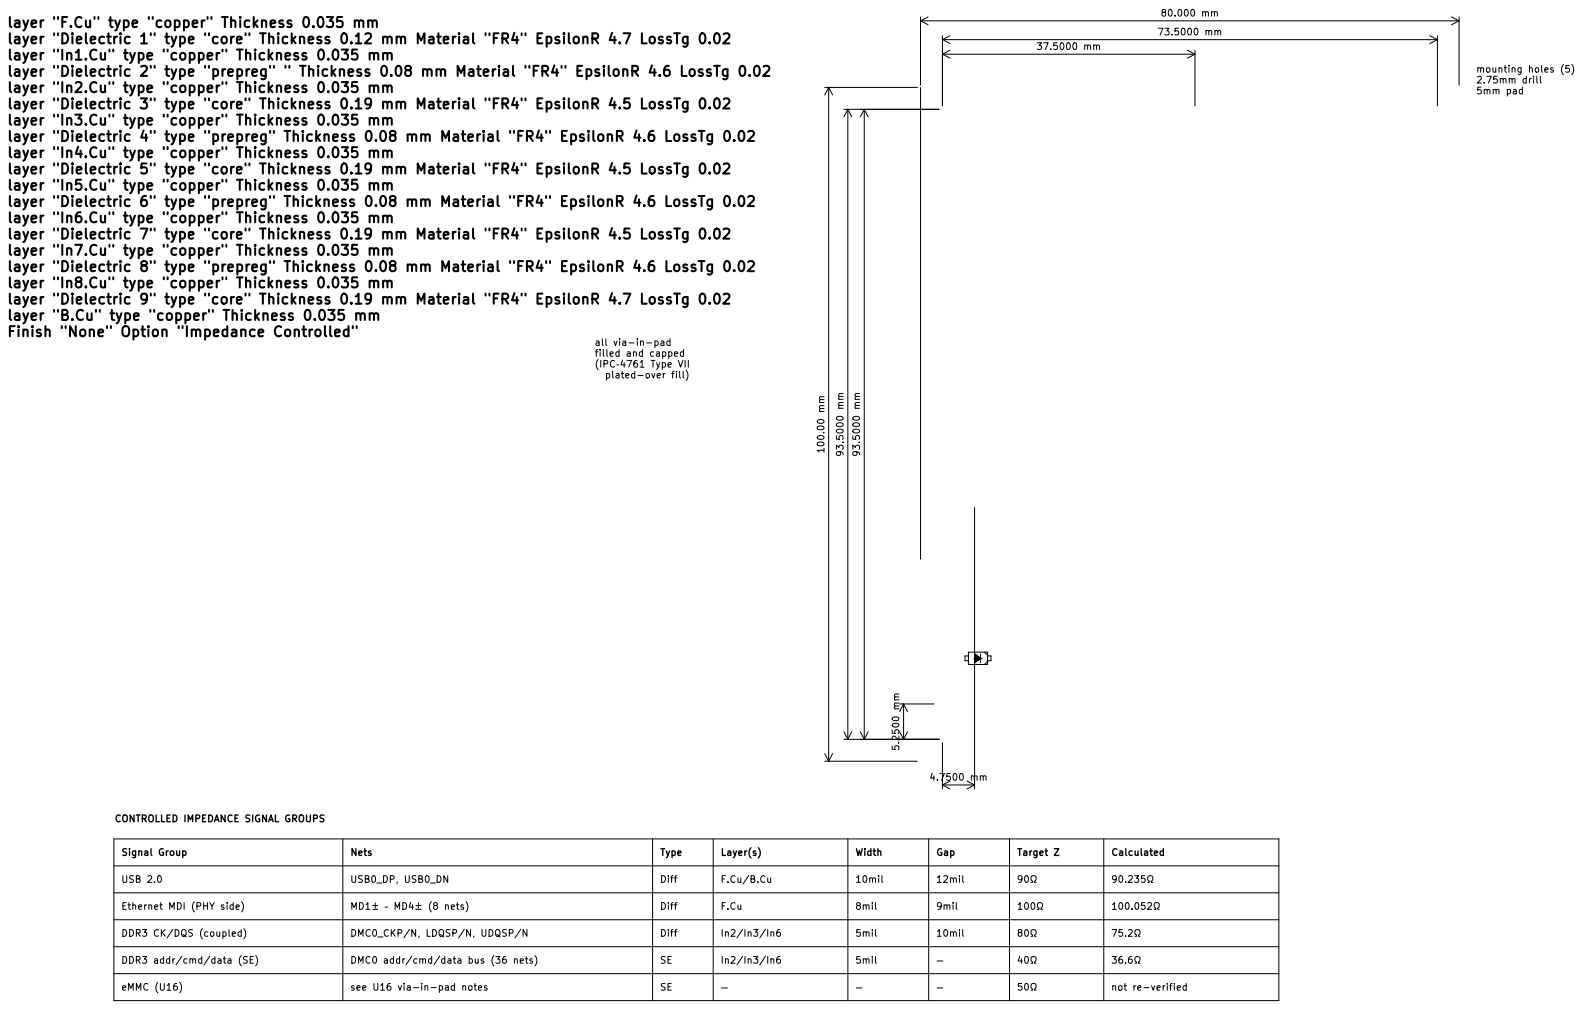
[picture p67: page 17]

layer "F.Cu" type "copper" Thickness 0.035 mm
layer "Dielectric 1" type "core" Thickness 0.12 mm Material "FR4" EpsilonR 4.7 LossTg 0.02
layer "In1.Cu" type "copper" Thickness 0.035 mm
layer "Dielectric 2" type "prepreg" " Thickness 0.08 mm Material "FR4" EpsilonR 4.6 LossTg 0.02
layer "In2.Cu" type "copper" Thickness 0.035 mm
layer "Dielectric 3" type "core" Thickness 0.19 mm Material "FR4" EpsilonR 4.5 LossTg 0.02
layer "In3.Cu" type "copper" Thickness 0.035 mm
layer "Dielectric 4" type "prepreg" Thickness 0.08 mm Material "FR4" EpsilonR 4.6 LossTg 0.02
layer "In4.Cu" type "copper" Thickness 0.035 mm
layer "Dielectric 5" type "core" Thickness 0.19 mm Material "FR4" EpsilonR 4.5 LossTg 0.02
layer "In5.Cu" type "copper" Thickness 0.035 mm
layer "Dielectric 6" type "prepreg" Thickness 0.08 mm Material "FR4" EpsilonR 4.6 LossTg 0.02
layer "In6.Cu" type "copper" Thickness 0.035 mm
layer "Dielectric 7" type "core" Thickness 0.19 mm Material "FR4" EpsilonR 4.5 LossTg 0.02
layer "In7.Cu" type "copper" Thickness 0.035 mm
layer "Dielectric 8" type "prepreg" Thickness 0.08 mm Material "FR4" EpsilonR 4.6 LossTg 0.02
layer "In8.Cu" type "copper" Thickness 0.035 mm
layer "Dielectric 9" type "core" Thickness 0.19 mm Material "FR4" EpsilonR 4.7 LossTg 0.02
layer "B.Cu" type "copper" Thickness 0.035 mm
Finish "None" Option "Impedance Controlled"

mounting holes (5) 2.75mm drill 5mm pad

all via-in-pad
filled and capped
(IPC‑4761 Type VII plated-over fill) Diff Diff Diff SESE

CONTROLLED IMPEDANCE SIGNAL GROUPS

Signal Group | Nets | Type | Layer(s) | Width | Gap | Target Z | Calculated

USB 2.0 | | | F.Cu/B.Cu | | | 90Ω | 90.235Ω

Ethernet MDI (PHY side) DDR3 CK/DQS (coupled) DDR3 addr/cmd/data (SE) eMMC (U16) | USB0_DP, USB0_DN MD1± – MD4± (8 nets) DMC0_CKP/N, LDQSP/N, UDQSP/N | | F.Cu | 10mil 8mil 5mil 5mil — | 12mil 9mil 10mil — | 100Ω | 100.052Ω

DMC0 addr/cmd/data bus (36 nets) see U16 via-in-pad notes | | In2/In3/In6 — | | | 40Ω | 36.6Ω

— | 50Ω | not re-verified
