twilkers1976/Omnisensor-dsp-board/cpu_board.kicad_pcb

## KiCad design cpu_board.kicad_pcb (2026-10-08)

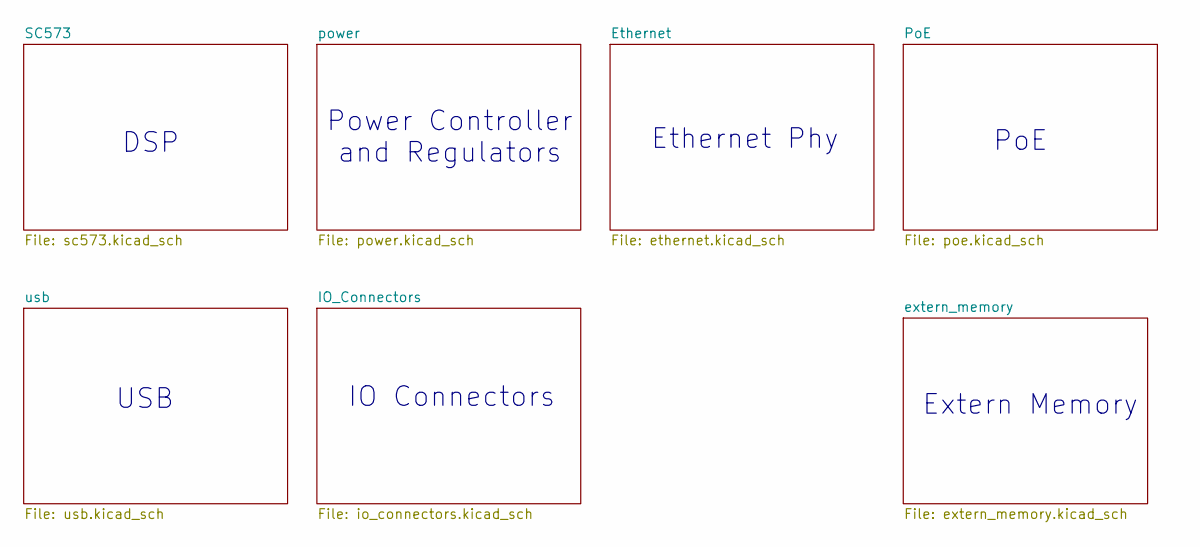
[picture p68: schematic cpu_board.kicad_sch]

Notes on the sheet:
PoE
Extern Memory
IO Connectors
Ethernet Phy
Power Controller and Regulators
DSP
USB

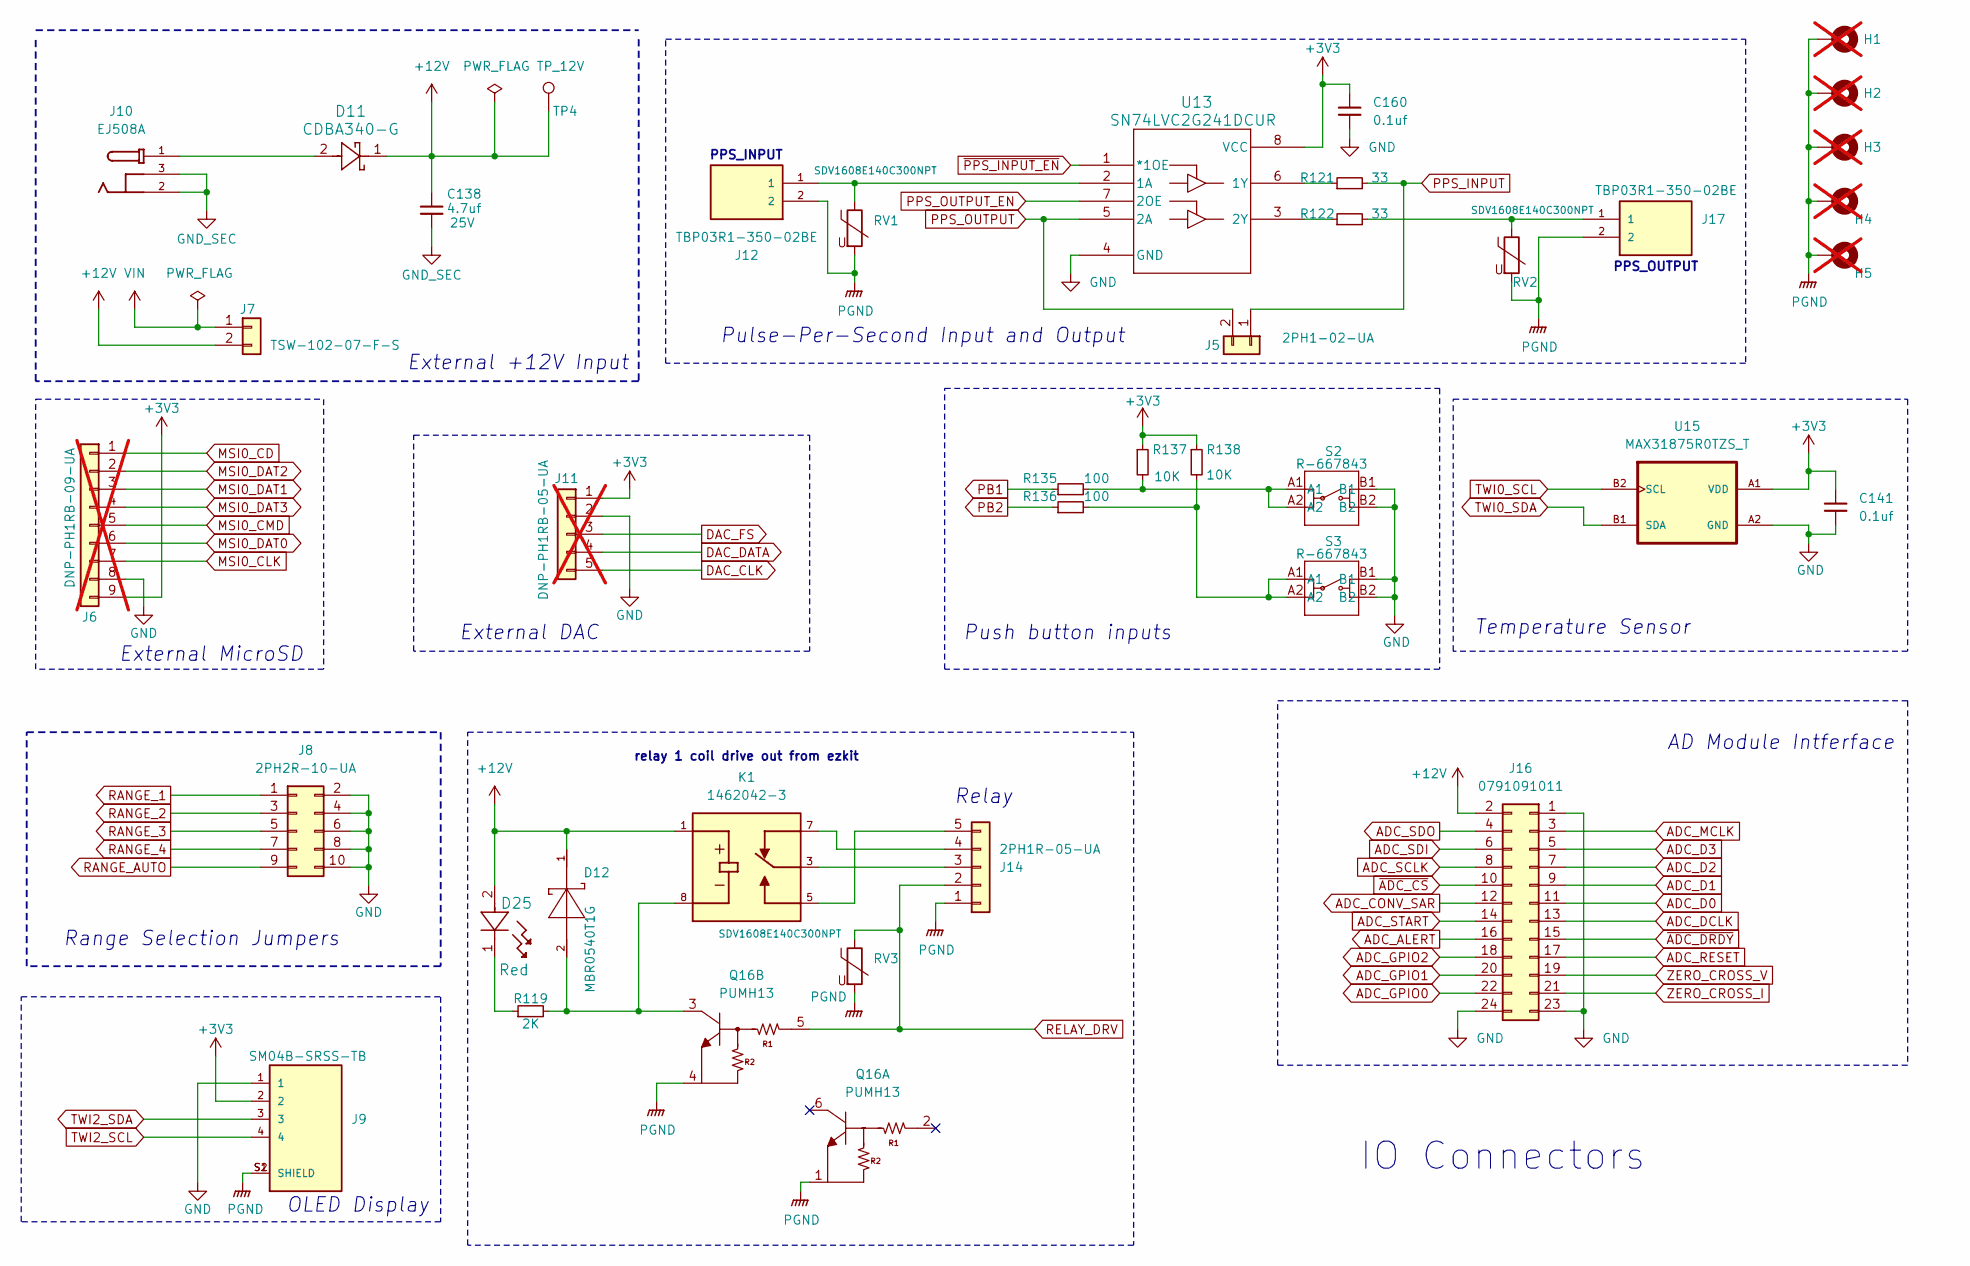
[picture p69: schematic io_connectors.kicad_sch]

Parts:
C138: 4.7uf; C_1210_3225Metric; Voltage 25V; Rating 25V; Part Number C1210C475K3RACTU
C141, C160: 0.1uf; C_0402_1005Metric; Rating 50V; Part Number 04025C104KAT2A
D11: CDBA340-G; CDBA-G; Part Number CDBA340-G
D12: MBR0540T1G; SOD-123; Part Number MBR0540T1G
D25: Red; LED_B1931NG_HVK; Part Number B1911USD-20D000114U1930
H1, H2, H3, H4, H5: MountingHole; MountingHole_2.5mm_Pad_TopBottom; not fitted
J5: 2PH1-02-UA; PinHeader_1x02_P2.00mm_Vertical; Part Number 2PH1-02-UA
J6: DNP-PH1RB-09-UA; PinHeader_1x09_P2.54mm_Vertical; Part Number PH1RB-09-UA; not fitted
J7: TSW-102-07-F-S; PinHeader_1x02_P2.54mm_Vertical; Rating 3A; Part Number TSW-102-07-F-S
J8: 2PH2R-10-UA; PinHeader_2x05_P2.00mm_Vertical; Part Number 2PH2R-10-UA
J9: SM04B-SRSS-TB; JST_SM04B-SRSS-TB(LF)(SN); Part Number SM04B-SRSS-TB
J10: EJ508A; MPD_EJ508A; PARTREV J
J11: DNP-PH1RB-05-UA; PinHeader_1x05_P2.54mm_Vertical; Part Number PH1RB-05-UA; not fitted
J12, J17: TBP03R1-350-02BE; CUI_TBP03R1-350-02BE; Part Number TBP03R1-350-02BE
J14: 2PH1R-05-UA; PinHeader_1x05_P2.00mm_Vertical; Part Number 2PH1R-05-UA
J16: 0791091011; PinSocket_2x12_P2.00mm_Vertical_SMD; Part Number 0791091011
K1: 1462042-3; PARTREV 0721
Q16: PUMH13; SOP65P210X110-6N; Part Numnber PUMH13F; DIGIKEY MUN5114T1GOSCT-ND
R119: 2K; R_0603_1608Metric; Rating 1/10 W; Part Number RN73H1JTTD2001F100
R121, R122: 33; R_0402_1005Metric; Part Number RMCF0402FT33R0
R135, R136: 100; R_0402_1005Metric; Part Number RMCF0402FT100R
R137, R138: 10K; R_0402_1005Metric; Part Number RMCF0402FT10K0
RV1, RV2, RV3: SDV1608E140C300NPT; R_0603_1608Metric; Part Number SDV1608E140C300NPT
S2, S3: R-667843; R-667843_MIT; PARTREV 14 Apr 22
TP4: TP_12V; TestPoint_Pad_D1.0mm
U13: SN74LVC2G241DCUR; DCU8; Part Number SN74LVC2G241DCUR
U15: MAX31875R0TZS_T; BGA4N40P2X2_83X83X37N; Part Number MAX31875R0TZS+T

Connections:
+3V3: C141.1, C160.1, J6.9, J9.2, J11.1, R137.1, R138.1, U13.8 (VCC), U15.A1 (VDD); also elsewhere on the board
+12V: C138.1, D11.1, D12.1, D25.2, J7.2, J16.2, K1.1, TP4.1 (1_1); also elsewhere on the board
ADC_ALERT: J16.16; also elsewhere on the board
ADC_CONV_SAR: J16.12; also elsewhere on the board
ADC_D0: J16.11; also elsewhere on the board
ADC_D1: J16.9; also elsewhere on the board
ADC_D2: J16.7; also elsewhere on the board
ADC_D3: J16.5; also elsewhere on the board
ADC_DCLK: J16.13; also elsewhere on the board
ADC_GPIO0: J16.22; also elsewhere on the board
ADC_GPIO1: J16.20; also elsewhere on the board
ADC_GPIO2: J16.18; also elsewhere on the board
ADC_MCLK: J16.3; also elsewhere on the board
ADC_RESET: J16.17; also elsewhere on the board
ADC_SCLK: J16.8; also elsewhere on the board
ADC_SDI: J16.6; also elsewhere on the board
ADC_SDO: J16.4; also elsewhere on the board
ADC_START: J16.14; also elsewhere on the board
DAC_CLK: J11.5; also elsewhere on the board
DAC_DATA: J11.4; also elsewhere on the board
DAC_FS: J11.3; also elsewhere on the board
GND: C141.2, C160.2, J6.8, J8.2, J8.4, J8.6, J8.8, J8.10, J9.1, J11.2, J16.1, J16.23, J16.24, S2.B1, S2.B2, S3.B1, S3.B2, U13.4 (GND), U15.A2 (GND); also elsewhere on the board
GND_SEC: C138.2, J10.2, J10.3; also elsewhere on the board
MSI0_CD: J6.1; also elsewhere on the board
MSI0_CLK: J6.7; also elsewhere on the board
MSI0_CMD: J6.5; also elsewhere on the board
MSI0_DAT0: J6.6; also elsewhere on the board
MSI0_DAT1: J6.3; also elsewhere on the board
MSI0_DAT2: J6.2; also elsewhere on the board
MSI0_DAT3: J6.4; also elsewhere on the board
unnamed: D11.2, J10.1
unnamed: D25.1, R119.1
unnamed: J14.3, K1.3
unnamed: J14.4, K1.7
unnamed: J14.5, K1.5
unnamed: J17.1, R122.2, RV2.1
unnamed: D12.2, K1.8, Q16.3 (COLLECTOR), R119.2
unnamed: R135.2, R137.2, S2.A1, S2.A2
unnamed: R136.2, R138.2, S3.A1, S3.A2
unnamed: J12.1, RV1.1, U13.2 (1A)
unnamed: R121.1, U13.6 (1Y)
unnamed: R122.1, U13.3 (2Y)
PB1: R135.1; also elsewhere on the board
PB2: R136.1; also elsewhere on the board
PGND: H1.1 (1_1), H2.1 (1_1), H3.1 (1_1), H4.1 (1_1), H5.1 (1_1), J9.S1 (SHIELD), J9.S2 (SHIELD), J12.2, J14.1, J17.2, Q16.1 (EMITTER), Q16.4 (EMITTER), RV1.2, RV2.2, RV3.2; also elsewhere on the board
PPS_INPUT: J5.1, R121.2; also elsewhere on the board
PPS_OUTPUT: J5.2, U13.5 (2A); also elsewhere on the board
PPS_OUTPUT_EN: U13.7 (2OE); also elsewhere on the board
RANGE_1: J8.1; also elsewhere on the board
RANGE_2: J8.3; also elsewhere on the board
RANGE_3: J8.5; also elsewhere on the board
RANGE_4: J8.7; also elsewhere on the board
RANGE_AUTO: J8.9; also elsewhere on the board
RELAY_DRV: J14.2, Q16.5 (BASE), RV3.1; also elsewhere on the board
TWI0_SCL: U15.B2 (SCL); also elsewhere on the board
TWI0_SDA: U15.B1 (SDA); also elsewhere on the board
TWI2_SCL: J9.4; also elsewhere on the board
TWI2_SDA: J9.3; also elsewhere on the board
VIN: J7.1; also elsewhere on the board
ZERO_CROSS_I: J16.21; also elsewhere on the board
ZERO_CROSS_V: J16.19; also elsewhere on the board
~ADC_CS: J16.10; also elsewhere on the board
~ADC_DRDY: J16.15; also elsewhere on the board
~PPS_INPUT_EN: U13.1 (*1OE); also elsewhere on the board

Notes on the sheet:
Range Selection Jumpers
relay 1 coil drive out from ezkit
External MicroSD
Push button inputs
IO Connectors
Pulse-Per-Second Input and Output
PPS_OUTPUT
PPS_INPUT
AD Module Intferface
External +12V Input
Temperature Sensor
OLED Display
Relay
External DAC

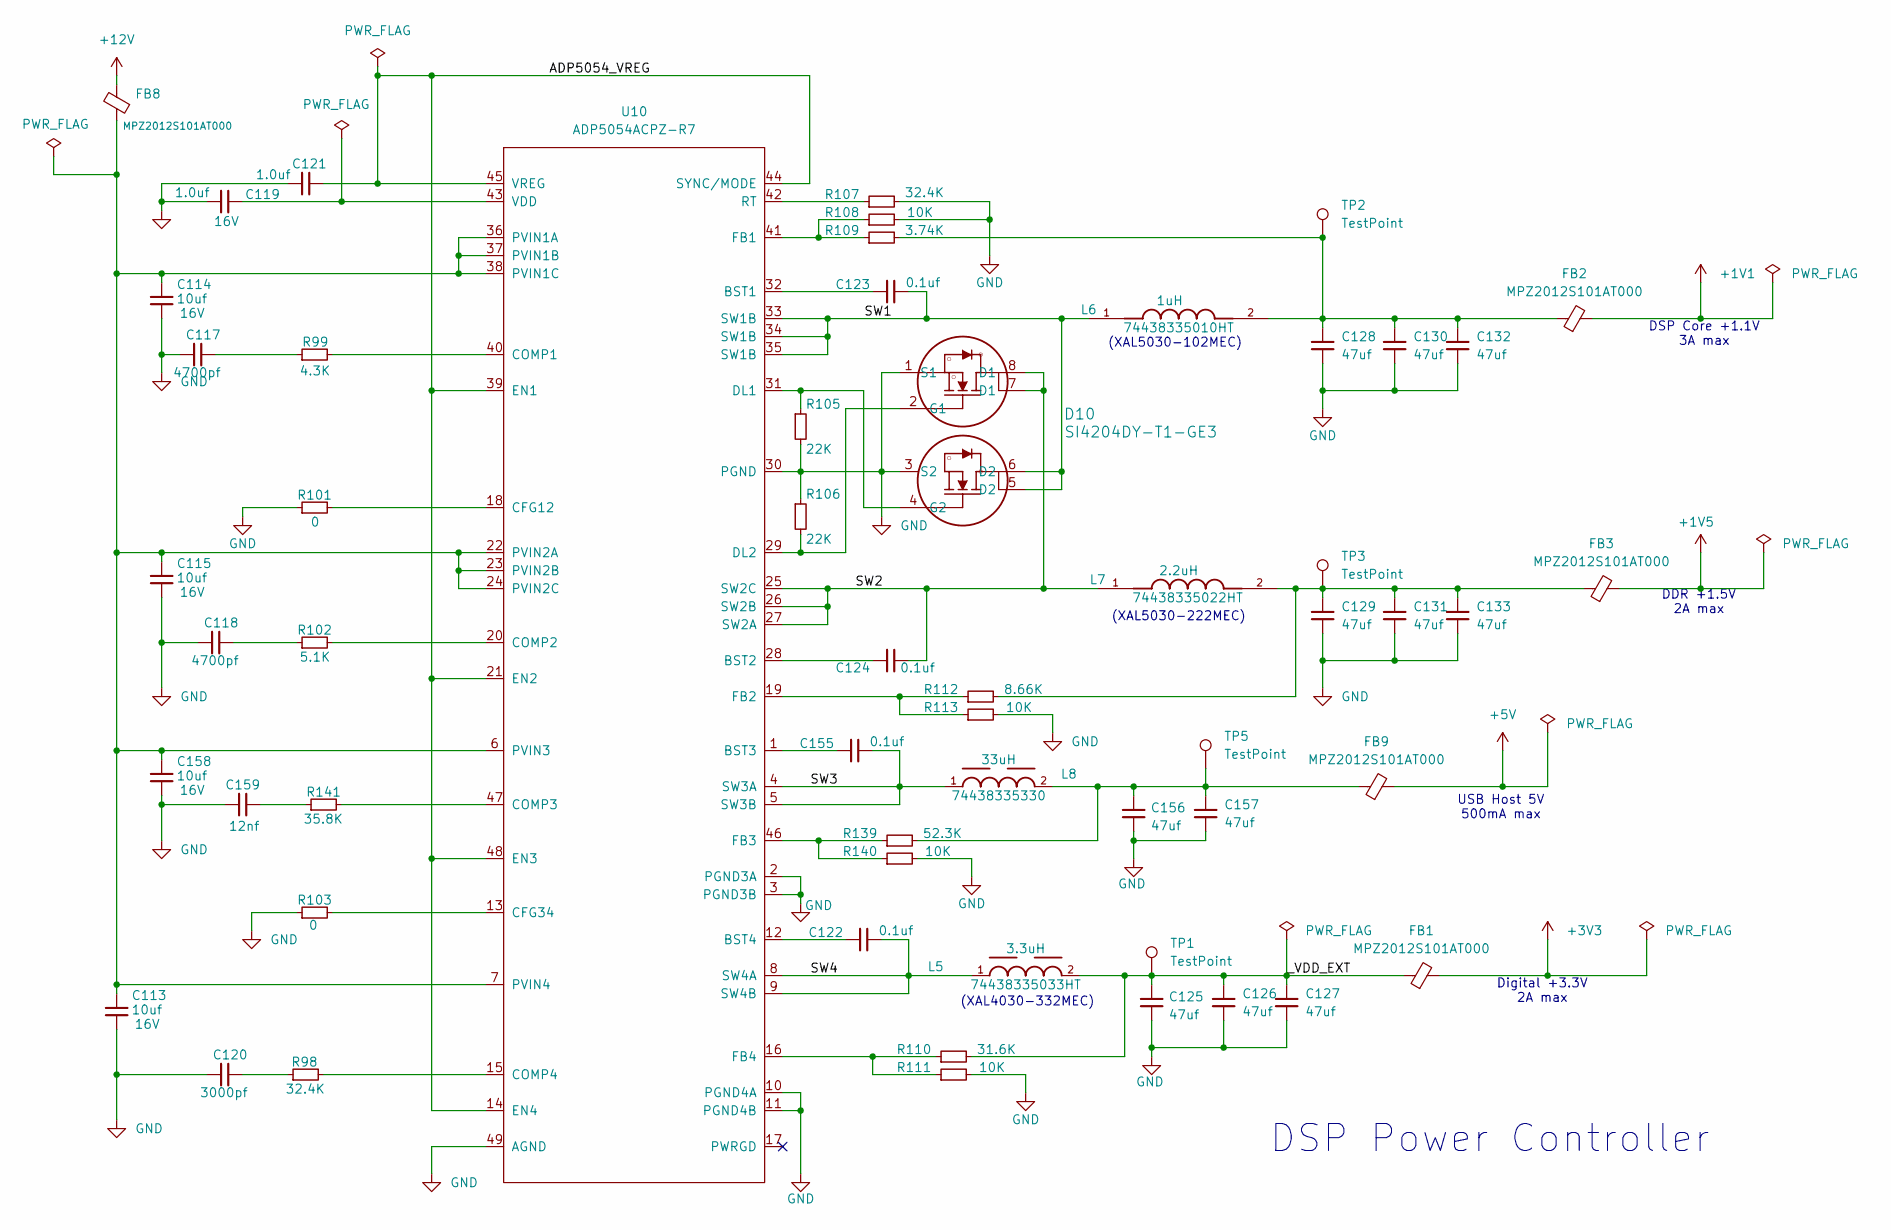
[picture p70: schematic power.kicad_sch]

Parts:
C113, C114, C115, C158: 10uf; C_0805_2012Metric; Voltage 16V; Rating 16V; Part Number EMK212BJ106KG-T
C117, C118: 4700pf; C_0402_1005Metric; Rating 50V; Part Number GCM155R71H472KA37D
C119, C121: 1.0uf; C_0402_1005Metric; Voltage 16V; Rating 16V; Part Number EMK105BJ105KV-F
C120: 3000pf; C_0402_1005Metric; Rating 50V; Part Number GMC04X7R302K50NT
C122, C123, C124, C155: 0.1uf; C_0402_1005Metric; Rating 50V; Part Number 04025C104KAT2A
C125, C126, C127, C128, C129, C130, C131, C132, C133, C156, C157: 47uf; C_0805_2012Metric; Rating 6.3V; Part Number JMK212BJ476MG-T
C159: 12nf; C_0402_1005Metric; Rating 50V; Part Number GCM155R71H122KA37D
D10: SI4204DY-T1-GE3; SOIC8_MS-012_VIS; Part Number SI4204DY-T1-GE3
FB1, FB3, FB8, FB9: MPZ2012S101AT000; L_0805_2012Metric; Rating 4A, 100 ohm; Part Number MPZ2012S101AT000
FB2: MPZ2012S101AT000; L_0805_2012Metric; Rating 4A, 100ohm; Part Number MPZ2012S101AT000
L5: 3.3uH; WE-MAPI_3015; Rating 2.7A; Part Number 74438335033HT
L6: 1uH; WE-MAPI_3015; Rating 4.5A; Part Number 74438335010HT
L7: 2.2uH; WE-MAPI_3015; Rating 3.2A; Part Number 74438335022HT
L8: 33uH; WE-MAPI_3015; Rating 500mA; Part Number 74438335330
R98, R107: 32.4K; R_0402_1005Metric; Part Number RMCF0402FT32K4
R99: 4.3K; R_0402_1005Metric; Part Number RMCF0402FT4K30
R101, R103: 0; R_0402_1005Metric; Part Number RMCF0402ZT0R00
R102: 5.1K; R_0402_1005Metric; Part Number RMCF0402FT5K10
R105, R106: 22K; R_0402_1005Metric; Part Number RMCF0402FT22K0
R108, R111, R113, R140: 10K; R_0402_1005Metric; Part Number RMCF0402FT10K0
R109: 3.74K; R_0402_1005Metric; Part Number RMCF0402FT3K74
R110: 31.6K; R_0402_1005Metric; Part Number RMCF0402FT31K6
R112: 8.66K; R_0402_1005Metric; Part Number RMCF0402FT8K66
R139: 52.3K; R_0402_1005Metric; Part Number RMCF0402FT52K3
R141: 35.8K; R_0402_1005Metric; Part Number RMCF0402FT35K7
TP1, TP2, TP3, TP5: TestPoint; TestPoint_Pad_D1.0mm
U10: ADP5054ACPZ-R7; CP_48_13_ADI; Part Number ADP5054ACPZ-R7

Connections:
+1V1: FB2.2; also elsewhere on the board
+1V5: FB3.2; also elsewhere on the board
+3V3: FB1.2; also elsewhere on the board
+5V: FB9.2; also elsewhere on the board
+12V: FB8.2; also elsewhere on the board
/power/ADP5054_VREG: C121.1, U10.14 (EN4), U10.21 (EN2), U10.39 (EN1), U10.44 (SYNC/MODE), U10.45 (VREG), U10.48 (EN3)
/power/SW1: C123.2, D10.5 (D2), D10.6 (D2), L6.1, U10.33 (SW1B), U10.34 (SW1B), U10.35 (SW1B)
/power/SW2: C124.2, D10.7 (D1), D10.8 (D1), L7.1, U10.25 (SW2C), U10.26 (SW2B), U10.27 (SW2A)
/power/SW3: C155.2, L8.1, U10.4 (SW3A), U10.5 (SW3B)
/power/SW4: C122.2, L5.1, U10.8 (SW4A), U10.9 (SW4B)
/power/_VDD_EXT: C125.1, C126.1, C127.1, FB1.1, L5.2, R110.2, TP1.1 (1_1)
GND: C113.2, C114.2, C115.2, C117.2, C118.2, C119.2, C120.2, C121.2, C125.2, C126.2, C127.2, C128.2, C129.2, C130.2, C131.2, C132.2, C133.2, C156.2, C157.2, C158.2, C159.2, D10.1 (S1), D10.3 (S2), R101.1, R103.1, R105.2, R106.1, R107.2, R108.2, R111.2, R113.2, R140.2, U10.2 (PGND3A), U10.3 (PGND3B), U10.10 (PGND4A), U10.11 (PGND4B), U10.30 (PGND), U10.49 (AGND); also elsewhere on the board
unnamed: C117.1, R99.1
unnamed: C118.1, R102.1
unnamed: C120.1, R98.1
unnamed: C128.1, C130.1, C132.1, FB2.1, L6.2, R109.2, TP2.1 (1_1)
unnamed: C129.1, C131.1, C133.1, FB3.1, L7.2, R112.2, TP3.1 (1_1)
unnamed: C156.1, C157.1, FB9.1, L8.2, R139.2, TP5.1 (1_1)
unnamed: C159.1, R141.1
unnamed: D10.2 (G1), R106.2, U10.29 (DL2)
unnamed: D10.4 (G2), R105.1, U10.31 (DL1)
unnamed: C123.1, U10.32 (BST1)
unnamed: C124.1, U10.28 (BST2)
unnamed: C155.1, U10.1 (BST3)
unnamed: C122.1, U10.12 (BST4)
unnamed: R101.2, U10.18 (CFG12)
unnamed: R103.2, U10.13 (CFG34)
unnamed: R99.2, U10.40 (COMP1)
unnamed: R102.2, U10.20 (COMP2)
unnamed: R141.2, U10.47 (COMP3)
unnamed: R98.2, U10.15 (COMP4)
unnamed: R108.1, R109.1, U10.41 (FB1)
unnamed: R112.1, R113.1, U10.19 (FB2)
unnamed: R139.1, R140.1, U10.46 (FB3)
unnamed: R110.1, R111.1, U10.16 (FB4)
unnamed: C113.1, C114.1, C115.1, C158.1, FB8.1, U10.6 (PVIN3), U10.7 (PVIN4), U10.22 (PVIN2A), U10.23 (PVIN2B), U10.24 (PVIN2C), U10.36 (PVIN1A), U10.37 (PVIN1B), U10.38 (PVIN1C)
unnamed: R107.1, U10.42 (RT)
unnamed: C119.1, U10.43 (VDD)

Notes on the sheet:
(XAL5030-222MEC)
(XAL5030-102MEC)
DDR +1.5V 2A max
Digital +3.3V 2A max
USB Host 5V 500mA max
DSP Core +1.1V 3A max
DSP Power Controller
(XAL4030-332MEC)

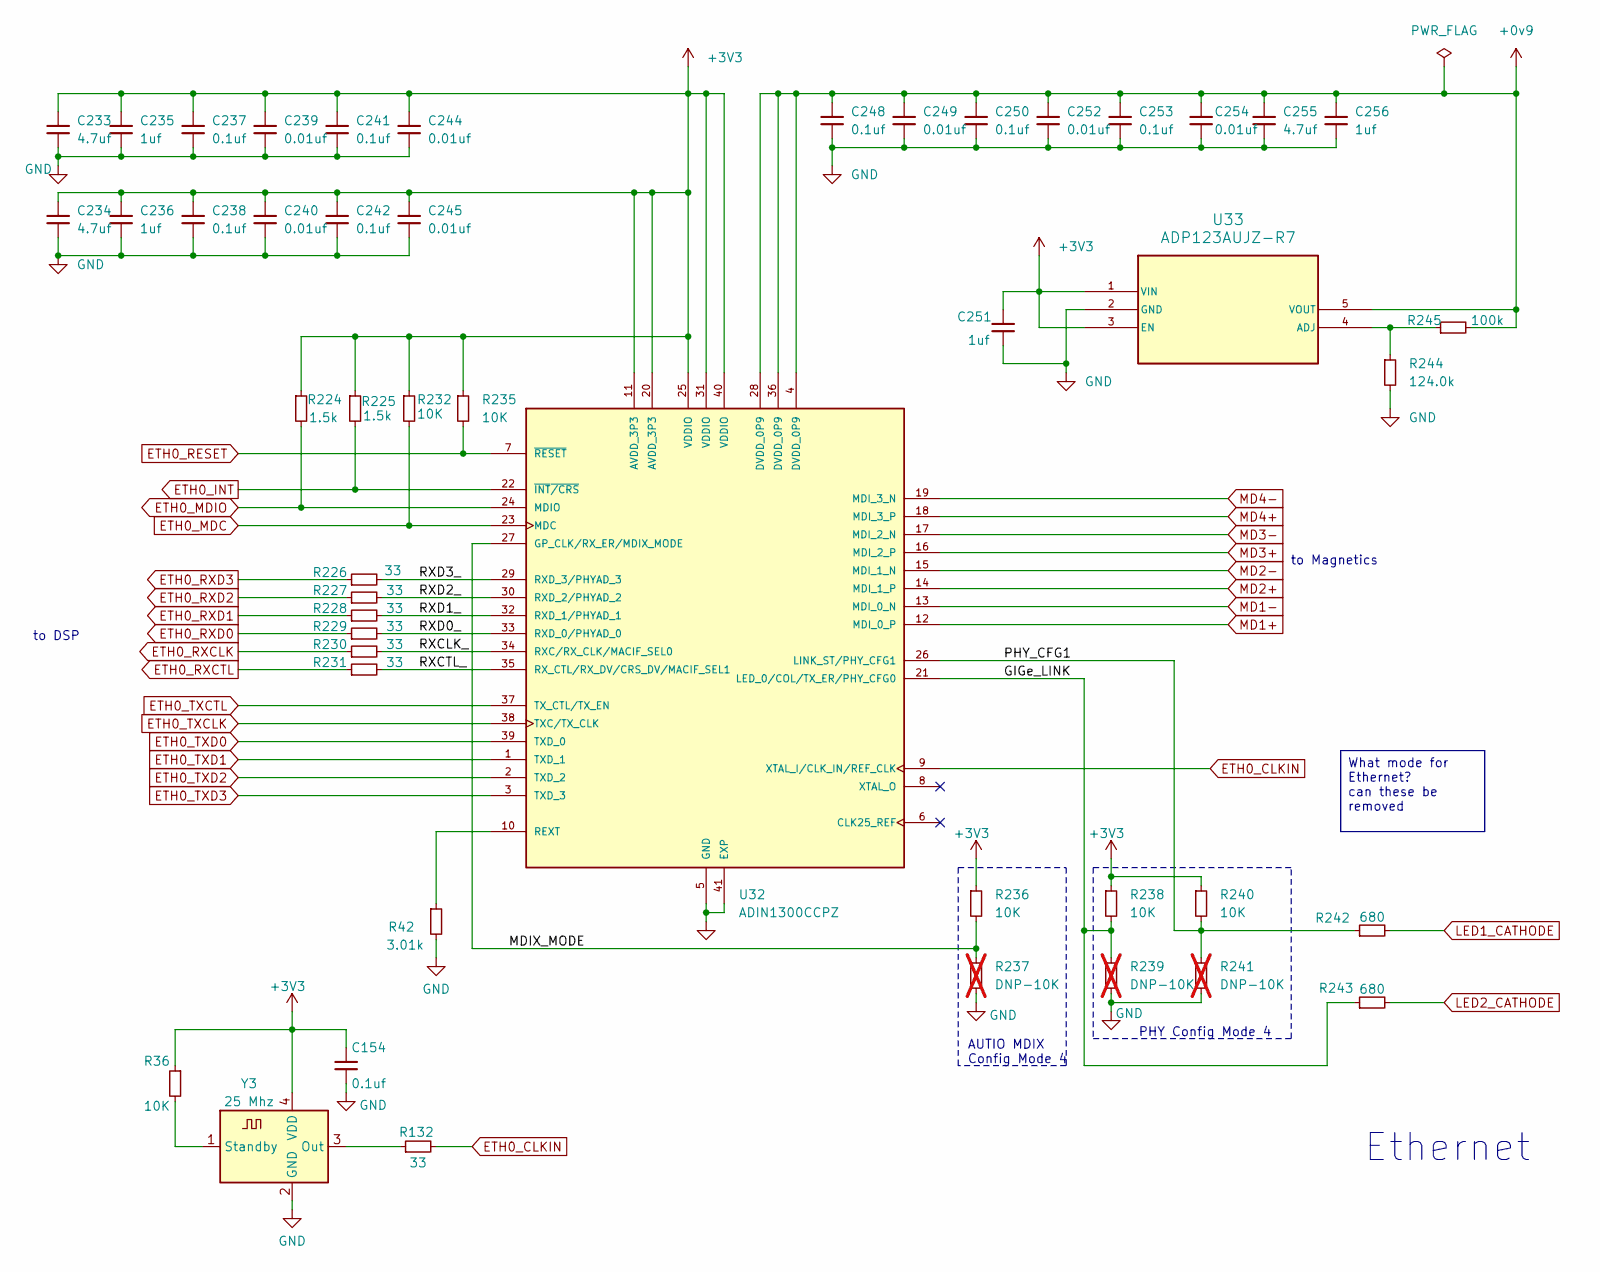
[picture p71: schematic ethernet.kicad_sch]

Parts:
C154, C237, C238, C241, C242, C248, C250, C253: 0.1uf; C_0402_1005Metric; Rating 50V; Part Number 04025C104KAT2A
C233, C234, C255: 4.7uf; C_0805_2012Metric; Rating 50V; Part Number CL21A475KBQNNNE
C235, C236, C251, C256: 1uf; C_0603_1608Metric; Rating 50V; Part Number 06035C105KAT2A
C239, C240, C244, C245, C249, C252, C254: 0.01uf; C_0402_1005Metric; Rating 50V; Part Number 04025C103KAT2A
R36, R232, R235, R236, R238, R240: 10K; R_0402_1005Metric; Part Number RMCF0402FT10K0
R42: 3.01k; R_0402_1005Metric; Part Number RMCF0402FT3K01
R132, R226, R227, R228, R229, R230, R231: 33; R_0402_1005Metric; Part Number RMCF0402FT33R0
R224, R225: 1.5k; R_0402_1005Metric; Part Number RMCF0402FT1K50
R237, R239, R241: DNP-10K; R_0402_1005Metric; Part Number RMCF0402FT10K0; not fitted
R242, R243: 680; R_0402_1005Metric; Part Number RMCF0402FT680R
R244: 124.0k; R_0402_1005Metric; Part Number RMCF0402FT124K
R245: 100k; R_0402_1005Metric; Part Number RMCF0402FT100K
U32: ADIN1300CCPZ; QFN50P600X600X80-41N; PARTREV 0
U33: ADP123AUJZ-R7; UJ-5_ADI; Part Number ADP123AUJZ-R7
Y3: 25 Mhz; OSC_4SMD_2.5MM_2.0MM; Part Number ECS-2520S33-250-FN-TR

Connections:
+0v9: C248.1, C249.1, C250.1, C252.1, C253.1, C254.1, C255.1, C256.1, R245.2, U32.4 (DVDD_0P9), U32.28 (DVDD_0P9), U32.36 (DVDD_0P9), U33.5 (VOUT)
+3V3: C154.1, C233.1, C234.1, C235.1, C236.1, C237.1, C238.1, C239.1, C240.1, C241.1, C242.1, C244.1, C245.1, C251.1, R36.1, R224.1, R225.1, R232.1, R235.1, R236.1, R238.1, R240.1, U32.11 (AVDD_3P3), U32.20 (AVDD_3P3), U32.25 (VDDIO), U32.31 (VDDIO), U32.40 (VDDIO), U33.1 (VIN), U33.3 (EN), Y3.4 (VDD); also elsewhere on the board
/Ethernet/GIGe_LINK: R238.2, R239.1, R243.1, U32.21 (LED_0/COL/TX_ER/PHY_CFG0)
/Ethernet/MDIX_MODE: R236.2, R237.1, U32.27 (GP_CLK/RX_ER/MDIX_MODE)
/Ethernet/PHY_CFG1: R240.2, R241.1, R242.1, U32.26 (LINK_ST/PHY_CFG1)
/Ethernet/RXCLK_: R230.2, U32.34 (RXC/RX_CLK/MACIF_SEL0)
/Ethernet/RXCTL_: R231.2, U32.35 (RX_CTL/RX_DV/CRS_DV/MACIF_SEL1)
/Ethernet/RXD0_: R229.2, U32.33 (RXD_0/PHYAD_0)
/Ethernet/RXD1_: R228.2, U32.32 (RXD_1/PHYAD_1)
/Ethernet/RXD2_: R227.2, U32.30 (RXD_2/PHYAD_2)
/Ethernet/RXD3_: R226.2, U32.29 (RXD_3/PHYAD_3)
ETH0_CLKIN: R132.2, U32.9 (XTAL_I/CLK_IN/REF_CLK); also elsewhere on the board
ETH0_INT: R225.2, U32.22 (~INT~/CRS); also elsewhere on the board
ETH0_MDC: R232.2, U32.23 (MDC); also elsewhere on the board
ETH0_MDIO: R224.2, U32.24 (MDIO); also elsewhere on the board
ETH0_RESET: R235.2, U32.7 (~RESET); also elsewhere on the board
ETH0_RXCLK: R230.1; also elsewhere on the board
ETH0_RXCTL: R231.1; also elsewhere on the board
ETH0_RXD0: R229.1; also elsewhere on the board
ETH0_RXD1: R228.1; also elsewhere on the board
ETH0_RXD2: R227.1; also elsewhere on the board
ETH0_RXD3: R226.1; also elsewhere on the board
ETH0_TXCLK: U32.38 (TXC/TX_CLK); also elsewhere on the board
ETH0_TXCTL: U32.37 (TX_CTL/TX_EN); also elsewhere on the board
ETH0_TXD0: U32.39 (TXD_0); also elsewhere on the board
ETH0_TXD1: U32.1 (TXD_1); also elsewhere on the board
ETH0_TXD2: U32.2 (TXD_2); also elsewhere on the board
ETH0_TXD3: U32.3 (TXD_3); also elsewhere on the board
GND: C154.2, C233.2, C234.2, C235.2, C236.2, C237.2, C238.2, C239.2, C240.2, C241.2, C242.2, C244.2, C245.2, C248.2, C249.2, C250.2, C251.2, C252.2, C253.2, C254.2, C255.2, C256.2, R42.2, R237.2, R239.2, R241.2, R244.2, U32.5 (GND), U32.41 (EXP), U33.2 (GND), Y3.2 (GND); also elsewhere on the board
LED1_CATHODE: R242.2; also elsewhere on the board
LED2_CATHODE: R243.2; also elsewhere on the board
MD1+: U32.12 (MDI_0_P); also elsewhere on the board
MD1-: U32.13 (MDI_0_N); also elsewhere on the board
MD2+: U32.14 (MDI_1_P); also elsewhere on the board
MD2-: U32.15 (MDI_1_N); also elsewhere on the board
MD3+: U32.16 (MDI_2_P); also elsewhere on the board
MD3-: U32.17 (MDI_2_N); also elsewhere on the board
MD4+: U32.18 (MDI_3_P); also elsewhere on the board
MD4-: U32.19 (MDI_3_N); also elsewhere on the board
unnamed: R42.1, U32.10 (REXT)
unnamed: R244.1, R245.1, U33.4 (ADJ)
unnamed: R132.1, Y3.3 (Out)
unnamed: R36.2, Y3.1 (Standby)

Notes on the sheet:
to Magnetics
to DSP
PHY Config Mode 4
Ethernet
AUTIO MDIX Config Mode 4
What mode for Ethernet? can these be removed

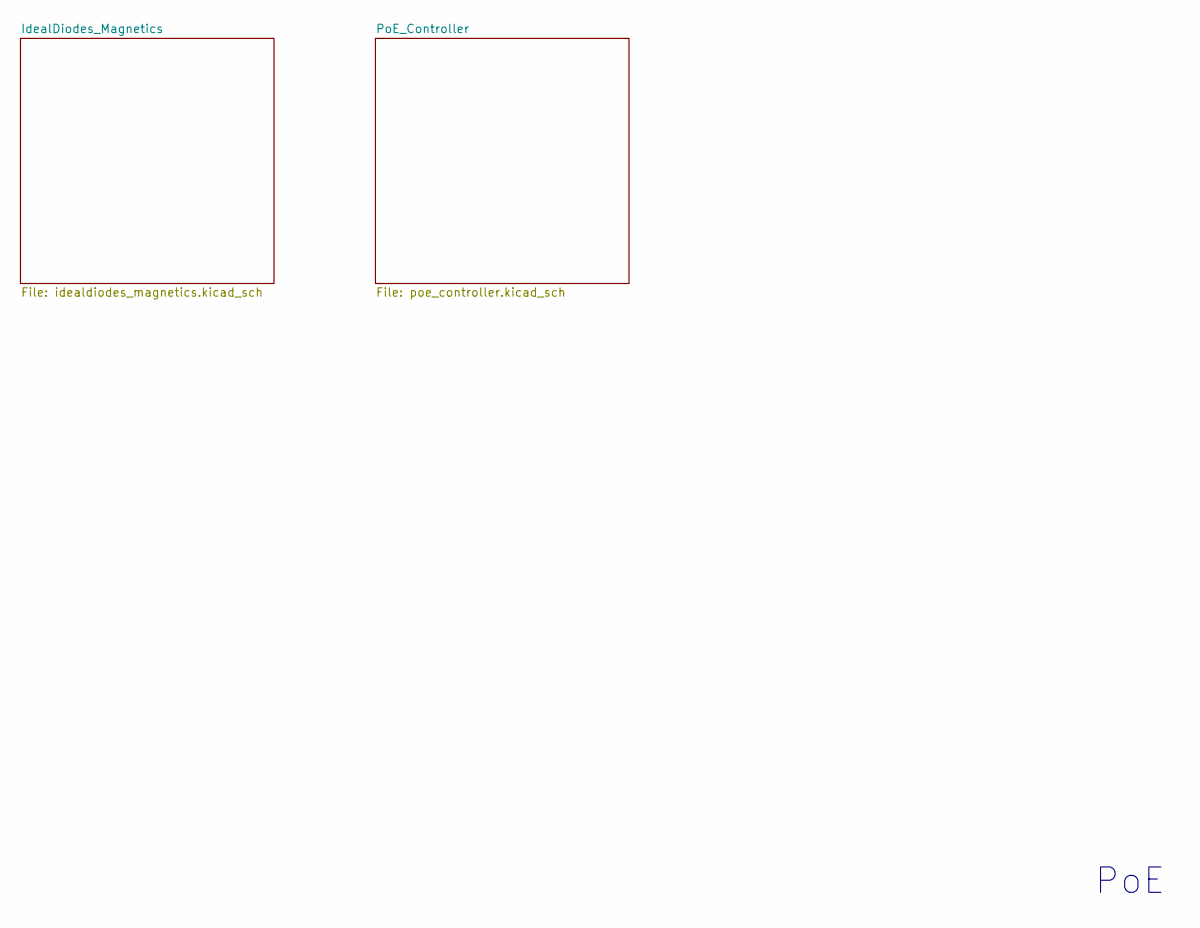
[picture p72: schematic poe.kicad_sch]

Notes on the sheet:
PoE

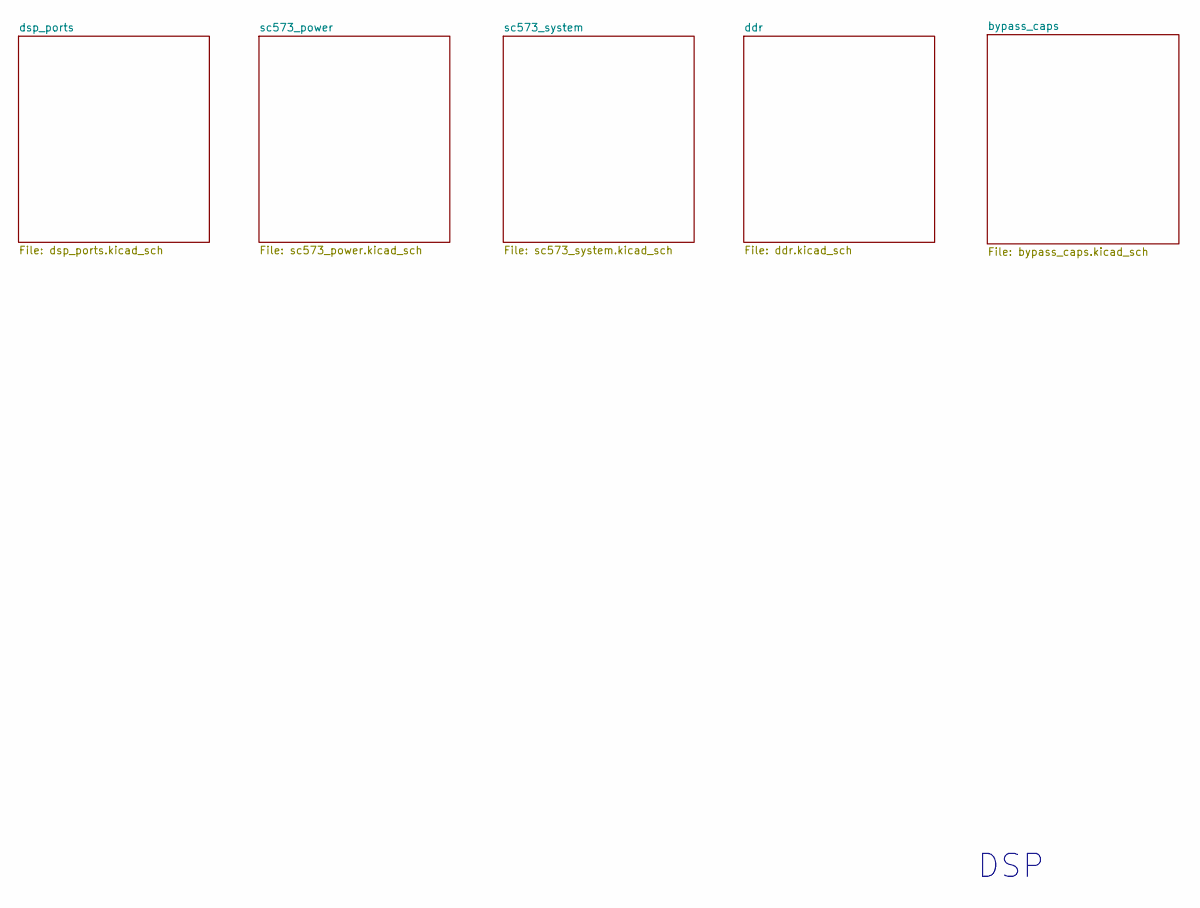
[picture p73: schematic sc573.kicad_sch]

Notes on the sheet:
DSP

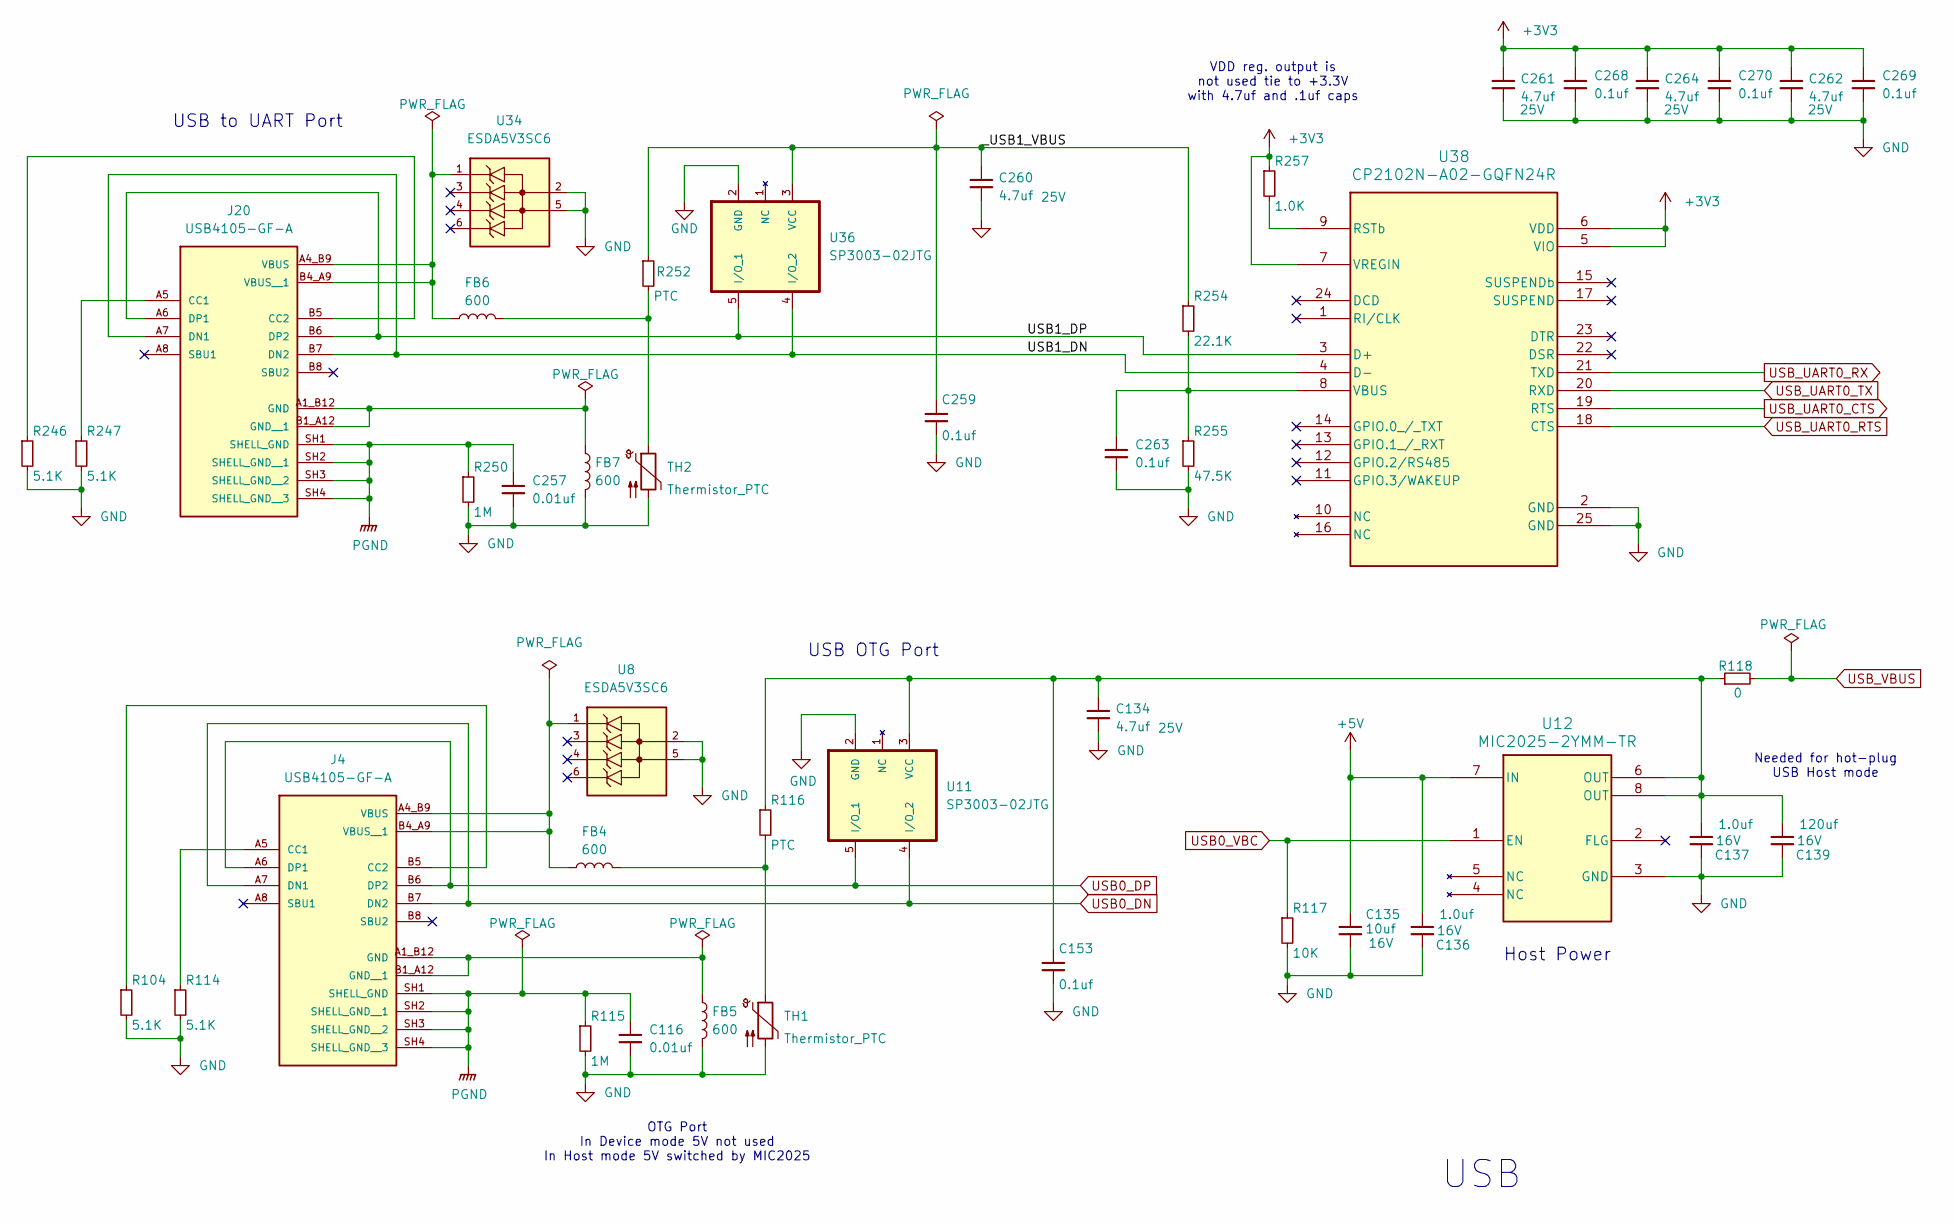
[picture p74: schematic usb.kicad_sch]

Parts:
C116, C257: 0.01uf; C_0402_1005Metric; Rating 50V; Part Number 04025C103KAT2A
C134, C260, C261, C262, C264: 4.7uf; C_0603_1608Metric; Rating 25V; Part Number CL10A475MA8NQNC
C135: 10uf; C_0805_2012Metric; Voltage 16V; Rating 16V; Part Number EMK212BJ106KG-T
C136, C137: 1.0uf; C_0402_1005Metric; Voltage 16V; Rating 16V; Part Number EMK105BJ105KV-F
C139: 120uf; CAP_X-7343-43_KEM; Voltage 16V; Rating 10V; Part Number A700X127M010ATE010
C153, C259, C263, C268, C269, C270: 0.1uf; C_0402_1005Metric; Rating 50V; Part Number 04025C104KAT2A
FB4, FB5, FB6, FB7: 600; L_0603_1608Metric_Pad1.05x0.95mm_HandSolder; Part Number 742863160
J4, J20: USB4105-GF-A; GCT_USB4105-GF-A; PARTREV B4
R104, R114, R246, R247: 5.1K; R_0402_1005Metric; Part Number RMCF0402FT5K10
R115, R250: 1M; R_0402_1005Metric; Part Number RMCF0402FT1M00
R116, R252: PTC; R_0603_1608Metric; Part Number 0603L050YR
R117: 10K; R_0402_1005Metric; Part Number RMCF0402FT10K0
R118: 0; R_0805_2012Metric; Part Number RMCF0805ZT0R00
R254: 22.1K; R_0402_1005Metric; Part Number RMCF0402FT22K1
R255: 47.5K; R_0402_1005Metric; Part Number RMCF0402FT47K5
R257: 1.0K; R_0402_1005Metric; Rating 1/16 W; Part Number RMCF0402FT1K00
TH1, TH2: Thermistor_PTC; R_0603_1608Metric_Pad0.98x0.95mm_HandSolder; Part Number V5.5MLA0603NH
U8, U34: ESDA5V3SC6; SOT23-6L; Part Number ESDA5V3SC6
U11, U36: SP3003-02JTG; SOT65P220X110-5N; MPN SP3003-02JTG
U12: MIC2025-2YMM-TR; MSOP-8_MM_MCH; Part Number MIC2025-2YMM-TR
U38: CP2102N-A02-GQFN24R; QFN24_SIL-M; Part Number CP2102N-A02-GQFN24R

Connections:
+3V3: C261.1, C262.1, C264.1, C268.1, C269.1, C270.1, R257.1, U38.5 (VIO), U38.6 (VDD), U38.7 (VREGIN); also elsewhere on the board
+5V: C135.1, C136.2, U12.7 (IN); also elsewhere on the board
/usb/USB1_DN: J20.A7 (DN1), J20.B7 (DN2), U36.4 (I/O_2), U38.4 (D-)
/usb/USB1_DP: J20.A6 (DP1), J20.B6 (DP2), U36.5 (I/O_1), U38.3 (D+)
/usb/_USB1_VBUS: C259.1, C260.1, R252.1, R254.1, U36.3 (VCC)
GND: C116.2, C134.2, C135.2, C136.1, C137.1, C139.1, C153.2, C257.2, C259.2, C260.2, C261.2, C262.2, C263.2, C264.2, C268.2, C269.2, C270.2, FB5.2, FB7.2, R104.2, R114.2, R115.2, R117.2, R246.2, R247.2, R250.2, R255.2, TH1.2, TH2.2, U8.2, U8.5, U11.2 (GND), U12.3 (GND), U34.2, U34.5, U36.2 (GND), U38.2 (GND), U38.25 (GND); also elsewhere on the board
unnamed: FB4.2, R116.2, TH1.1
unnamed: FB6.2, R252.2, TH2.1
unnamed: J4.A5 (CC1), R114.1
unnamed: J4.B5 (CC2), R104.1
unnamed: FB5.1, J4.A1_B12 (GND), J4.B1_A12 (GND__1)
unnamed: FB4.1, J4.A4_B9 (VBUS), J4.B4_A9 (VBUS__1), U8.1
unnamed: J20.A5 (CC1), R247.1
unnamed: J20.B5 (CC2), R246.1
unnamed: FB7.1, J20.A1_B12 (GND), J20.B1_A12 (GND__1)
unnamed: FB6.1, J20.A4_B9 (VBUS), J20.B4_A9 (VBUS__1), U34.1
unnamed: C134.1, C137.2, C139.2, C153.1, R116.1, R118.1, U11.3 (VCC), U12.6 (OUT), U12.8 (OUT)
unnamed: R257.2, U38.9 (RSTb)
unnamed: C263.1, R254.2, R255.1, U38.8 (VBUS)
PGND: C116.1, C257.1, J4.SH1 (SHELL_GND), J4.SH2 (SHELL_GND__1), J4.SH3 (SHELL_GND__2), J4.SH4 (SHELL_GND__3), J20.SH1 (SHELL_GND), J20.SH2 (SHELL_GND__1), J20.SH3 (SHELL_GND__2), J20.SH4 (SHELL_GND__3), R115.1, R250.1; also elsewhere on the board
USB0_DN: J4.A7 (DN1), J4.B7 (DN2), U11.4 (I/O_2); also elsewhere on the board
USB0_DP: J4.A6 (DP1), J4.B6 (DP2), U11.5 (I/O_1); also elsewhere on the board
USB0_VBC: R117.1, U12.1 (EN); also elsewhere on the board
USB_UART0_CTS: U38.19 (RTS); also elsewhere on the board
USB_UART0_RTS: U38.18 (CTS); also elsewhere on the board
USB_UART0_RX: U38.21 (TXD); also elsewhere on the board
USB_UART0_TX: U38.20 (RXD); also elsewhere on the board
USB_VBUS: R118.2; also elsewhere on the board

Notes on the sheet:
VDD reg. output is not used tie to +3.3V with 4.7uf and .1uf caps
USB OTG Port
USB to UART Port
Host Power
USB
OTG Port In Device mode 5V not used In Host mode 5V switched by MIC2025
Needed for hot-plug USB Host mode
