twilkers1976/Omnisensor-dsp-board/cpu_board.kicad_pcb

## KiCad design cpu_board.kicad_pcb (continued)

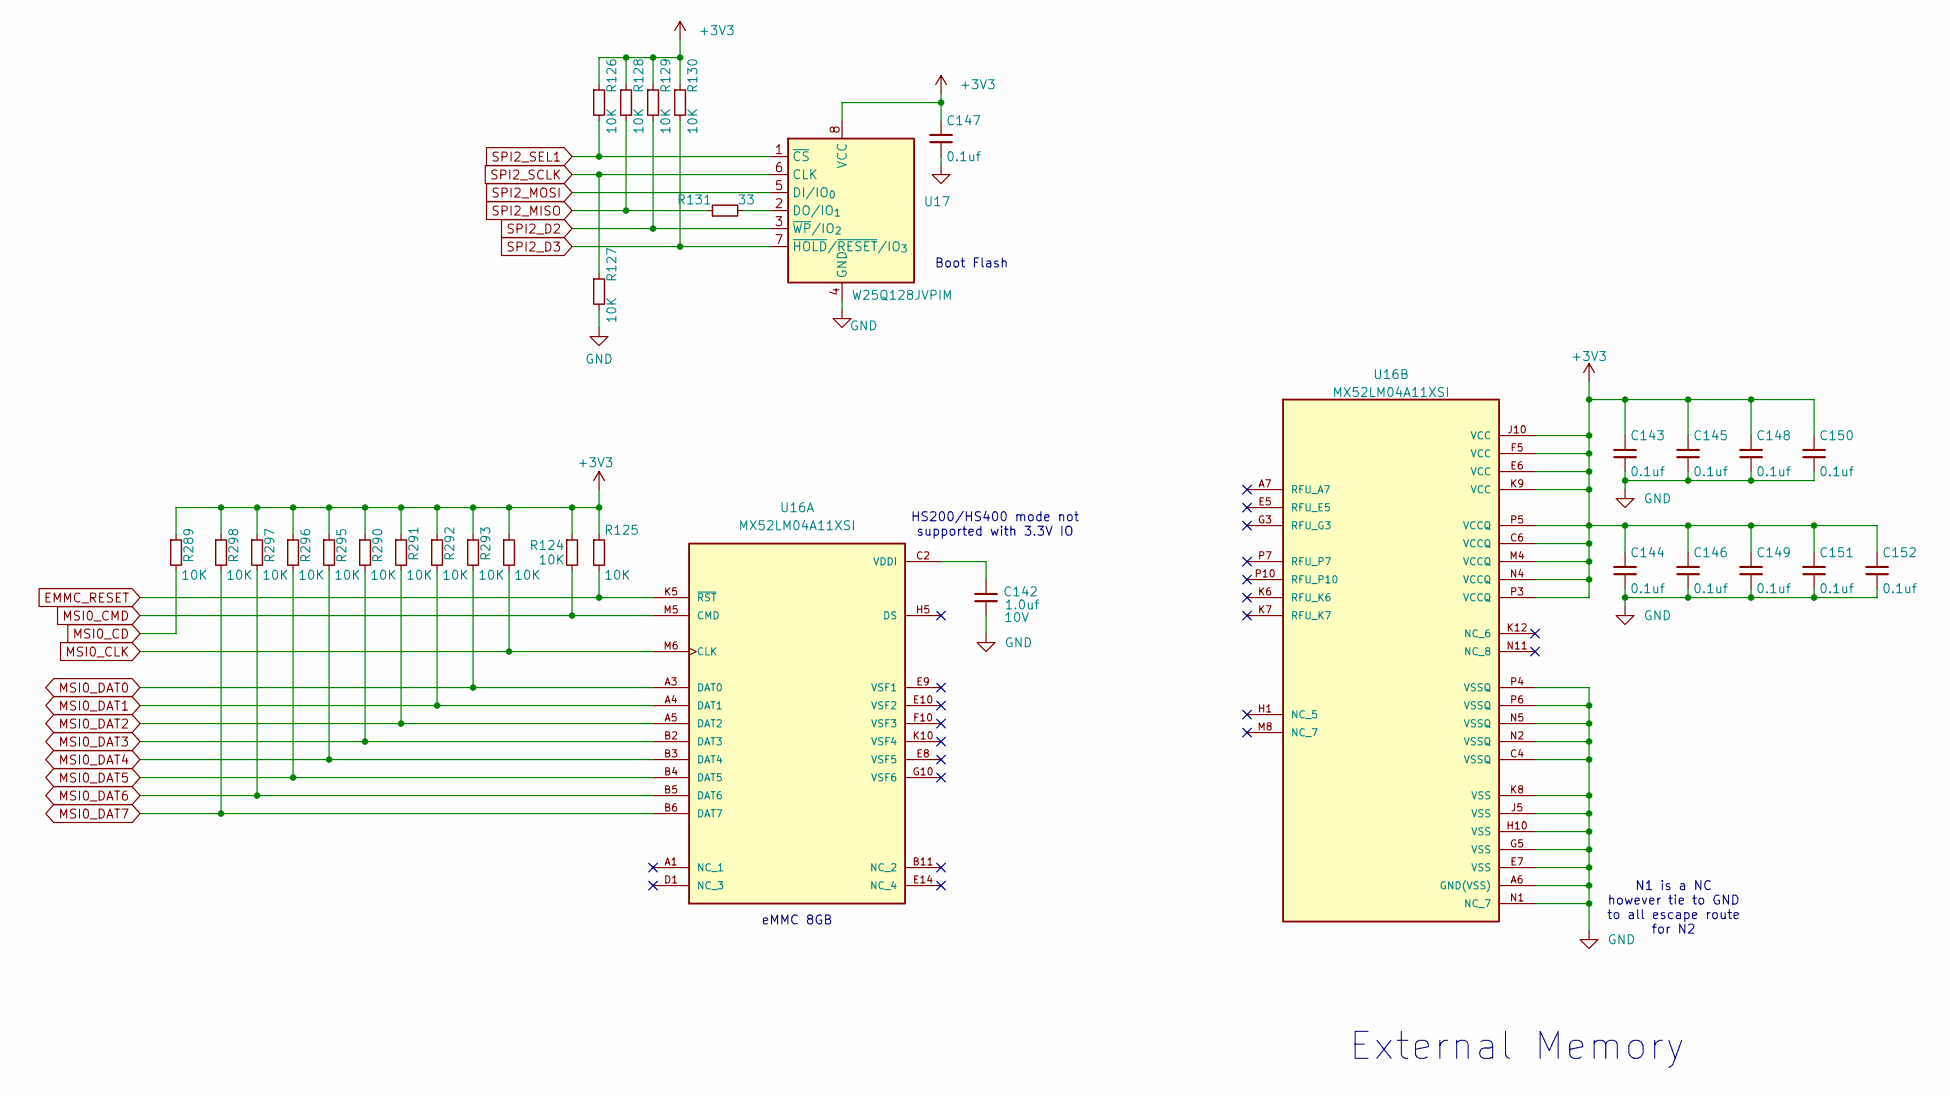
[picture p75: schematic extern_memory.kicad_sch]

Parts:
C142: 1.0uf; C_0402_1005Metric; Voltage 10V; Rating 16V; Part Number EMK105BJ105KV-F
C143, C144, C145, C146, C147, C148, C149, C150, C151, C152: 0.1uf; C_0402_1005Metric; Rating 50V; Part Number 04025C104KAT2A
R124, R125, R126, R127, R128, R129, R130, R289, R290, R291, R292, R293, R294, R295, R296, R297, R298: 10K; R_0402_1005Metric; Part Number RMCF0402FT10K0
R131: 33; R_0402_1005Metric; Part Number RMCF0402FT33R0
U16: MX52LM04A11XSI; BGA153N50P14X14_1300X1150X100N; PARTREV N/A
U17: W25Q128JVPIM; WSON-8-1EP_6x5mm_P1.27mm_EP3.4x4mm; Part Number W25Q128JVPIM

Connections:
+3V3: C143.1, C144.1, C145.1, C146.1, C147.1, C148.1, C149.1, C150.1, C151.1, C152.1, R124.1, R125.1, R126.1, R128.1, R129.1, R130.1, R289.1, R290.1, R291.1, R292.1, R293.1, R294.1, R295.1, R296.1, R297.1, R298.1, U16.C6 (VCCQ), U16.E6 (VCC), U16.F5 (VCC), U16.J10 (VCC), U16.K9 (VCC), U16.M4 (VCCQ), U16.N4 (VCCQ), U16.P3 (VCCQ), U16.P5 (VCCQ), U17.8 (VCC); also elsewhere on the board
EMMC_RESET: R125.2, U16.K5 (~RST); also elsewhere on the board
GND: C142.2, C143.2, C144.2, C145.2, C146.2, C147.2, C148.2, C149.2, C150.2, C151.2, C152.2, R127.2, U16.A6 (GND(VSS)), U16.C4 (VSSQ), U16.E7 (VSS), U16.G5 (VSS), U16.H10 (VSS), U16.J5 (VSS), U16.K8 (VSS), U16.N1 (NC_7), U16.N2 (VSSQ), U16.N5 (VSSQ), U16.P4 (VSSQ), U16.P6 (VSSQ), U17.4 (GND); also elsewhere on the board
MSI0_CD: R289.2; also elsewhere on the board
MSI0_CLK: R294.2, U16.M6 (CLK); also elsewhere on the board
MSI0_CMD: R124.2, U16.M5 (CMD); also elsewhere on the board
MSI0_DAT0: R293.2, U16.A3 (DAT0); also elsewhere on the board
MSI0_DAT1: R292.2, U16.A4 (DAT1); also elsewhere on the board
MSI0_DAT2: R291.2, U16.A5 (DAT2); also elsewhere on the board
MSI0_DAT3: R290.2, U16.B2 (DAT3); also elsewhere on the board
MSI0_DAT4: R295.2, U16.B3 (DAT4); also elsewhere on the board
MSI0_DAT5: R296.2, U16.B4 (DAT5); also elsewhere on the board
MSI0_DAT6: R297.2, U16.B5 (DAT6); also elsewhere on the board
MSI0_DAT7: R298.2, U16.B6 (DAT7); also elsewhere on the board
unnamed: C142.1, U16.C2 (VDDI)
unnamed: R131.2, U17.2 (DO/IO_{1})
SPI2_D2: R129.2, U17.3 (~WP/IO_{2}); also elsewhere on the board
SPI2_D3: R130.2, U17.7 (~HOLD/~RESET/IO_{3}); also elsewhere on the board
SPI2_MISO: R128.2, R131.1; also elsewhere on the board
SPI2_MOSI: U17.5 (DI/IO_{0}); also elsewhere on the board
SPI2_SCLK: R127.1, U17.6 (CLK); also elsewhere on the board
SPI2_SEL1: R126.2, U17.1 (~CS); also elsewhere on the board

Notes on the sheet:
External Memory
eMMC 8GB
HS200/HS400 mode not supported with 3.3V IO
Boot Flash
N1 is a NC however tie to GND to all escape route for N2

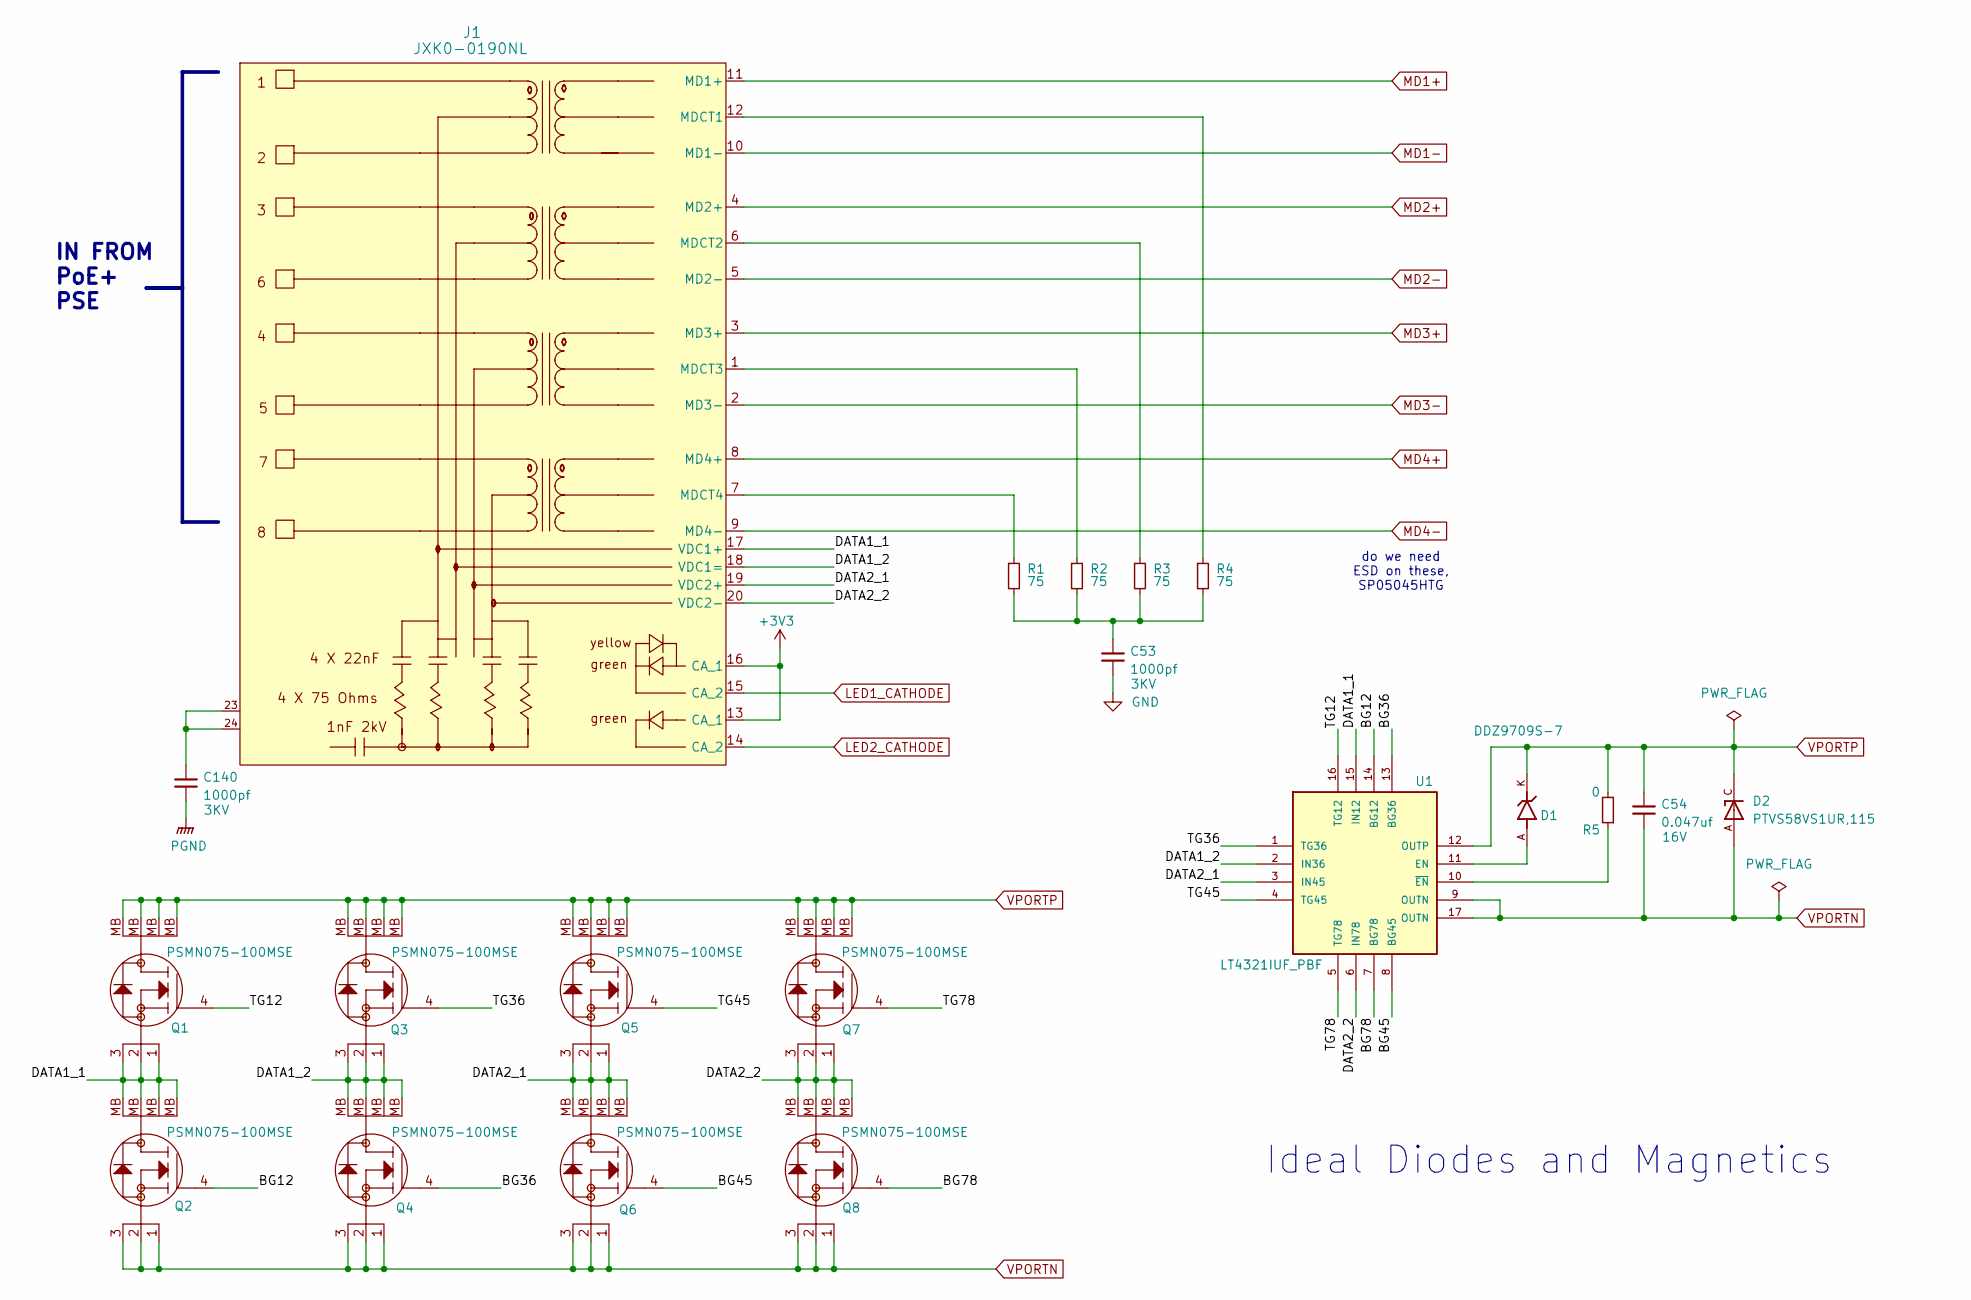
[picture p76: schematic idealdiodes_magnetics.kicad_sch]

Parts:
C53, C140: 1000pf; C_1808_4520Metric; Voltage 3KV; Rating 3KV; Part Number CHV1808N3K0102MXT
C54: 0.047uf; C_0603_1608Metric; Voltage 16V; Rating 16V; Part Number CL10B473KO8NNNC
D1: DDZ9709S-7; Rating 24V; PARTREV 13 - 2
D2: PTVS58VS1UR,115; TVS_PTVS58VS1UR; PARTREV Rev. 3
J1: JXK0-0190NL; JK0-0177NL_PUL; Part Number JXK0-0190NL
Q1, Q2, Q3, Q4, Q5, Q6, Q7, Q8: PSMN075-100MSE; TRANS_PSMN075-100MSE; PARTREV 24 July 2024
R1, R2, R3, R4: 75; R_0603_1608Metric; Part Number RN73H1JTTD75R0F100
R5: 0; R_0402_1005Metric; Part Number RMCF0402ZT0R00
U1: LT4321IUF_PBF; PARTREV 0

Connections:
+3V3: J1.13 (CA_1), J1.16 (CA_1); also elsewhere on the board
/PoE/IdealDiodes_Magnetics/BG12: Q2.4, U1.14 (BG12)
/PoE/IdealDiodes_Magnetics/BG36: Q4.4, U1.13 (BG36)
/PoE/IdealDiodes_Magnetics/BG45: Q6.4, U1.8 (BG45)
/PoE/IdealDiodes_Magnetics/BG78: Q8.4, U1.7 (BG78)
/PoE/IdealDiodes_Magnetics/DATA1_1: J1.17 (VDC1+), Q1.1, Q1.2, Q1.3, Q2.MB, U1.15 (IN12)
/PoE/IdealDiodes_Magnetics/DATA1_2: J1.18 (VDC1=), Q3.1, Q3.2, Q3.3, Q4.MB, U1.2 (IN36)
/PoE/IdealDiodes_Magnetics/DATA2_1: J1.19 (VDC2+), Q5.1, Q5.2, Q5.3, Q6.MB, U1.3 (IN45)
/PoE/IdealDiodes_Magnetics/DATA2_2: J1.20 (VDC2-), Q7.1, Q7.2, Q7.3, Q8.MB, U1.6 (IN78)
/PoE/IdealDiodes_Magnetics/TG12: Q1.4, U1.16 (TG12)
/PoE/IdealDiodes_Magnetics/TG36: Q3.4, U1.1 (TG36)
/PoE/IdealDiodes_Magnetics/TG45: Q5.4, U1.4 (TG45)
/PoE/IdealDiodes_Magnetics/TG78: Q7.4, U1.5 (TG78)
GND: C53.2; also elsewhere on the board
LED1_CATHODE: J1.15 (CA_2); also elsewhere on the board
LED2_CATHODE: J1.14 (CA_2); also elsewhere on the board
MD1+: J1.11 (MD1+); also elsewhere on the board
MD1-: J1.10 (MD1-); also elsewhere on the board
MD2+: J1.4 (MD2+); also elsewhere on the board
MD2-: J1.5 (MD2-); also elsewhere on the board
MD3+: J1.3 (MD3+); also elsewhere on the board
MD3-: J1.2 (MD3-); also elsewhere on the board
MD4+: J1.8 (MD4+); also elsewhere on the board
MD4-: J1.9 (MD4-); also elsewhere on the board
unnamed: C53.1, R1.2, R2.2, R3.2, R4.2
unnamed: C140.1, J1.23, J1.24
unnamed: J1.12 (MDCT1), R4.1
unnamed: J1.6 (MDCT2), R3.1
unnamed: J1.1 (MDCT3), R2.1
unnamed: J1.7 (MDCT4), R1.1
unnamed: D1.A, U1.11 (EN)
unnamed: R5.1, U1.10 (~EN)
PGND: C140.2; also elsewhere on the board
VPORTN: C54.2, D2.A, Q2.1, Q2.2, Q2.3, Q4.1, Q4.2, Q4.3, Q6.1, Q6.2, Q6.3, Q8.1, Q8.2, Q8.3, U1.9 (OUTN), U1.17 (OUTN); also elsewhere on the board
VPORTP: C54.1, D1.K, D2.C, Q1.MB, Q3.MB, Q5.MB, Q7.MB, R5.2, U1.12 (OUTP); also elsewhere on the board

Notes on the sheet:
Ideal Diodes and Magnetics
do we need ESD on these, SP05045HTG
IN FROM PoE+ PSE

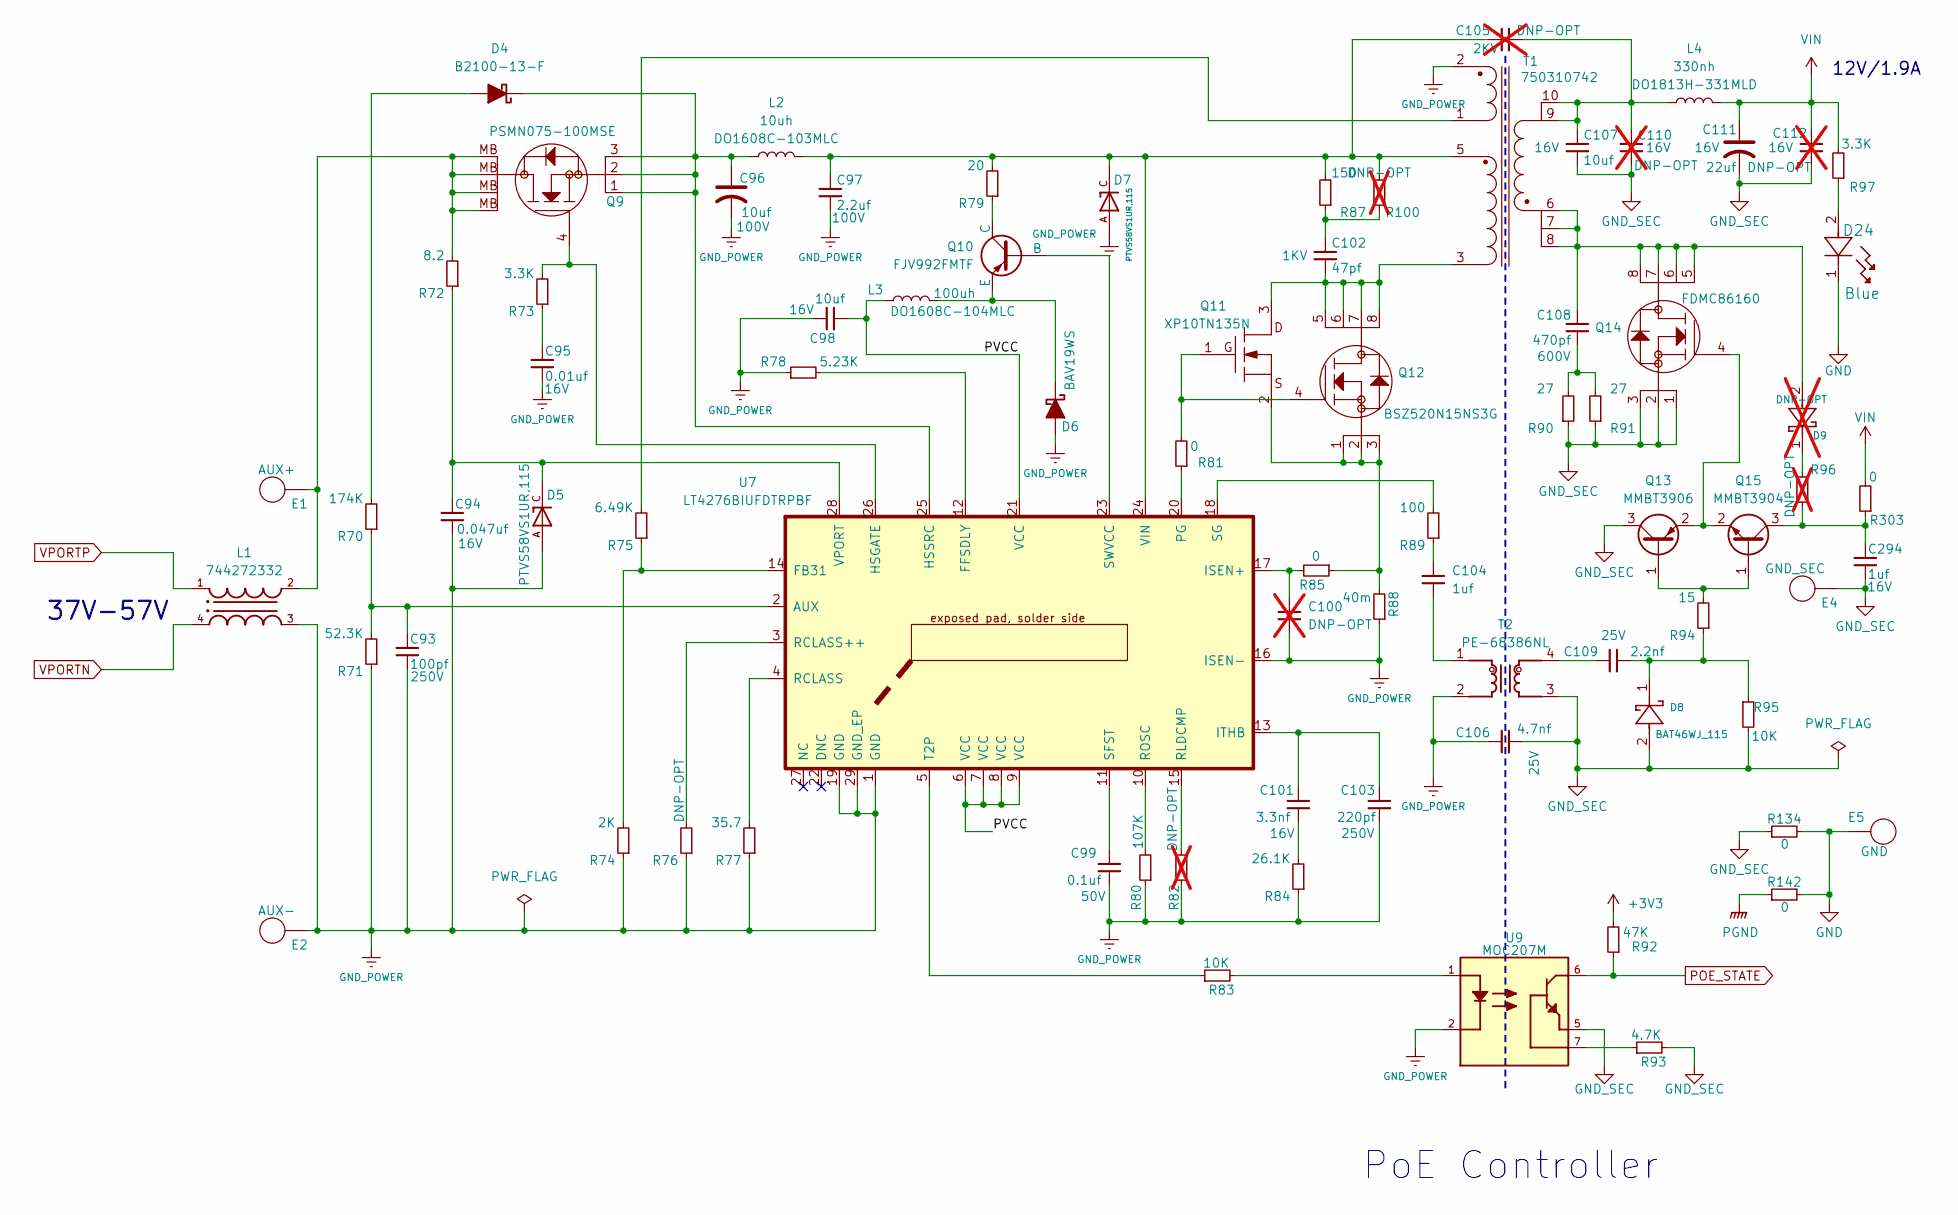
[picture p77: schematic poe_controller.kicad_sch]

Parts:
C93: 100pf; C_0603_1608Metric; Rating 250V; Part Number CHV0603N250101FCT
C94: 0.047uf; C_0805_2012Metric; Rating 16V; Part Number C0805C473F4GACTU
C95: 0.01uf; C_0603_1608Metric; Rating 16V; Part Number KGM15AR71C103KT
C96: 10uf; PNSC-FT-V-83x83-2_V; Rating 100V; Part Number PCV2A100MCL1GS
C97: 2.2uf; C_1210_3225Metric; Rating 100V; Part Number GRM32ER72A225KA35L
C98, C107: 10uf; C_1206_3216Metric; Rating 16V; Part Number C1206C106M4RACAUTO
C99: 0.1uf; C_0603_1608Metric; Rating 50V; Part Number KGM15BR71H104KT
C100: DNP-OPT; C_0402_1005Metric; not fitted
C101: 3.3nf; C_0603_1608Metric; Rating 16V; Part Number C0603C332J4GACTU
C102: 47pf; C_1206_3216Metric; Rating 1KV; Part Number CHV1206N1K0470FCT
C103: 220pf; C_0603_1608Metric; Rating 250V; Part Number CHV0603N250221GCT
C104: 1uf; C_0603_1608Metric; Rating 50V; Part Number 06035C105KAT2A
C105: DNP-OPT; C_1812_4532Metric; Rating 2KV; not fitted
C106: 4.7nf; C_1812_4532Metric; Rating 25V; Part Number 885012210005
C108: 470pf; C_1206_3216Metric; Rating 600V; Part Number GRM31A7U2J471JW31D
C109: 2.2nf; C_0603_1608Metric; Rating 25V; Part Number GRM188R72A222KA01D
C110, C112: DNP-OPT; C_1206_3216Metric; Rating 16V; Part Number C1206C106M4RACAUTO; not fitted
C111: 22uf; CAP_16SVP22M; Rating 16V; Part Number 16SVP22M
C294: 1uf; C_0805_2012Metric; Rating 16V; Part Number CL21B105KOFVPNE
D4: B2100-13-F; DIOM5336X250N; Part Number B2100-13-F
D5, D7: PTVS58VS1UR,115; TVS_PTVS58VS1UR; Part Number PTVS58VS1UR,115
D6: BAV19WS; D_SOD-323F; Part Number BAV19WS
D8: BAT46WJ_115; SOD323_V; Part Number BAT46WJ,115
D9: DNP-OPT; SOD323_V; Part Number BAT46WJ_115; not fitted
D24: Blue; LED_B1931NG_HVK; Part Number B19Y1NB--20C000113U1930
E1: AUX+; TestPoint_THTPad_D1.0mm_Drill0.5mm; PART REFERENCE E10
E2: AUX-; TestPoint_THTPad_D1.0mm_Drill0.5mm; PART REFERENCE E10
E4: GND_SEC; TestPoint_THTPad_D1.0mm_Drill0.5mm; PART REFERENCE E10
E5: GND; TestPoint_THTPad_D1.0mm_Drill0.5mm; PART REFERENCE E10
L1: 744272332; WE-SL5_BIFILAR; Part Number 744272332
L2: 10uh; IND_DO1608C_COC; Rating 1.5A; Part Number DO1608C-103MLC
L3: 100uh; IND_DO1608C_COC; Rating 500mA; Part Number DO1608C-104MLC
L4: 330nh; DO1813H; Rating 7A; Part Number DO1813H-331MLD
Q9: PSMN075-100MSE; TRANS_PSMN075-100MSE; PARTREV 24 July 2024
Q10: FJV992FMTF; SOT91P240X120-3N; Part Number FJV992FMTF
Q11: XP10TN135N; SOT95P251X112-3N; 5TH VOLTAGE 100; PART REFERENCE Q3
Q12: BSZ520N15NS3G; SON65P330X330X110-9N; Part Number BSZ520N15NS3GATMA1
Q13: MMBT3906; SOT-23; Part Number MMBT3906
Q14: FDMC86160; TRANS_FDMC86102; 5TH VOLTAGE 100V; PART REFERENCE Q2
Q15: MMBT3904; SOT-23; Part Number MMBT3904
R70: 174K; R_0603_1608Metric; Part Number RN73H1JTTD1743F100
R71: 52.3K; R_0603_1608Metric; Part Number CPF0603F52K3C1
R72: 8.2; R_0805_2012Metric; Rating 1/4 Watt; Part Number CRCW08058R20FKEA
R73: 3.3K; R_0603_1608Metric; Rating 1/10 Watt; Part Number MCT06030C3301FP500
R74: 2K; R_0603_1608Metric; Rating 1/10 W; Part Number RN73H1JTTD2001F100
R75: 6.49K; R_0603_1608Metric; Rating 1/10 W; Part Number RN73H1JTTD6491F100
R76: DNP-OPT; R_0603_1608Metric; Rating 1/10 W; Part Number RN73H1JTTD1001F100
R77: 35.7; R_0805_2012Metric; Rating 1/4 W; Part Number CRCW080535R7FKEA
R78: 5.23K; R_0603_1608Metric; Rating 1/10 W; Part Number RN73H1JTTD5231F100
R79: 20; R_0805_2012Metric; Rating 1/4 Watt; Part Number CRCW080520R0FKEA
R80: 107K; R_0603_1608Metric; Rating 1/4 W; Part Number RN73H1JTTD1073F100
R81, R85: 0; R_0402_1005Metric; Part Number RMCF0402ZT0R00
R82: DNP-OPT; R_0603_1608Metric; Rating 1/4 W; not fitted
R83: 10K; R_0402_1005Metric; Part Number RMCF0402FT10K0
R84: 26.1K; R_0603_1608Metric; Part Number RT0603BRD0726K1L
R87: 150; R_1206_3216Metric; Rating 1/4 W; Part Number RK73H2BTTD1500F
R88: 40m; R_0603_1608Metric; Rating 1/10 W; Part Number PE0603FRF070R04L
R89: 100; R_0603_1608Metric; Rating 1/10 W; Part Number RN73H1JTTD1000F100
R90, R91: 27; R_1206_3216Metric; Rating 1/4 W; Part Number CRCW120627R0FKEAC
R92: 47K; R_0603_1608Metric; Rating 1/10 W; Part Number RN73H1JTTD4702F100
R93: 4.7K; R_0603_1608Metric; Rating 1/10 W; Part Number RN73H1JTTD4701F100
R94: 15; R_0603_1608Metric; Rating 1/10 W; Part Number RN73H1JTTD15R0F100
R95: 10K; R_0603_1608Metric; Rating 1/10W; Part Number RN73H1JTTD1002F100
R96: DNP-OPT; R_0805_2012Metric; Rating 1/4 W; not fitted
R97: 3.3K; R_0402_1005Metric; Rating 1/10 W; Part Number RMCF0402FT3K30
R100: DNP-OPT; R_1206_3216Metric; Rating 1/4 W; not fitted
R134, R142: 0; R_1210_3225Metric; Part Number RMCF1210ZT0R00
R303: 0; R_0805_2012Metric; Part Number RMCF0805ZT0R00
T1: 750310742; WE-POE__EP13_PADL1.55W1.27; Part Number 750310742
T2: PE-68386NL; PE-68386NL_PUL; Part Number PE-68386NL
U7: LT4276BIUFDTRPBF; QFN-28_UFD; Part Number LT4276BIUFD#TRPBF
U9: MOC207M; SOIC8_751DZ_ONS_OSI; Part Number MOC207M

Connections:
+3V3: R92.2; also elsewhere on the board
/PoE/PoE_Controller/PVCC: C98.1, L3.1, U7.6 (VCC), U7.7 (VCC), U7.8 (VCC), U7.9 (VCC), U7.21 (VCC)
GND: D24.1, E5.1 (A_1), R134.2, R142.2; also elsewhere on the board
GND_POWER: C93.2, C94.2, C95.2, C96.2, C97.2, C98.2, C99.2, C100.2, C103.2, C106.1, D5.A, D6.2 (A), D7.A, E2.1 (A_1), L1.3, R71.1, R74.1, R76.1, R77.1, R78.1, R80.1, R82.1, R84.1, R88.1, T1.2, T2.2, U7.1 (GND), U7.16 (ISEN-), U7.19 (GND), U7.29 (GND_EP), U9.2
GND_SEC: C106.2, C107.2, C110.2, C111.2, C112.2, C294.2, D8.2, E4.1 (A_1), Q13.3 (C), Q14.1 (S1), Q14.2 (S2), Q14.3 (S3), R90.1, R91.1, R93.2, R95.2, R134.1, T2.3, U9.5; also elsewhere on the board
unnamed: C95.1, R73.1
unnamed: C101.2, R84.2
unnamed: C102.1, R87.1, R100.1
unnamed: C104.1, R89.1
unnamed: C104.2, T2.1
unnamed: C105.2, C107.1, C110.1, L4.1, T1.9, T1.10
unnamed: C108.2, R90.2, R91.2
unnamed: C109.1, T2.4
unnamed: C109.2, D8.1, R94.1, R95.1
unnamed: D4.2 (A), R70.2
unnamed: C96.1, D4.1 (K), L2.1, Q9.1, Q9.2, Q9.3, U7.25 (HSSRC)
unnamed: D6.1 (K), L3.2, Q10.3 (E)
unnamed: D9.1, R96.1
unnamed: D24.2, R97.1
unnamed: E1.1 (A_1), L1.2, Q9.MB, R72.2
unnamed: Q10.2 (B), U7.23 (SWVCC)
unnamed: Q10.1 (C), R79.1
unnamed: C102.2, Q11.3 (DRAIN), Q12.5, Q12.6, Q12.7, Q12.8, T1.3
unnamed: Q11.1 (GATE), Q12.4, R81.2
unnamed: Q11.2 (SOURCE), Q12.1, Q12.2, Q12.3, R85.1, R88.2
unnamed: Q13.1 (B), Q15.1 (B), R94.2
unnamed: Q13.2 (E), Q14.4 (G), Q15.2 (E)
unnamed: C108.1, D9.2, Q14.5 (D1), Q14.6 (D2), Q14.7 (D3), Q14.8 (D4), T1.6, T1.7, T1.8
unnamed: C294.1, Q15.3 (C), R96.2, R303.1
unnamed: R75.2, T1.1
unnamed: R83.2, U9.1
unnamed: R93.1, U9.7
unnamed: C93.1, R70.1, R71.2, U7.2 (AUX)
unnamed: R74.2, R75.1, U7.14 (FB31)
unnamed: R78.2, U7.12 (FFSDLY)
unnamed: Q9.4, R73.2, U7.26 (HSGATE)
unnamed: C100.1, R85.2, U7.17 (ISEN+)
unnamed: C101.1, C103.1, U7.13 (ITHB)
unnamed: R81.1, U7.20 (PG)
unnamed: R77.2, U7.4 (RCLASS)
unnamed: R76.2, U7.3 (RCLASS++)
unnamed: R82.2, U7.15 (RLDCMP)
unnamed: R80.2, U7.10 (ROSC)
unnamed: C99.1, U7.11 (SFST)
unnamed: R89.2, U7.18 (SG)
unnamed: R83.1, U7.5 (T2P)
unnamed: C97.1, C105.1, D7.C, L2.2, R79.2, R87.2, R100.2, T1.5, U7.24 (VIN)
unnamed: C94.1, D5.C, R72.1, U7.28 (VPORT)
PGND: R142.1; also elsewhere on the board
POE_STATE: R92.1, U9.6; also elsewhere on the board
VIN: C111.1, C112.1, L4.2, R97.2, R303.2; also elsewhere on the board
VPORTN: L1.4; also elsewhere on the board
VPORTP: L1.1; also elsewhere on the board

Notes on the sheet:
12V/1.9A
PoE Controller
37V-57V

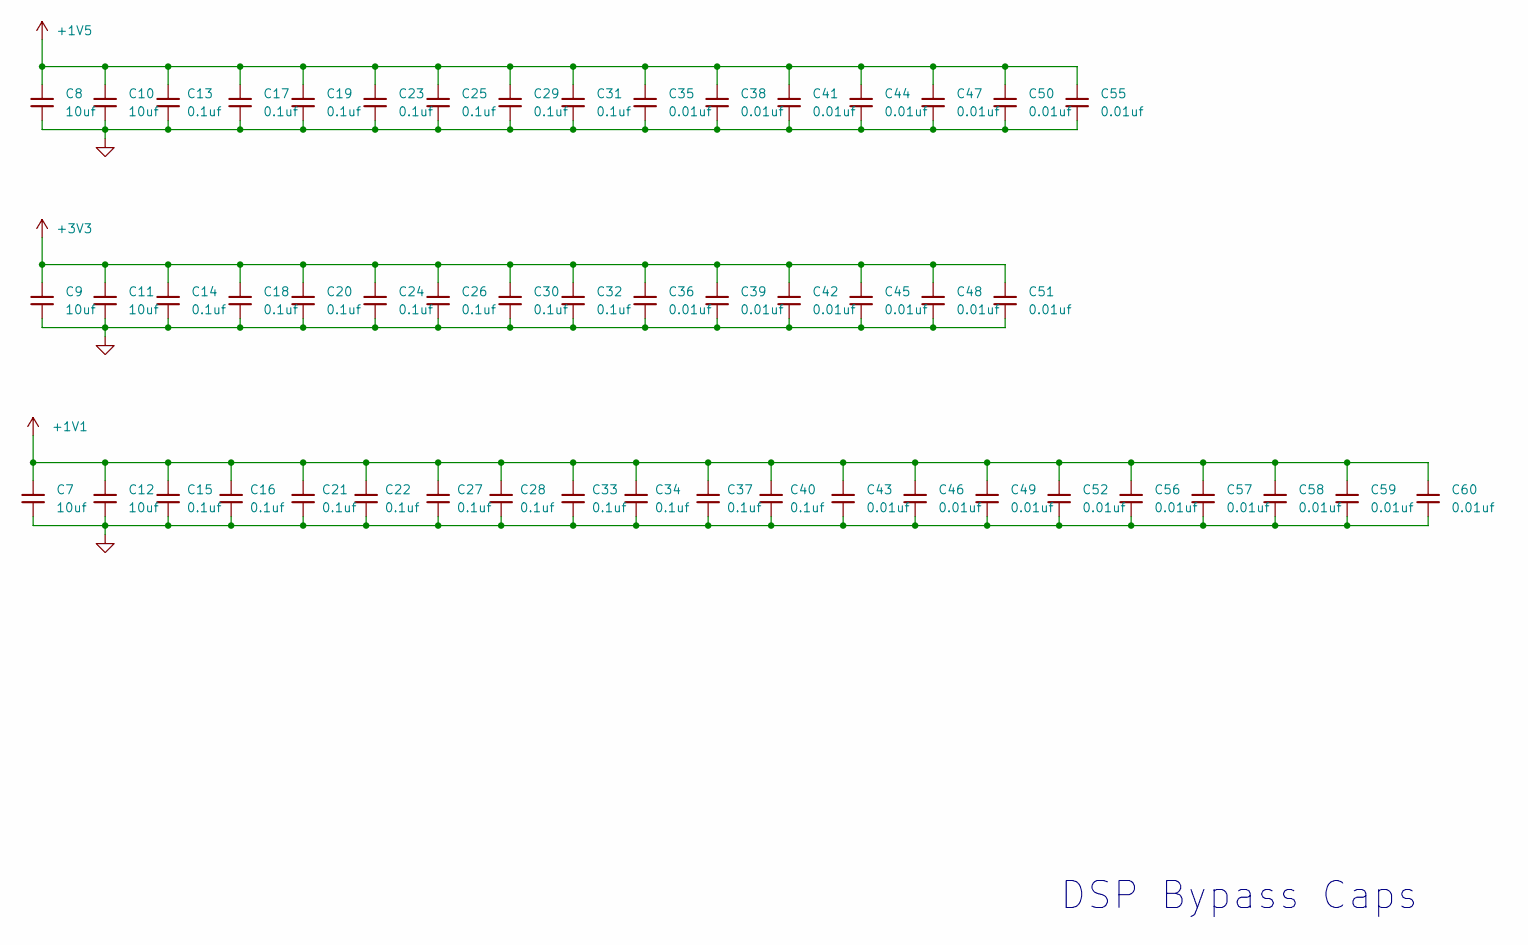
[picture p78: schematic bypass_caps.kicad_sch]

Parts:
C7, C8, C9, C10, C11, C12: 10uf; C_0805_2012Metric; Rating 16V; Part Number EMK212BJ106KG-T
C13, C14, C15, C16, C17, C18, C19, C20, C21, C22, C23, C24, C25, C26, C27, C28, C29, C30, C31, C32, C33, C34, C37, C40: 0.1uf; C_0402_1005Metric; Rating 50V; Part Number 04025C104KAT2A
C35, C36, C38, C39, C41, C42, C43, C44, C45, C46, C47, C48, C49, C50, C51, C52, C55, C56, C57, C58, C59, C60: 0.01uf; C_0402_1005Metric; Rating 50V; Part Number 04025C103KAT2A

Connections:
+1V1: C7.1, C12.1, C15.1, C16.1, C21.1, C22.1, C27.1, C28.1, C33.1, C34.1, C37.1, C40.1, C43.1, C46.1, C49.1, C52.1, C56.1, C57.1, C58.1, C59.1, C60.1; also elsewhere on the board
+1V5: C8.1, C10.1, C13.1, C17.1, C19.1, C23.1, C25.1, C29.1, C31.1, C35.1, C38.1, C41.1, C44.1, C47.1, C50.1, C55.1; also elsewhere on the board
+3V3: C9.1, C11.1, C14.1, C18.1, C20.1, C24.1, C26.1, C30.1, C32.1, C36.1, C39.1, C42.1, C45.1, C48.1, C51.1; also elsewhere on the board
GND: C7.2, C8.2, C9.2, C10.2, C11.2, C12.2, C13.2, C14.2, C15.2, C16.2, C17.2, C18.2, C19.2, C20.2, C21.2, C22.2, C23.2, C24.2, C25.2, C26.2, C27.2, C28.2, C29.2, C30.2, C31.2, C32.2, C33.2, C34.2, C35.2, C36.2, C37.2, C38.2, C39.2, C40.2, C41.2, C42.2, C43.2, C44.2, C45.2, C46.2, C47.2, C48.2, C49.2, C50.2, C51.2, C52.2, C55.2, C56.2, C57.2, C58.2, C59.2, C60.2; also elsewhere on the board

Notes on the sheet:
DSP Bypass Caps

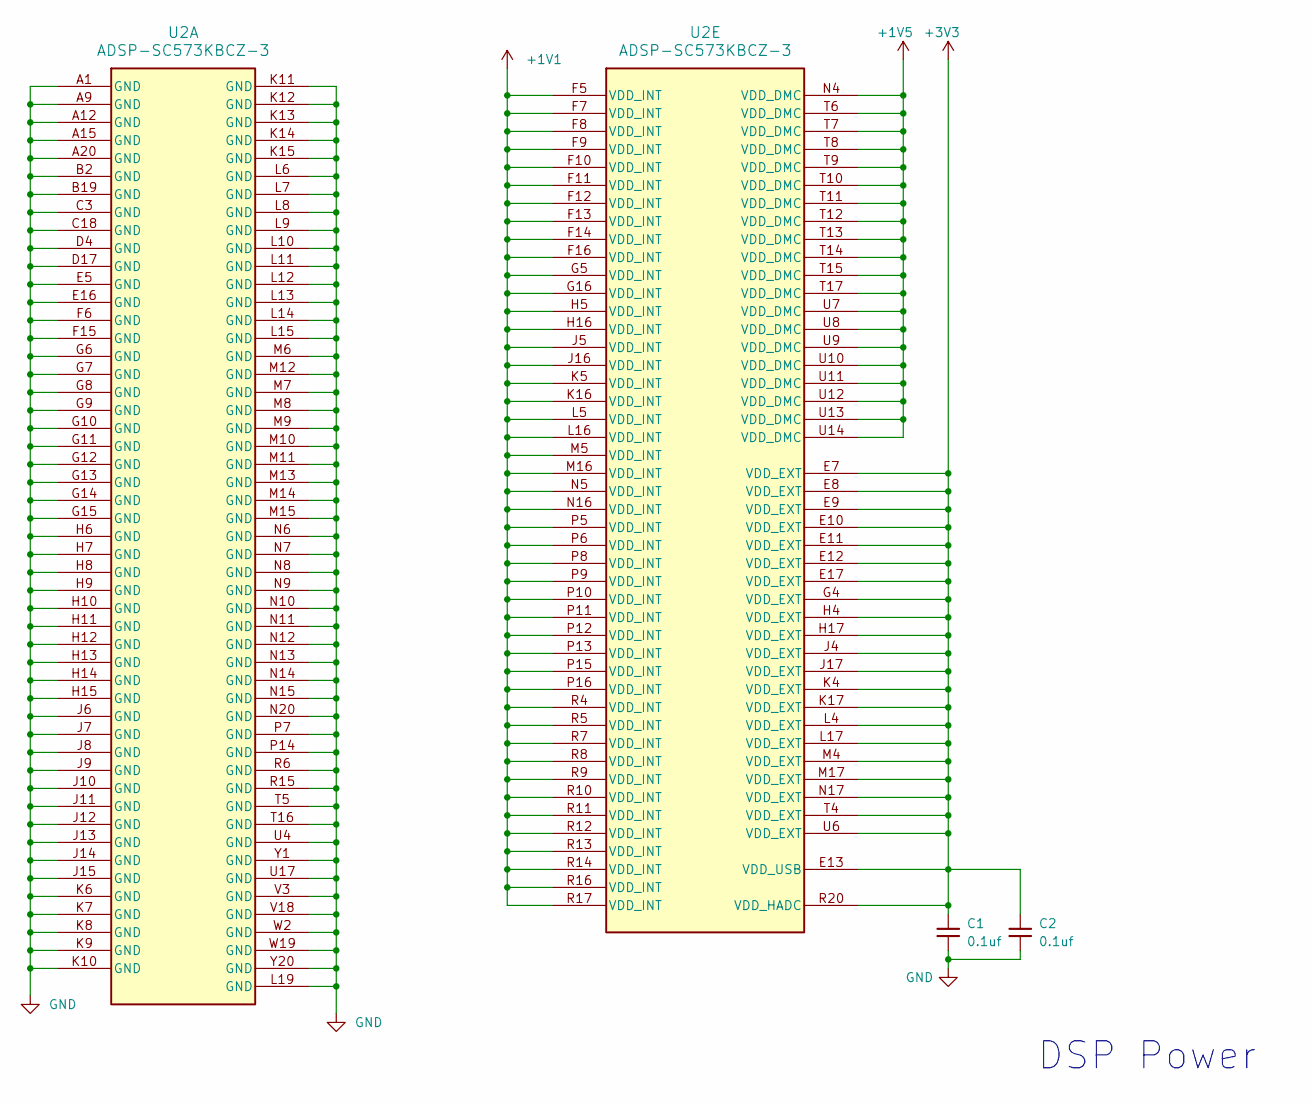
[picture p79: schematic sc573_power.kicad_sch]

Parts:
C1, C2: 0.1uf; C_0402_1005Metric; Rating 50V; Part Number 04025C104KAT2A
U2: ADSP-SC573KBCZ-3; BC-400-2_ADI; Part Number ADSP-SC573KBCZ-3

Connections:
+1V1: U2.F5 (VDD_INT), U2.F7 (VDD_INT), U2.F8 (VDD_INT), U2.F9 (VDD_INT), U2.F10 (VDD_INT), U2.F11 (VDD_INT), U2.F12 (VDD_INT), U2.F13 (VDD_INT), U2.F14 (VDD_INT), U2.F16 (VDD_INT), U2.G5 (VDD_INT), U2.G16 (VDD_INT), U2.H5 (VDD_INT), U2.H16 (VDD_INT), U2.J5 (VDD_INT), U2.J16 (VDD_INT), U2.K5 (VDD_INT), U2.K16 (VDD_INT), U2.L5 (VDD_INT), U2.L16 (VDD_INT), U2.M5 (VDD_INT), U2.M16 (VDD_INT), U2.N5 (VDD_INT), U2.N16 (VDD_INT), U2.P5 (VDD_INT), U2.P6 (VDD_INT), U2.P8 (VDD_INT), U2.P9 (VDD_INT), U2.P10 (VDD_INT), U2.P11 (VDD_INT), U2.P12 (VDD_INT), U2.P13 (VDD_INT), U2.P15 (VDD_INT), U2.P16 (VDD_INT), U2.R4 (VDD_INT), U2.R5 (VDD_INT), U2.R7 (VDD_INT), U2.R8 (VDD_INT), U2.R9 (VDD_INT), U2.R10 (VDD_INT), U2.R11 (VDD_INT), U2.R12 (VDD_INT), U2.R13 (VDD_INT), U2.R14 (VDD_INT), U2.R16 (VDD_INT), U2.R17 (VDD_INT); also elsewhere on the board
+1V5: U2.N4 (VDD_DMC), U2.T6 (VDD_DMC), U2.T7 (VDD_DMC), U2.T8 (VDD_DMC), U2.T9 (VDD_DMC), U2.T10 (VDD_DMC), U2.T11 (VDD_DMC), U2.T12 (VDD_DMC), U2.T13 (VDD_DMC), U2.T14 (VDD_DMC), U2.T15 (VDD_DMC), U2.T17 (VDD_DMC), U2.U7 (VDD_DMC), U2.U8 (VDD_DMC), U2.U9 (VDD_DMC), U2.U10 (VDD_DMC), U2.U11 (VDD_DMC), U2.U12 (VDD_DMC), U2.U13 (VDD_DMC), U2.U14 (VDD_DMC); also elsewhere on the board
+3V3: C1.1, C2.1, U2.E7 (VDD_EXT), U2.E8 (VDD_EXT), U2.E9 (VDD_EXT), U2.E10 (VDD_EXT), U2.E11 (VDD_EXT), U2.E12 (VDD_EXT), U2.E13 (VDD_USB), U2.E17 (VDD_EXT), U2.G4 (VDD_EXT), U2.H4 (VDD_EXT), U2.H17 (VDD_EXT), U2.J4 (VDD_EXT), U2.J17 (VDD_EXT), U2.K4 (VDD_EXT), U2.K17 (VDD_EXT), U2.L4 (VDD_EXT), U2.L17 (VDD_EXT), U2.M4 (VDD_EXT), U2.M17 (VDD_EXT), U2.N17 (VDD_EXT), U2.R20 (VDD_HADC), U2.T4 (VDD_EXT), U2.U6 (VDD_EXT); also elsewhere on the board
GND: C1.2, C2.2, U2.A1 (GND), U2.A9 (GND), U2.A12 (GND), U2.A15 (GND), U2.A20 (GND), U2.B2 (GND), U2.B19 (GND), U2.C3 (GND), U2.C18 (GND), U2.D4 (GND), U2.D17 (GND), U2.E5 (GND), U2.E16 (GND), U2.F6 (GND), U2.F15 (GND), U2.G6 (GND), U2.G7 (GND), U2.G8 (GND), U2.G9 (GND), U2.G10 (GND), U2.G11 (GND), U2.G12 (GND), U2.G13 (GND), U2.G14 (GND), U2.G15 (GND), U2.H6 (GND), U2.H7 (GND), U2.H8 (GND), U2.H9 (GND), U2.H10 (GND), U2.H11 (GND), U2.H12 (GND), U2.H13 (GND), U2.H14 (GND), U2.H15 (GND), U2.J6 (GND), U2.J7 (GND), U2.J8 (GND), U2.J9 (GND), U2.J10 (GND), U2.J11 (GND), U2.J12 (GND), U2.J13 (GND), U2.J14 (GND), U2.J15 (GND), U2.K6 (GND), U2.K7 (GND), U2.K8 (GND), U2.K9 (GND), U2.K10 (GND), U2.K11 (GND), U2.K12 (GND), U2.K13 (GND), U2.K14 (GND), U2.K15 (GND), U2.L6 (GND), U2.L7 (GND), U2.L8 (GND), U2.L9 (GND), U2.L10 (GND), U2.L11 (GND), U2.L12 (GND), U2.L13 (GND), U2.L14 (GND), U2.L15 (GND), U2.L19 (GND), U2.M6 (GND), U2.M7 (GND), U2.M8 (GND), U2.M9 (GND), U2.M10 (GND), U2.M11 (GND), U2.M12 (GND), U2.M13 (GND), U2.M14 (GND), U2.M15 (GND), U2.N6 (GND), U2.N7 (GND), U2.N8 (GND), U2.N9 (GND), U2.N10 (GND), U2.N11 (GND), U2.N12 (GND), U2.N13 (GND), U2.N14 (GND), U2.N15 (GND), U2.N20 (GND), U2.P7 (GND), U2.P14 (GND), U2.R6 (GND), U2.R15 (GND), U2.T5 (GND), U2.T16 (GND), U2.U4 (GND), U2.U17 (GND), U2.V3 (GND), U2.V18 (GND), U2.W2 (GND), U2.W19 (GND), U2.Y1 (GND), U2.Y20 (GND); also elsewhere on the board

Notes on the sheet:
DSP Power
