twilkers1976/Omnisensor-dsp-board/cpu_board.kicad_pcb

## KiCad design cpu_board.kicad_pcb (continued)

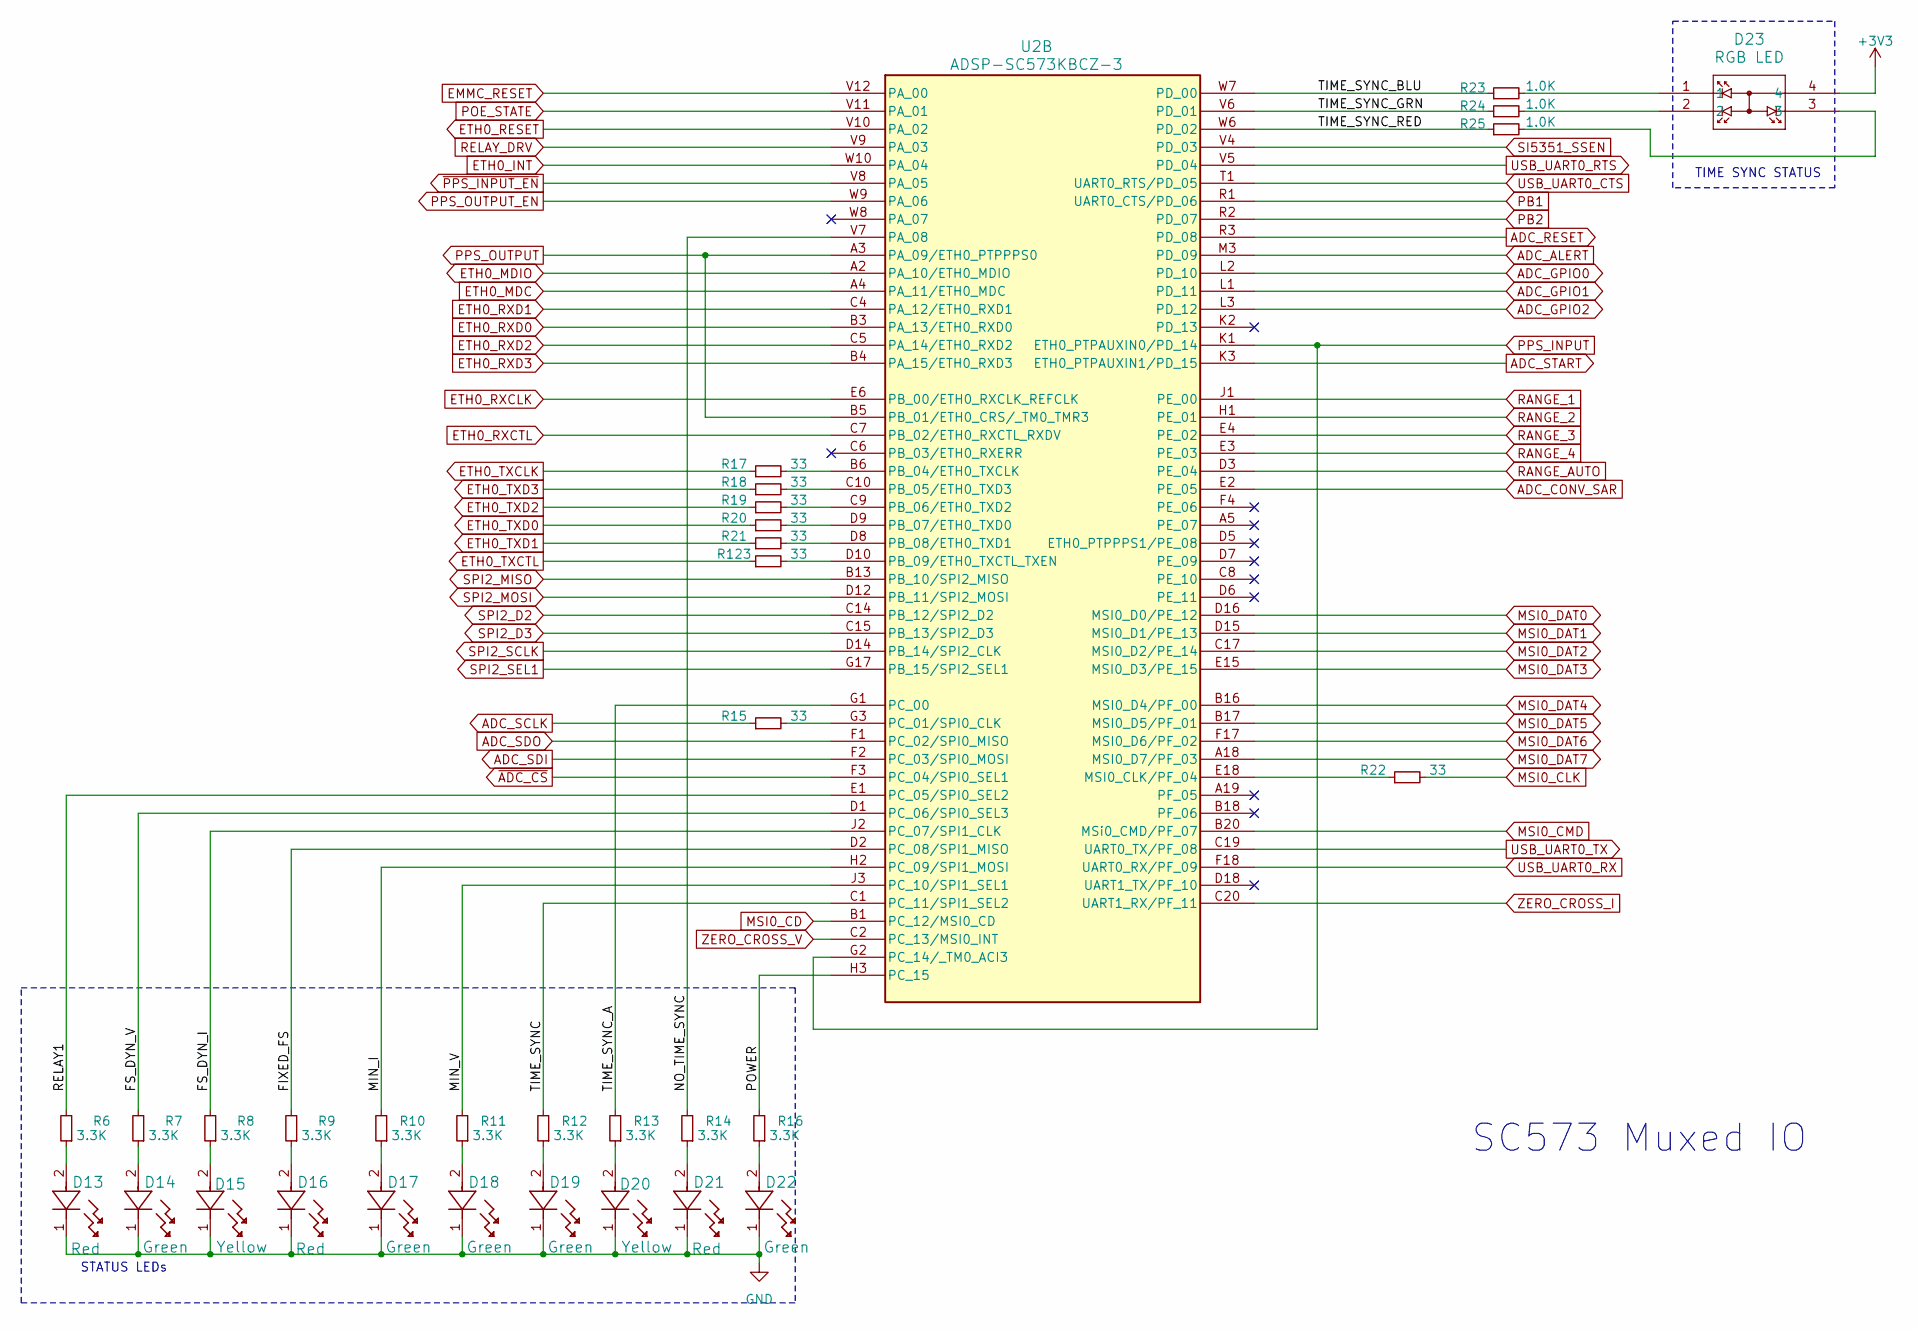
[picture p80: schematic dsp_ports.kicad_sch]

Parts:
D13, D16, D21: Red; LED_B1931NG_HVK; Part Number B1911USD-20D000114U1930
D14, D17, D18, D19, D22: Green; LED_B1931NG_HVK; Part Number B1931NG--20D001114U1930
D15, D20: Yellow; LED_B1931NG_HVK; Part Number KY EELP41.22 Q2T1-36-A8J8-020-R18
D23: RGB LED; SMD4_UHD111A-FKA_CRW; Part Number UHD111A-FKA-C3K23E1L3VG5ZB3Z3
R6, R7, R8, R9, R10, R11, R12, R13, R14, R16: 3.3K; R_0402_1005Metric; Part Number RMCF0402FT3K3
R15, R17, R18, R19, R20, R21, R22, R123: 33; R_0402_1005Metric; Part Number RMCF0402FT33R0
R23, R24, R25: 1.0K; R_0402_1005Metric; Rating 1/16 W; Part Number RMCF0402FT1K00
U2: ADSP-SC573KBCZ-3; BC-400-2_ADI; Part Number ADSP-SC573KBCZ-3

Connections:
+3V3: D23.4; also elsewhere on the board
/SC573/dsp_ports/FIXED_FS: R9.2, U2.D2 (PC_08/SPI1_MISO)
/SC573/dsp_ports/FS_DYN_I: R8.2, U2.J2 (PC_07/SPI1_CLK)
/SC573/dsp_ports/FS_DYN_V: R7.2, U2.D1 (PC_06/SPI0_SEL3)
/SC573/dsp_ports/MIN_I: R10.2, U2.H2 (PC_09/SPI1_MOSI)
/SC573/dsp_ports/MIN_V: R11.2, U2.J3 (PC_10/SPI1_SEL1)
/SC573/dsp_ports/NO_TIME_SYNC: R14.2, U2.V7 (PA_08)
/SC573/dsp_ports/POWER: R16.2, U2.H3 (PC_15)
/SC573/dsp_ports/RELAY1: R6.2, U2.E1 (PC_05/SPI0_SEL2)
/SC573/dsp_ports/TIME_SYNC: R12.2, U2.C1 (PC_11/SPI1_SEL2)
/SC573/dsp_ports/TIME_SYNC_A: R13.2, U2.G1 (PC_00)
/SC573/dsp_ports/TIME_SYNC_BLU: R23.1, U2.W7 (PD_00)
/SC573/dsp_ports/TIME_SYNC_GRN: R24.1, U2.V6 (PD_01)
/SC573/dsp_ports/TIME_SYNC_RED: R25.1, U2.W6 (PD_02)
ADC_ALERT: U2.M3 (PD_09); also elsewhere on the board
ADC_CONV_SAR: U2.E2 (PE_05); also elsewhere on the board
ADC_GPIO0: U2.L2 (PD_10); also elsewhere on the board
ADC_GPIO1: U2.L1 (PD_11); also elsewhere on the board
ADC_GPIO2: U2.L3 (PD_12); also elsewhere on the board
ADC_RESET: U2.R3 (PD_08); also elsewhere on the board
ADC_SCLK: R15.1; also elsewhere on the board
ADC_SDI: U2.F2 (PC_03/SPI0_MOSI); also elsewhere on the board
ADC_SDO: U2.F1 (PC_02/SPI0_MISO); also elsewhere on the board
ADC_START: U2.K3 (ETH0_PTPAUXIN1/PD_15); also elsewhere on the board
EMMC_RESET: U2.V12 (PA_00); also elsewhere on the board
ETH0_INT: U2.W10 (PA_04); also elsewhere on the board
ETH0_MDC: U2.A4 (PA_11/ETH0_MDC); also elsewhere on the board
ETH0_MDIO: U2.A2 (PA_10/ETH0_MDIO); also elsewhere on the board
ETH0_RESET: U2.V10 (PA_02); also elsewhere on the board
ETH0_RXCLK: U2.E6 (PB_00/ETH0_RXCLK_REFCLK); also elsewhere on the board
ETH0_RXCTL: U2.C7 (PB_02/ETH0_RXCTL_RXDV); also elsewhere on the board
ETH0_RXD0: U2.B3 (PA_13/ETH0_RXD0); also elsewhere on the board
ETH0_RXD1: U2.C4 (PA_12/ETH0_RXD1); also elsewhere on the board
ETH0_RXD2: U2.C5 (PA_14/ETH0_RXD2); also elsewhere on the board
ETH0_RXD3: U2.B4 (PA_15/ETH0_RXD3); also elsewhere on the board
ETH0_TXCLK: R17.1; also elsewhere on the board
ETH0_TXCTL: R123.1; also elsewhere on the board
ETH0_TXD0: R20.1; also elsewhere on the board
ETH0_TXD1: R21.1; also elsewhere on the board
ETH0_TXD2: R19.1; also elsewhere on the board
ETH0_TXD3: R18.1; also elsewhere on the board
GND: D13.1, D14.1, D15.1, D16.1, D17.1, D18.1, D19.1, D20.1, D21.1, D22.1; also elsewhere on the board
MSI0_CD: U2.B1 (PC_12/MSI0_CD); also elsewhere on the board
MSI0_CLK: R22.2; also elsewhere on the board
MSI0_CMD: U2.B20 (MSi0_CMD/PF_07); also elsewhere on the board
MSI0_DAT0: U2.D16 (MSI0_D0/PE_12); also elsewhere on the board
MSI0_DAT1: U2.D15 (MSI0_D1/PE_13); also elsewhere on the board
MSI0_DAT2: U2.C17 (MSI0_D2/PE_14); also elsewhere on the board
MSI0_DAT3: U2.E15 (MSI0_D3/PE_15); also elsewhere on the board
MSI0_DAT4: U2.B16 (MSI0_D4/PF_00); also elsewhere on the board
MSI0_DAT5: U2.B17 (MSI0_D5/PF_01); also elsewhere on the board
MSI0_DAT6: U2.F17 (MSI0_D6/PF_02); also elsewhere on the board
MSI0_DAT7: U2.A18 (MSI0_D7/PF_03); also elsewhere on the board
unnamed: D13.2, R6.1
unnamed: D14.2, R7.1
unnamed: D15.2, R8.1
unnamed: D16.2, R9.1
unnamed: D17.2, R10.1
unnamed: D18.2, R11.1
unnamed: D19.2, R12.1
unnamed: D20.2, R13.1
unnamed: D21.2, R14.1
unnamed: D22.2, R16.1
unnamed: D23.1, R23.2
unnamed: D23.2, R24.2
unnamed: D23.3, R25.2
unnamed: R22.1, U2.E18 (MSI0_CLK/PF_04)
unnamed: R17.2, U2.B6 (PB_04/ETH0_TXCLK)
unnamed: R18.2, U2.C10 (PB_05/ETH0_TXD3)
unnamed: R19.2, U2.C9 (PB_06/ETH0_TXD2)
unnamed: R20.2, U2.D9 (PB_07/ETH0_TXD0)
unnamed: R21.2, U2.D8 (PB_08/ETH0_TXD1)
unnamed: R123.2, U2.D10 (PB_09/ETH0_TXCTL_TXEN)
unnamed: R15.2, U2.G3 (PC_01/SPI0_CLK)
PB1: U2.R1 (UART0_CTS/PD_06); also elsewhere on the board
PB2: U2.R2 (PD_07); also elsewhere on the board
POE_STATE: U2.V11 (PA_01); also elsewhere on the board
PPS_INPUT: U2.G2 (PC_14/_TM0_ACI3), U2.K1 (ETH0_PTPAUXIN0/PD_14); also elsewhere on the board
PPS_OUTPUT: U2.A3 (PA_09/ETH0_PTPPPS0), U2.B5 (PB_01/ETH0_CRS/_TM0_TMR3); also elsewhere on the board
PPS_OUTPUT_EN: U2.W9 (PA_06); also elsewhere on the board
RANGE_1: U2.J1 (PE_00); also elsewhere on the board
RANGE_2: U2.H1 (PE_01); also elsewhere on the board
RANGE_3: U2.E4 (PE_02); also elsewhere on the board
RANGE_4: U2.E3 (PE_03); also elsewhere on the board
RANGE_AUTO: U2.D3 (PE_04); also elsewhere on the board
RELAY_DRV: U2.V9 (PA_03); also elsewhere on the board
SI5351_SSEN: U2.V4 (PD_03); also elsewhere on the board
SPI2_D2: U2.C14 (PB_12/SPI2_D2); also elsewhere on the board
SPI2_D3: U2.C15 (PB_13/SPI2_D3); also elsewhere on the board
SPI2_MISO: U2.B13 (PB_10/SPI2_MISO); also elsewhere on the board
SPI2_MOSI: U2.D12 (PB_11/SPI2_MOSI); also elsewhere on the board
SPI2_SCLK: U2.D14 (PB_14/SPI2_CLK); also elsewhere on the board
SPI2_SEL1: U2.G17 (PB_15/SPI2_SEL1); also elsewhere on the board
USB_UART0_CTS: U2.T1 (UART0_RTS/PD_05); also elsewhere on the board
USB_UART0_RTS: U2.V5 (PD_04); also elsewhere on the board
USB_UART0_RX: U2.F18 (UART0_RX/PF_09); also elsewhere on the board
USB_UART0_TX: U2.C19 (UART0_TX/PF_08); also elsewhere on the board
ZERO_CROSS_I: U2.C20 (UART1_RX/PF_11); also elsewhere on the board
ZERO_CROSS_V: U2.C2 (PC_13/MSI0_INT); also elsewhere on the board
~ADC_CS: U2.F3 (PC_04/SPI0_SEL1); also elsewhere on the board
~PPS_INPUT_EN: U2.V8 (PA_05); also elsewhere on the board

Notes on the sheet:
STATUS LEDs
TIME SYNC STATUS
SC573 Muxed IO

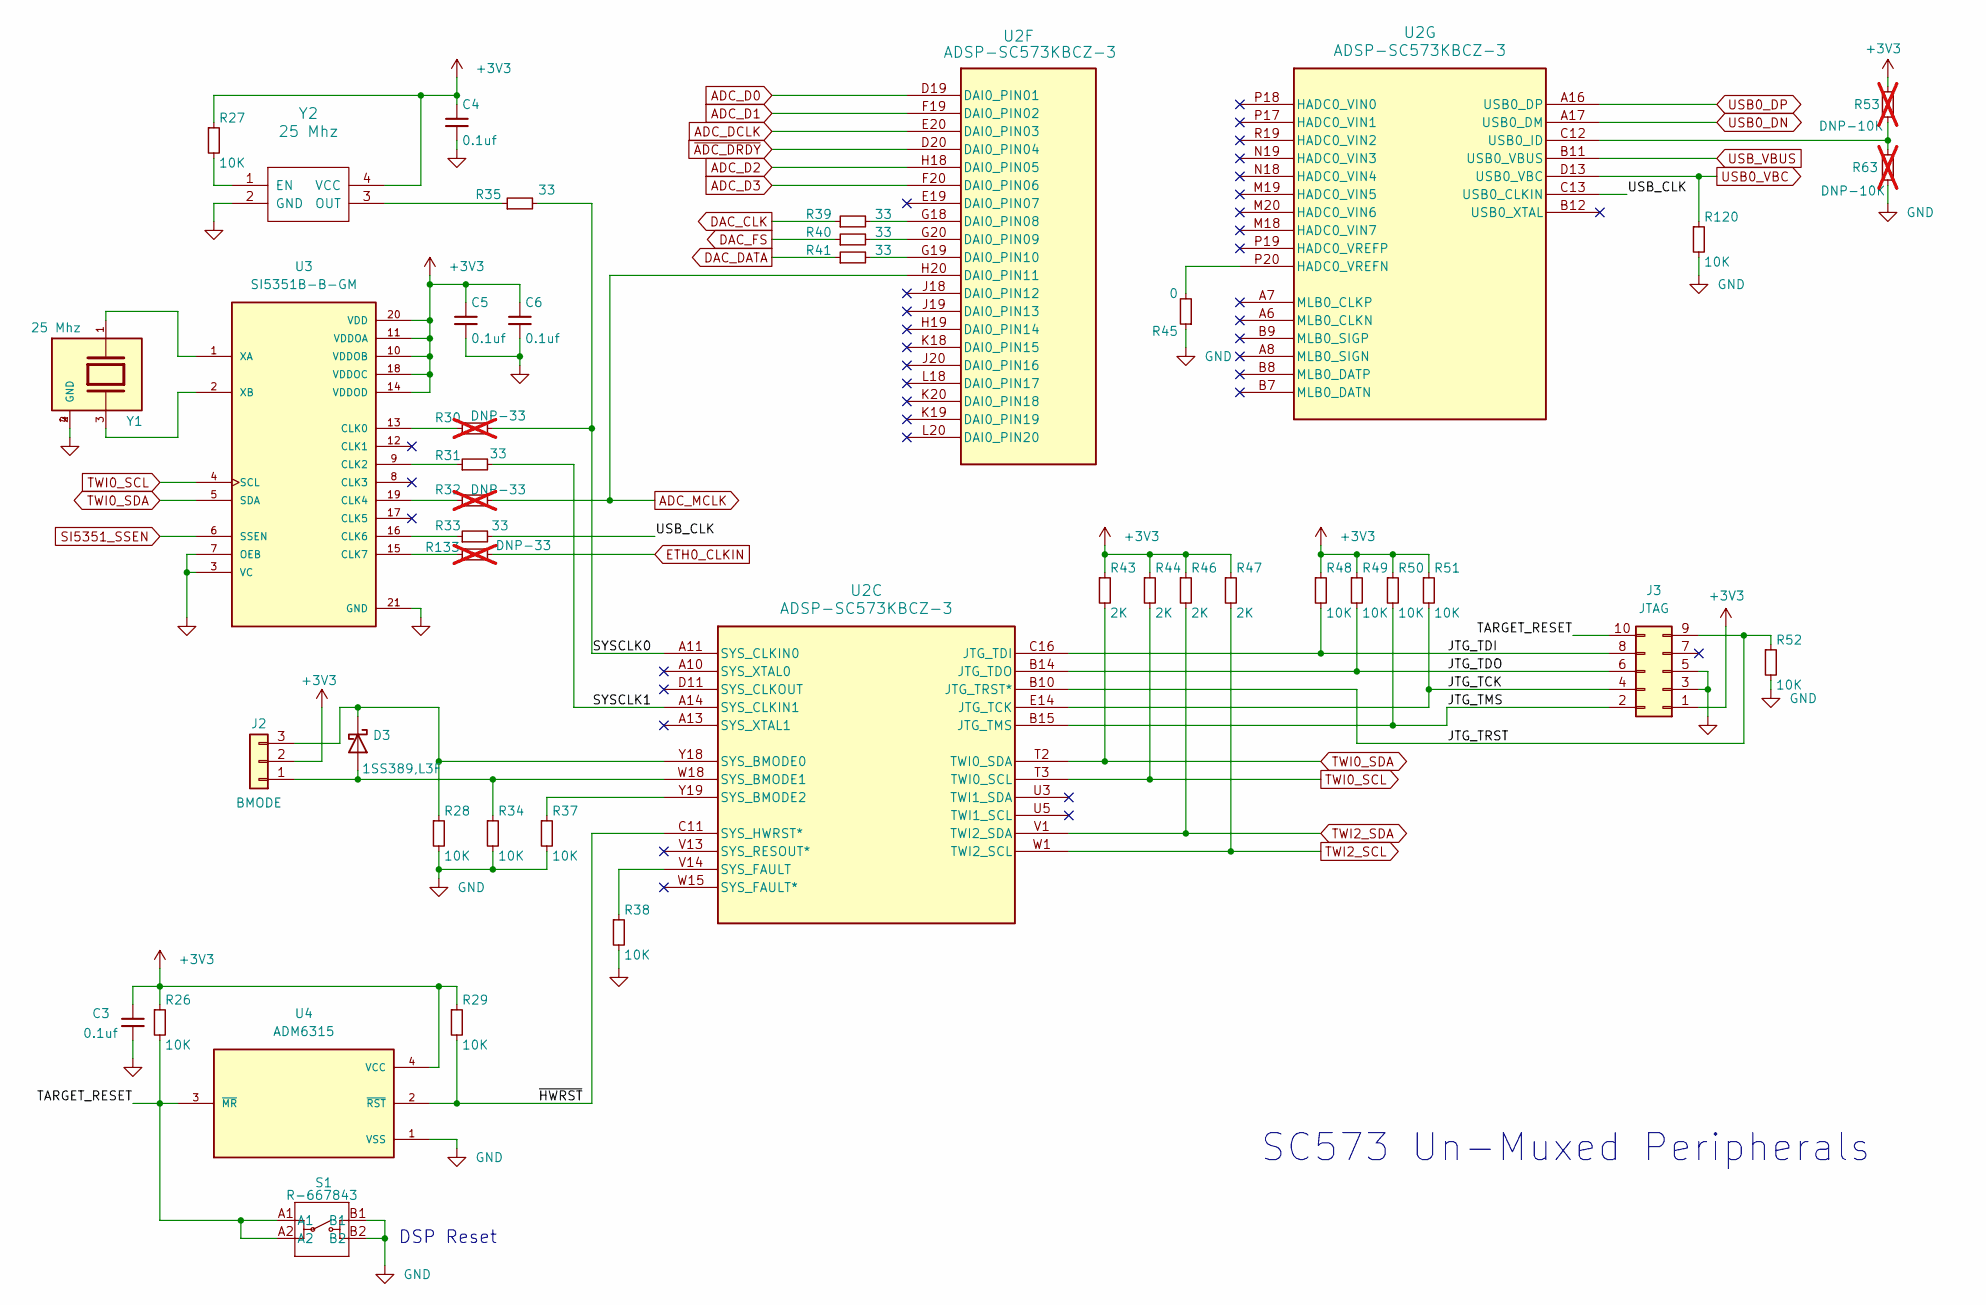
[picture p81: schematic sc573_system.kicad_sch]

Parts:
C3, C4, C5, C6: 0.1uf; C_0402_1005Metric; Rating 50V; Part Number 04025C104KAT2A
D3: 1SS389,L3F; D_SOD-523; Part Number 1SS389,L3F
J2: BMODE; PinHeader_1x03_P2.00mm_Vertical; Part Number 2PH1-03-UA
J3: JTAG; CNC_3220-10-0300-00; Part Number 3220-10-0300-00
R26, R27, R28, R29, R34, R37, R38, R48, R49, R50, R51, R52, R120: 10K; R_0402_1005Metric; Part Number RMCF0402FT10K0
R30, R32, R133: DNP-33; R_0402_1005Metric; Part Number RMCF0402FT33R0; not fitted
R31, R33, R35, R39, R40, R41: 33; R_0402_1005Metric; Part Number RMCF0402FT33R0
R43, R44, R46, R47: 2K; R_0402_1005Metric; Part Number RMCF0402FT2K00
R45: 0; R_0402_1005Metric; Part Number RMCF0402ZT0R00
R53, R63: DNP-10K; R_0402_1005Metric; Part Number RMCF0402FT10K; not fitted
S1: R-667843; R-667843_MIT; PARTREV 14 Apr 22
U2: ADSP-SC573KBCZ-3; BC-400-2_ADI; Part Number ADSP-SC573KBCZ-3
U3: SI5351B-B-GM; QFN50P400X400X90-21N; PARTREV 1.0
U4: ADM6315; RA_4_ADI; PARTREV 5
Y1: 25 Mhz; CRYSTAL_4SMD_3.2MM_2.5MM; Part Number ABM8-25.000MHZ-10-B1U-T
Y2: 25 Mhz; OSC_4SMD_2.5MM_2.0MM; Part Number ECS-2520S33-250-FN-TR

Connections:
+3V3: C3.1, C4.1, C5.1, C6.1, J2.2, J3.1, R26.1, R27.1, R29.1, R43.1, R44.1, R46.1, R47.1, R48.1, R49.1, R50.1, R51.1, R53.1, U3.10 (VDDOB), U3.11 (VDDOA), U3.14 (VDDOD), U3.18 (VDDOC), U3.20 (VDD), U4.4 (VCC), Y2.4 (VCC); also elsewhere on the board
/SC573/sc573_system/JTG_TCK: J3.4, R51.2, U2.E14 (JTG_TCK)
/SC573/sc573_system/JTG_TDI: J3.8, R48.2, U2.C16 (JTG_TDI)
/SC573/sc573_system/JTG_TDO: J3.6, R49.2, U2.B14 (JTG_TDO)
/SC573/sc573_system/JTG_TMS: J3.2, R50.2, U2.B15 (JTG_TMS)
/SC573/sc573_system/JTG_TRST: J3.9, R52.1, U2.B10 (JTG_TRST*)
/SC573/sc573_system/SYSCLK0: R30.2, R35.2, U2.A11 (SYS_CLKIN0)
/SC573/sc573_system/SYSCLK1: R31.2, U2.A14 (SYS_CLKIN1)
/SC573/sc573_system/TARGET_RESET: J3.10, R26.2, S1.A1, S1.A2, U4.3 (~MR)
/SC573/sc573_system/USB_CLK: R33.2, U2.C13 (USB0_CLKIN)
/SC573/sc573_system/~HWRST: R29.2, U2.C11 (SYS_HWRST*), U4.2 (~RST)
ADC_D0: U2.D19 (DAI0_PIN01); also elsewhere on the board
ADC_D1: U2.F19 (DAI0_PIN02); also elsewhere on the board
ADC_D2: U2.H18 (DAI0_PIN05); also elsewhere on the board
ADC_D3: U2.F20 (DAI0_PIN06); also elsewhere on the board
ADC_DCLK: U2.E20 (DAI0_PIN03); also elsewhere on the board
ADC_MCLK: R32.2, U2.H20 (DAI0_PIN11); also elsewhere on the board
DAC_CLK: R39.1; also elsewhere on the board
DAC_DATA: R41.1; also elsewhere on the board
DAC_FS: R40.1; also elsewhere on the board
ETH0_CLKIN: R133.2; also elsewhere on the board
GND: C3.2, C4.2, C5.2, C6.2, J3.3, J3.5, R28.2, R34.2, R37.2, R38.2, R45.1, R52.2, R63.2, R120.2, S1.B1, S1.B2, U3.3 (VC), U3.7 (OEB), U3.21 (GND), U4.1 (VSS), Y1.2 (GND), Y1.4 (GND), Y2.2 (GND); also elsewhere on the board
unnamed: D3.2 (A), J2.1, R34.1, U2.W18 (SYS_BMODE1)
unnamed: D3.1 (K), J2.3, R28.1, U2.Y18 (SYS_BMODE0)
unnamed: R37.1, U2.Y19 (SYS_BMODE2)
unnamed: R38.1, U2.V14 (SYS_FAULT)
unnamed: R39.2, U2.G18 (DAI0_PIN08)
unnamed: R40.2, U2.G20 (DAI0_PIN09)
unnamed: R41.2, U2.G19 (DAI0_PIN10)
unnamed: R45.2, U2.P20 (HADC0_VREFN)
unnamed: R53.2, R63.1, U2.C12 (USB0_ID)
unnamed: R30.1, U3.13 (CLK0)
unnamed: R31.1, U3.9 (CLK2)
unnamed: R32.1, U3.19 (CLK4)
unnamed: R33.1, U3.16 (CLK6)
unnamed: R133.1, U3.15 (CLK7)
unnamed: U3.1 (XA), Y1.1
unnamed: U3.2 (XB), Y1.3
unnamed: R27.2, Y2.1 (EN)
unnamed: R35.1, Y2.3 (OUT)
SI5351_SSEN: U3.6 (SSEN); also elsewhere on the board
TWI0_SCL: R44.2, U2.T3 (TWI0_SCL), U3.4 (SCL); also elsewhere on the board
TWI0_SDA: R43.2, U2.T2 (TWI0_SDA), U3.5 (SDA); also elsewhere on the board
TWI2_SCL: R47.2, U2.W1 (TWI2_SCL); also elsewhere on the board
TWI2_SDA: R46.2, U2.V1 (TWI2_SDA); also elsewhere on the board
USB0_DN: U2.A17 (USB0_DM); also elsewhere on the board
USB0_DP: U2.A16 (USB0_DP); also elsewhere on the board
USB0_VBC: R120.1, U2.D13 (USB0_VBC); also elsewhere on the board
USB_VBUS: U2.B11 (USB0_VBUS); also elsewhere on the board
~ADC_DRDY: U2.D20 (DAI0_PIN04); also elsewhere on the board

Notes on the sheet:
SC573 Un-Muxed Peripherals
DSP Reset

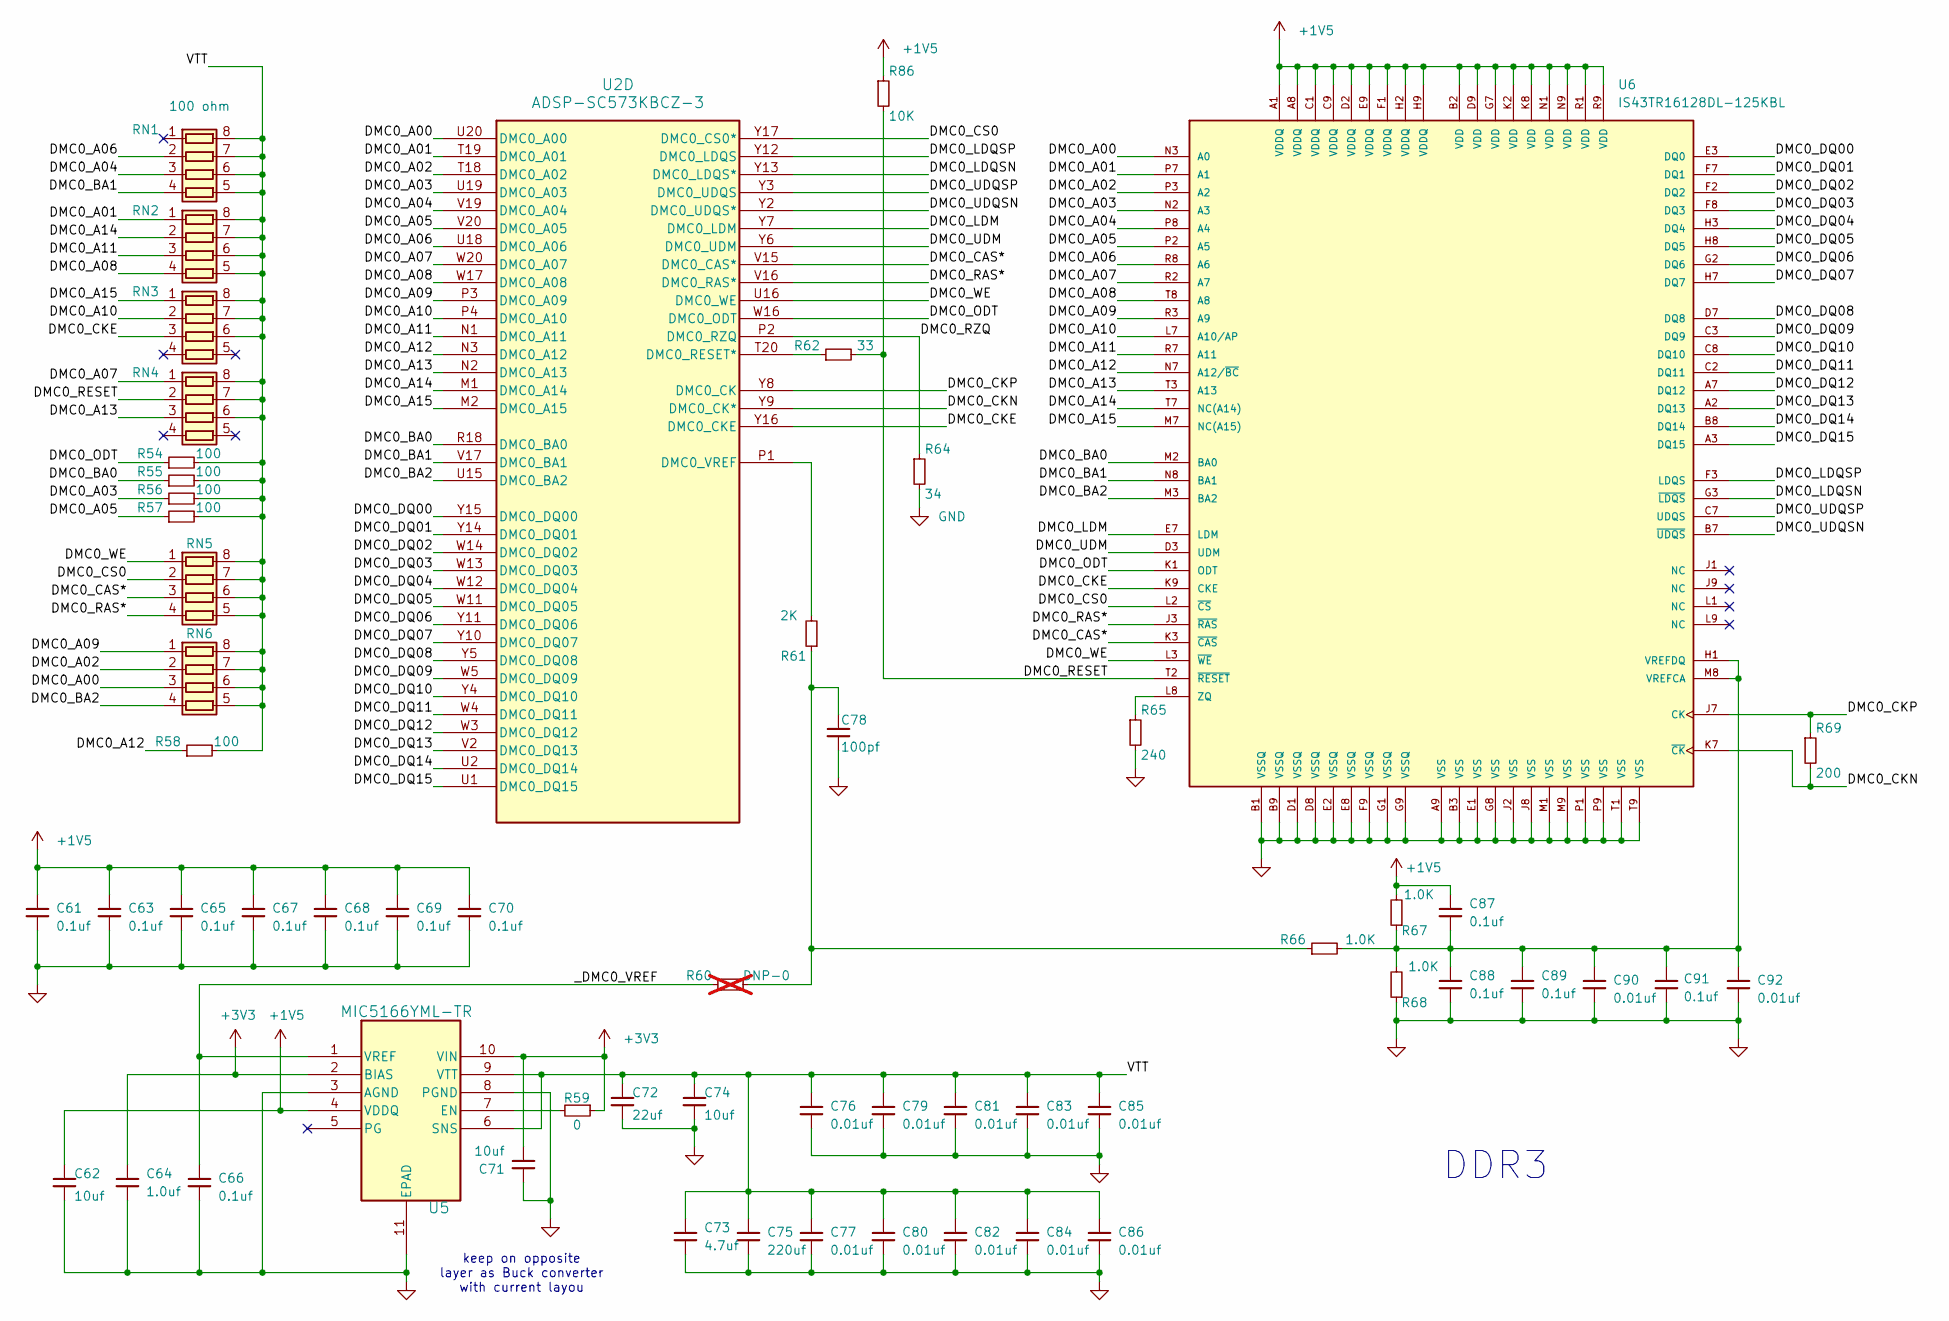
[picture p82: schematic ddr.kicad_sch]

Parts:
C61, C63, C65, C66, C67, C68, C69, C70, C87, C88, C89, C91: 0.1uf; C_0402_1005Metric; Rating 50V; Part Number 04025C104KAT2A
C62, C71, C74: 10uf; C_0603_1608Metric; Rating 16V; Part Number GRM188R61C106MAALD
C64: 1.0uf; C_0402_1005Metric; Rating 16V; Part Number EMK105BJ105KV-F
C72: 22uf; C_0603_1608Metric; Rating 6.3V; Part Number C1608X5R0J226M080AC
C73: 4.7uf; C_0402_1005Metric; Rating 6.3V; Part Number JMK105BBJ475MV-F
C75: 220uf; C_1206_3216Metric; Rating 6.3V; Part Number GMC31X5R227M6R3NT
C76, C77, C79, C80, C81, C82, C83, C84, C85, C86, C90, C92: 0.01uf; C_0402_1005Metric; Rating 50V; Part Number 04025C103KAT2A
C78: 100pf; C_0402_1005Metric; Rating 50V; Part Number KGM05AR71H101KH
R54, R55, R56, R57, R58: 100; R_0402_1005Metric; Part Number RMCF0402FT100R
R59: 0; R_0402_1005Metric; Part Number RMCF0402ZT0R00
R60: DNP-0; R_0603_1608Metric; Part Number RMCF0603FT0R; not fitted
R61: 2K; R_0402_1005Metric; Part Number RMCF0402FT2K0
R62: 33; R_0402_1005Metric; Part Number RMCF0402FT33R0
R64: 34; R_0402_1005Metric; Part Number RMCF0402FT34R0
R65: 240; R_0402_1005Metric; Part Number RMCF0402FT240R
R66, R67, R68: 1.0K; R_0402_1005Metric; Rating 1/16 W; Part Number RMCF0402FT1K00
R69: 200; R_0402_1005Metric; Part Number RMCF0402FT200R
R86: 10K; R_0402_1005Metric; Part Number RMCF0402FT10K0
RN1, RN2, RN3, RN4, RN5, RN6: 100 ohm; RESCAXS50P200X100X45-8N; Part Number EXB-28V101JX
U2: ADSP-SC573KBCZ-3; BC-400-2_ADI; Part Number ADSP-SC573KBCZ-3
U5: MIC5166YML-TR; MLF-10_ML_MCH; Part Number MIC5166YML-TR
U6: IS43TR16128DL-125KBL; BGA80P96C6X16_800X1400X110; Part Number IS43TR16128DL-125KBL

Connections:
+1V5: C61.1, C62.1, C63.1, C65.1, C67.1, C68.1, C69.1, C70.1, C87.1, R67.2, R86.1, U5.4 (VDDQ), U6.A1 (VDDQ), U6.A8 (VDDQ), U6.B2 (VDD), U6.C1 (VDDQ), U6.C9 (VDDQ), U6.D2 (VDDQ), U6.D9 (VDD), U6.E9 (VDDQ), U6.F1 (VDDQ), U6.G7 (VDD), U6.H2 (VDDQ), U6.H9 (VDDQ), U6.K2 (VDD), U6.K8 (VDD), U6.N1 (VDD), U6.N9 (VDD), U6.R1 (VDD), U6.R9 (VDD); also elsewhere on the board
+3V3: C64.1, C71.2, R59.1, U5.2 (BIAS), U5.10 (VIN); also elsewhere on the board
/SC573/ddr/DMC0_A00: RN6.3 (R3.1), U2.U20 (DMC0_A00), U6.N3 (A0)
/SC573/ddr/DMC0_A01: RN2.1 (R1.1), U2.T19 (DMC0_A01), U6.P7 (A1)
/SC573/ddr/DMC0_A02: RN6.2 (R2.1), U2.T18 (DMC0_A02), U6.P3 (A2)
/SC573/ddr/DMC0_A03: R56.1, U2.U19 (DMC0_A03), U6.N2 (A3)
/SC573/ddr/DMC0_A04: RN1.3 (R3.1), U2.V19 (DMC0_A04), U6.P8 (A4)
/SC573/ddr/DMC0_A05: R57.1, U2.V20 (DMC0_A05), U6.P2 (A5)
/SC573/ddr/DMC0_A06: RN1.2 (R2.1), U2.U18 (DMC0_A06), U6.R8 (A6)
/SC573/ddr/DMC0_A07: RN4.1 (R1.1), U2.W20 (DMC0_A07), U6.R2 (A7)
/SC573/ddr/DMC0_A08: RN2.4 (R4.1), U2.W17 (DMC0_A08), U6.T8 (A8)
/SC573/ddr/DMC0_A09: RN6.1 (R1.1), U2.P3 (DMC0_A09), U6.R3 (A9)
/SC573/ddr/DMC0_A10: RN3.2 (R2.1), U2.P4 (DMC0_A10), U6.L7 (A10/AP)
/SC573/ddr/DMC0_A11: RN2.3 (R3.1), U2.N1 (DMC0_A11), U6.R7 (A11)
/SC573/ddr/DMC0_A12: R58.1, U2.N3 (DMC0_A12), U6.N7 (A12/~BC)
/SC573/ddr/DMC0_A13: RN4.3 (R3.1), U2.N2 (DMC0_A13), U6.T3 (A13)
/SC573/ddr/DMC0_A14: RN2.2 (R2.1), U2.M1 (DMC0_A14), U6.T7 (NC(A14))
/SC573/ddr/DMC0_A15: RN3.1 (R1.1), U2.M2 (DMC0_A15), U6.M7 (NC(A15))
/SC573/ddr/DMC0_BA0: R55.1, U2.R18 (DMC0_BA0), U6.M2 (BA0)
/SC573/ddr/DMC0_BA1: RN1.4 (R4.1), U2.V17 (DMC0_BA1), U6.N8 (BA1)
/SC573/ddr/DMC0_BA2: RN6.4 (R4.1), U2.U15 (DMC0_BA2), U6.M3 (BA2)
/SC573/ddr/DMC0_CAS*: RN5.3 (R3.1), U2.V15 (DMC0_CAS*), U6.K3 (~CAS)
/SC573/ddr/DMC0_CKE: RN3.3 (R3.1), U2.Y16 (DMC0_CKE), U6.K9 (CKE)
/SC573/ddr/DMC0_CKN: R69.2, U2.Y9 (DMC0_CK*), U6.K7 (~CK)
/SC573/ddr/DMC0_CKP: R69.1, U2.Y8 (DMC0_CK), U6.J7 (CK)
/SC573/ddr/DMC0_CS0: RN5.2 (R2.1), U2.Y17 (DMC0_CS0*), U6.L2 (~CS)
/SC573/ddr/DMC0_DQ00: U2.Y15 (DMC0_DQ00), U6.E3 (DQ0)
/SC573/ddr/DMC0_DQ01: U2.Y14 (DMC0_DQ01), U6.F7 (DQ1)
/SC573/ddr/DMC0_DQ02: U2.W14 (DMC0_DQ02), U6.F2 (DQ2)
/SC573/ddr/DMC0_DQ03: U2.W13 (DMC0_DQ03), U6.F8 (DQ3)
/SC573/ddr/DMC0_DQ04: U2.W12 (DMC0_DQ04), U6.H3 (DQ4)
/SC573/ddr/DMC0_DQ05: U2.W11 (DMC0_DQ05), U6.H8 (DQ5)
/SC573/ddr/DMC0_DQ06: U2.Y11 (DMC0_DQ06), U6.G2 (DQ6)
/SC573/ddr/DMC0_DQ07: U2.Y10 (DMC0_DQ07), U6.H7 (DQ7)
/SC573/ddr/DMC0_DQ08: U2.Y5 (DMC0_DQ08), U6.D7 (DQ8)
/SC573/ddr/DMC0_DQ09: U2.W5 (DMC0_DQ09), U6.C3 (DQ9)
/SC573/ddr/DMC0_DQ10: U2.Y4 (DMC0_DQ10), U6.C8 (DQ10)
/SC573/ddr/DMC0_DQ11: U2.W4 (DMC0_DQ11), U6.C2 (DQ11)
/SC573/ddr/DMC0_DQ12: U2.W3 (DMC0_DQ12), U6.A7 (DQ12)
/SC573/ddr/DMC0_DQ13: U2.V2 (DMC0_DQ13), U6.A2 (DQ13)
/SC573/ddr/DMC0_DQ14: U2.U2 (DMC0_DQ14), U6.B8 (DQ14)
/SC573/ddr/DMC0_DQ15: U2.U1 (DMC0_DQ15), U6.A3 (DQ15)
/SC573/ddr/DMC0_LDM: U2.Y7 (DMC0_LDM), U6.E7 (LDM)
/SC573/ddr/DMC0_LDQSN: U2.Y13 (DMC0_LDQS*), U6.G3 (~LDQS)
/SC573/ddr/DMC0_LDQSP: U2.Y12 (DMC0_LDQS), U6.F3 (LDQS)
/SC573/ddr/DMC0_ODT: R54.1, U2.W16 (DMC0_ODT), U6.K1 (ODT)
/SC573/ddr/DMC0_RAS*: RN5.4 (R4.1), U2.V16 (DMC0_RAS*), U6.J3 (~RAS)
/SC573/ddr/DMC0_RESET: R62.2, R86.2, RN4.2 (R2.1), U6.T2 (~RESET)
/SC573/ddr/DMC0_RZQ: R64.1, U2.P2 (DMC0_RZQ)
/SC573/ddr/DMC0_UDM: U2.Y6 (DMC0_UDM), U6.D3 (UDM)
/SC573/ddr/DMC0_UDQSN: U2.Y2 (DMC0_UDQS*), U6.B7 (~UDQS)
/SC573/ddr/DMC0_UDQSP: U2.Y3 (DMC0_UDQS), U6.C7 (UDQS)
/SC573/ddr/DMC0_WE: RN5.1 (R1.1), U2.U16 (DMC0_WE), U6.L3 (~WE)
/SC573/ddr/VTT: C72.1, C73.1, C74.1, C75.1, C76.1, C77.1, C79.1, C80.1, C81.1, C82.1, C83.1, C84.1, C85.1, C86.1, R54.2, R55.2, R56.2, R57.2, R58.2, RN1.5 (R4.2), RN1.6 (R3.2), RN1.7 (R2.2), RN1.8 (R1.2), RN2.5 (R4.2), RN2.6 (R3.2), RN2.7 (R2.2), RN2.8 (R1.2), RN3.6 (R3.2), RN3.7 (R2.2), RN3.8 (R1.2), RN4.6 (R3.2), RN4.7 (R2.2), RN4.8 (R1.2), RN5.5 (R4.2), RN5.6 (R3.2), RN5.7 (R2.2), RN5.8 (R1.2), RN6.5 (R4.2), RN6.6 (R3.2), RN6.7 (R2.2), RN6.8 (R1.2), U5.6 (SNS), U5.9 (VTT)
/SC573/ddr/_DMC0_VREF: C66.1, R60.1, U5.1 (VREF)
GND: C61.2, C62.2, C63.2, C64.2, C65.2, C66.2, C67.2, C68.2, C69.2, C70.2, C71.1, C72.2, C73.2, C74.2, C75.2, C76.2, C77.2, C78.2, C79.2, C80.2, C81.2, C82.2, C83.2, C84.2, C85.2, C86.2, C88.2, C89.2, C90.2, C91.2, C92.2, R64.2, R65.2, R68.1, U5.3 (AGND), U5.8 (PGND), U5.11 (EPAD), U6.A9 (VSS), U6.B1 (VSSQ), U6.B3 (VSS), U6.B9 (VSSQ), U6.D1 (VSSQ), U6.D8 (VSSQ), U6.E1 (VSS), U6.E2 (VSSQ), U6.E8 (VSSQ), U6.F9 (VSSQ), U6.G1 (VSSQ), U6.G8 (VSS), U6.G9 (VSSQ), U6.J2 (VSS), U6.J8 (VSS), U6.M1 (VSS), U6.M9 (VSS), U6.P1 (VSS), U6.P9 (VSS), U6.T1 (VSS), U6.T9 (VSS); also elsewhere on the board
unnamed: C78.1, R60.2, R61.1, R66.1
unnamed: R62.1, U2.T20 (DMC0_RESET*)
unnamed: R61.2, U2.P1 (DMC0_VREF)
unnamed: R59.2, U5.7 (EN)
unnamed: C87.2, C88.1, C89.1, C90.1, C91.1, C92.1, R66.2, R67.1, R68.2, U6.H1 (VREFDQ), U6.M8 (VREFCA)
unnamed: R65.1, U6.L8 (ZQ)

Notes on the sheet:
keep on opposite layer as Buck converter with current layou
DDR3

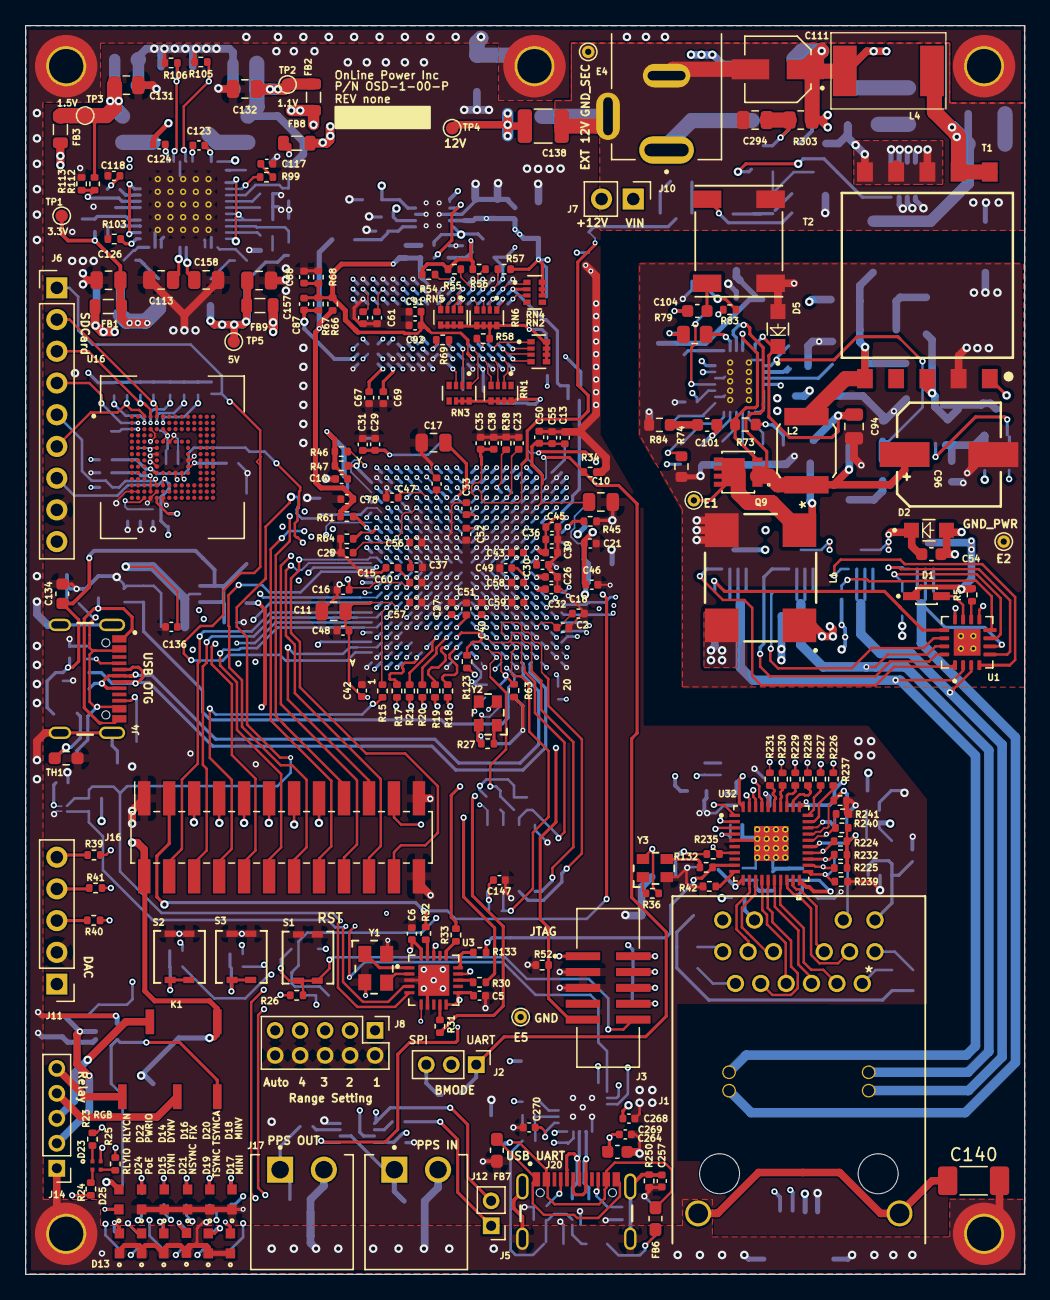
[picture p83: board cpu_board.kicad_pcb from above]

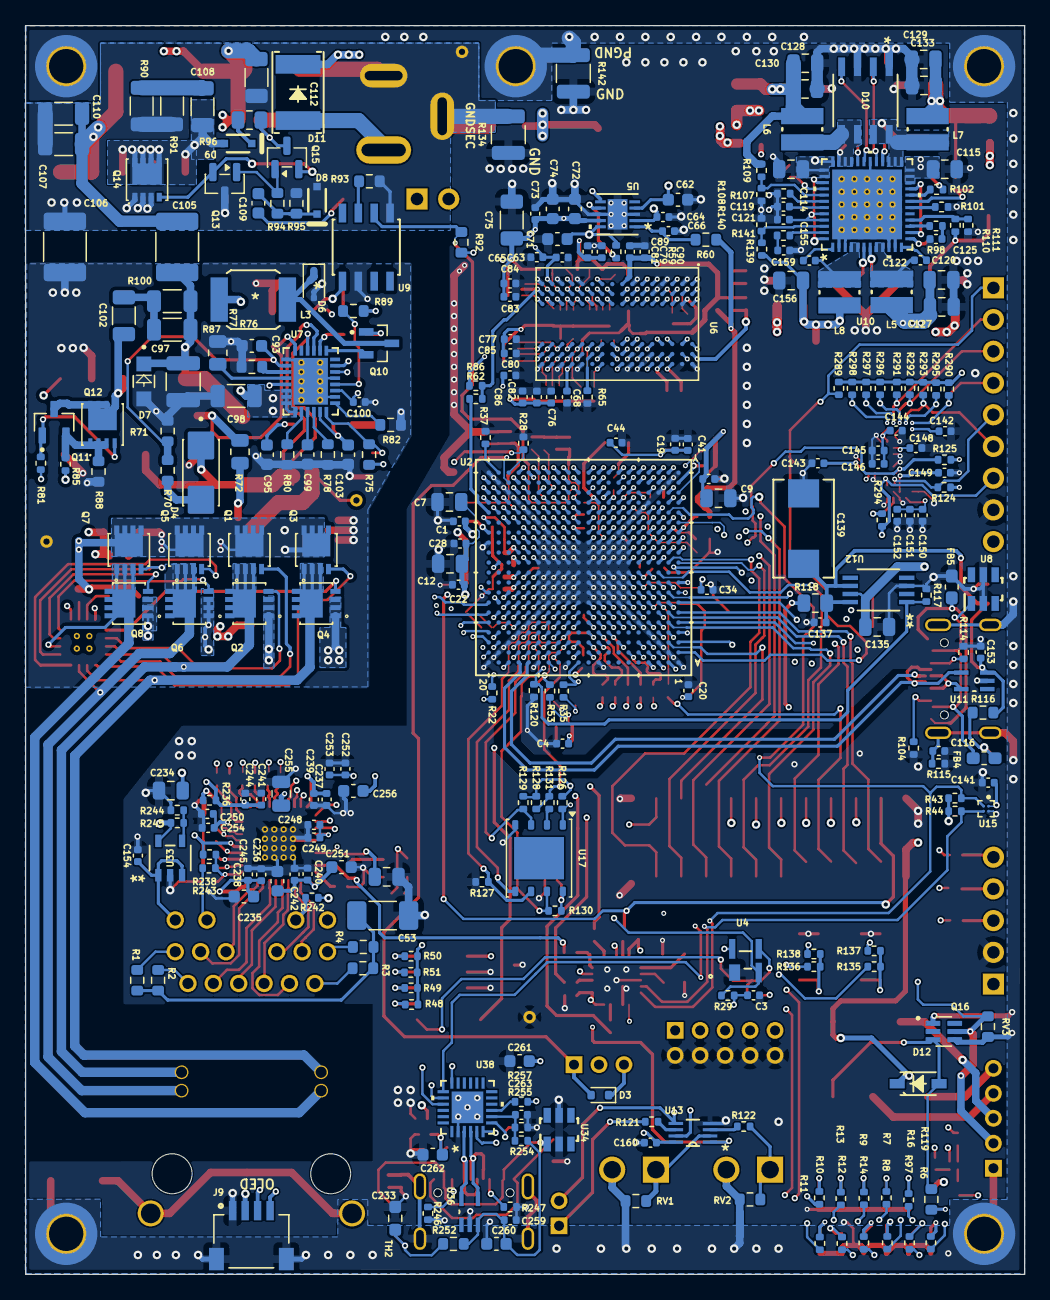
[picture p84: board cpu_board.kicad_pcb from below]

Board: 10 copper layers, 80.0 x 100.0 mm, 501 parts (276 on the bottom side), 367 nets.
