twilkers1976/Omnisensor-dsp-board/(commit log)

2026-10-08 initial commit, first prototype build
2026-10-08 post prototype build edits clean U32 under ic edits beef up relay traces
2026-10-20 fix range and relay connector part numbers
